gallicchio/motor-pid/out/motorpid/motorpid-stats.txt

PCB statistics report
=====================
- Date: 2026-10-29
- Project: motorpid
- Board name: motorpid

Board
-----
- Width: 170.0000 mm
- Height: 120.0000 mm
- Area: 20392.261 mm²
- Front copper area: 3160.727 mm²
- Back copper area: 19553.33 mm²
- Min track clearance: 0.3000 mm
- Min track width: 0.3500 mm
- Min drill diameter: 0.3000 mm
- Board stackup thickness: 1.6000 mm

- Front footprint area: 3687.488 mm²
- Back footprint area: 279.936 mm²
- Front component density: 18.08 %
- Back component density: 1.37 %
Pads
----
- Through hole: 40
- SMD: 229
- Connector: 0
- NPTH: 14
- Castellated: 0
- Press-fit: 0

Vias
----
- Through vias: 75
- Blind vias: 0
- Buried vias: 0
- Micro vias: 0

Components
----------

| | Front Side | Back Side | Total |
|---|---|---|---|
|THT: | 11 | 0 | 11 |
|SMD: | 95 | 0 | 95 |
|Unspecified:  | 4 | 0 | 4 |
|Total: | 110 | 0 | 110 |

Drill holes
-----------

| Count | Shape | X Size | Y Size | Plated | Via/Pad | Start Layer | Stop Layer |
|---|---|---|---|---|---|---|---|
| 75 | Round | 0.3000 mm | 0.3000 mm | PTH | Via | F.Cu | B.Cu |
| 21 | Round | 1.4000 mm | 1.4000 mm | PTH | Pad | F.Cu | B.Cu |
| 10 |  Slot | 0.9000 mm | 1.4500 mm | NPTH | Pad | F.Cu | B.Cu |
| 9 | Round | 0.9000 mm | 0.9000 mm | PTH | Pad | F.Cu | B.Cu |
| 4 | Round | 3.2000 mm | 3.2000 mm | NPTH | Pad | F.Cu | B.Cu |
| 3 | Round | 1.3000 mm | 1.3000 mm | PTH | Pad | F.Cu | B.Cu |
| 3 | Round | 1.0000 mm | 1.0000 mm | PTH | Pad | F.Cu | B.Cu |
| 2 | Round | 1.2000 mm | 1.2000 mm | PTH | Pad | F.Cu | B.Cu |
| 2 |  Slot | 2.1000 mm | 1.8000 mm | PTH | Pad | F.Cu | B.Cu |
