gallicchio/motor-pid/design_reviews/2026-10-26_Claude-Opus-5.5/q_tr.png

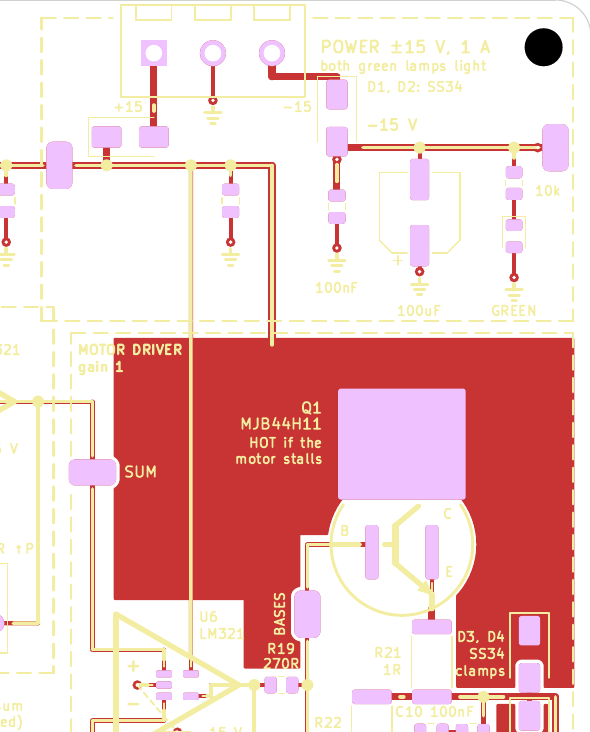
design_reviews/2026-10-26_Claude-Opus-5.5/q_tr.png
