gallicchio/motor-pid/design_reviews/2026-10-26_Claude-Opus-5.5/z_patch_sw12.png

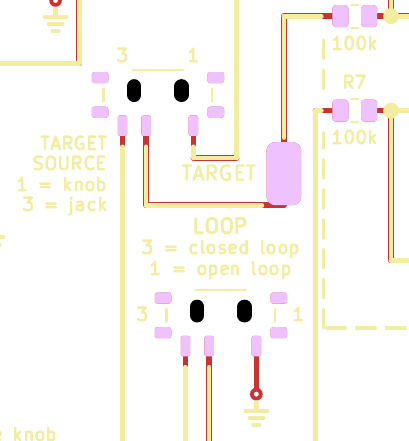
design_reviews/2026-10-26_Claude-Opus-5.5/z_patch_sw12.png
