gallicchio/motor-pid/design_reviews/2026-10-27_KimiK3/bot_q4.png

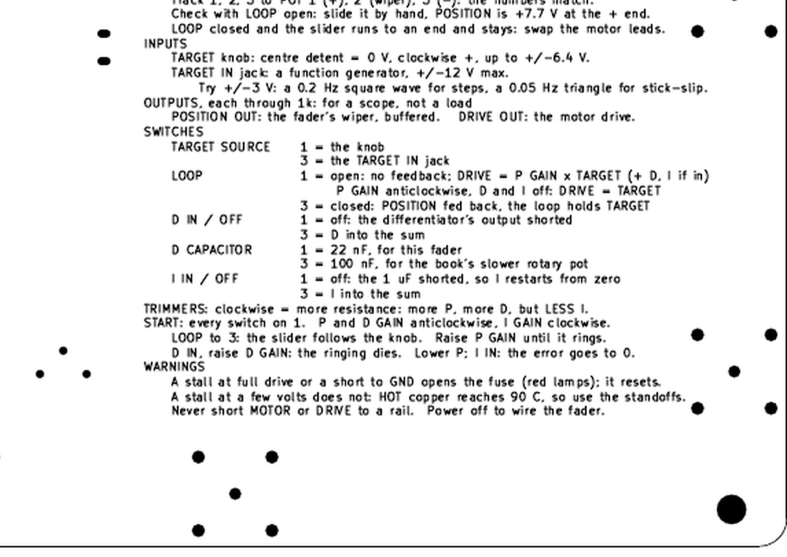
design_reviews/2026-10-27_KimiK3/bot_q4.png
