gallicchio/motor-pid/design_reviews/2026-10-27_KimiK3/sch_targetin.png

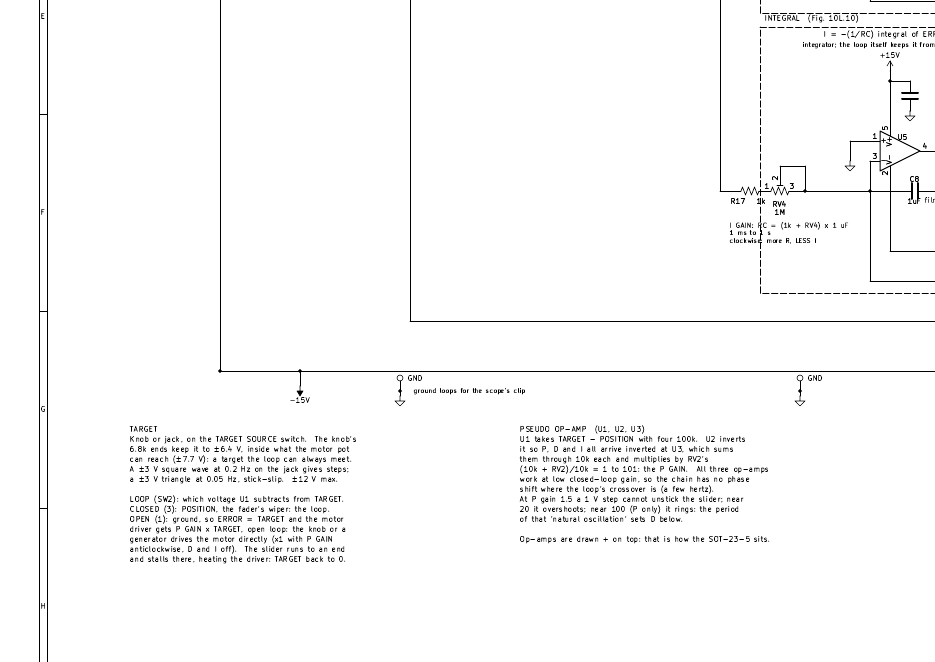
design_reviews/2026-10-27_KimiK3/sch_targetin.png
