gallicchio/motor-pid/design_reviews/2026-10-27_KimiK3/sch_titleblock.png

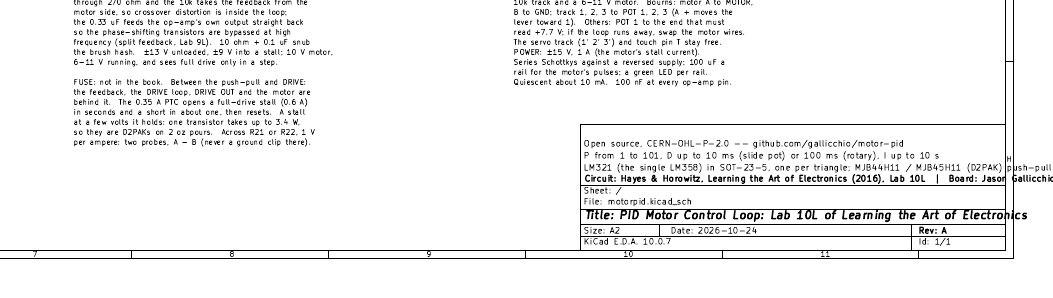
design_reviews/2026-10-27_KimiK3/sch_titleblock.png
