gallicchio/motor-pid/design_reviews/2026-10-27_KimiK3/schpage-1.png

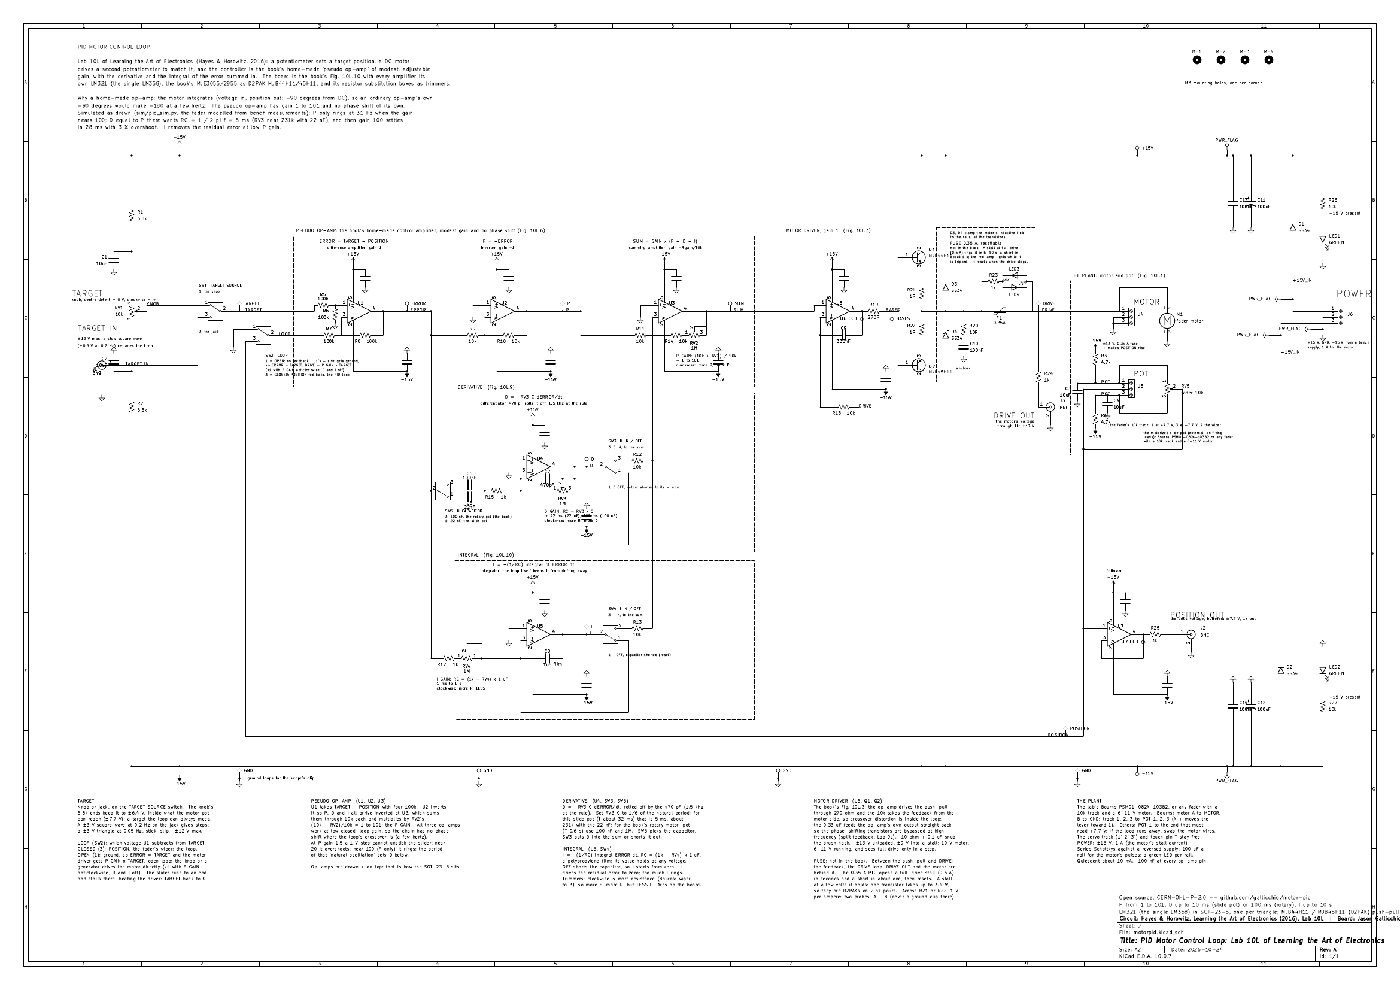
design_reviews/2026-10-27_KimiK3/schpage-1.png
