gallicchio/motor-pid/design_reviews/2026-10-27_KimiK3/sw1_silk.png

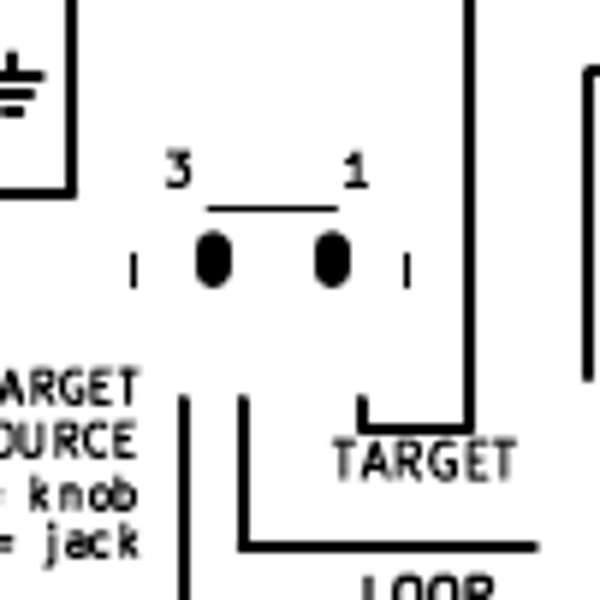
design_reviews/2026-10-27_KimiK3/sw1_silk.png
