gallicchio/motor-pid/design_reviews/2026-10-27_KimiK3/sw3_silk.png

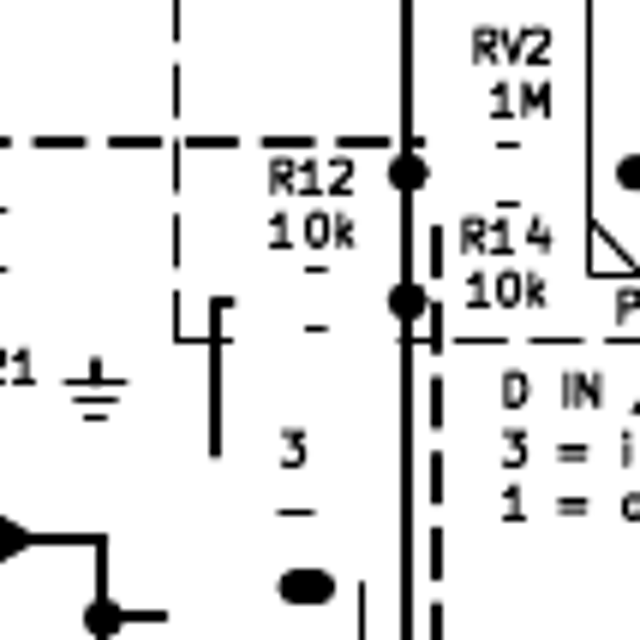
design_reviews/2026-10-27_KimiK3/sw3_silk.png
