gallicchio/motor-pid/design_reviews/2026-10-27_KimiK3/top_q4.png

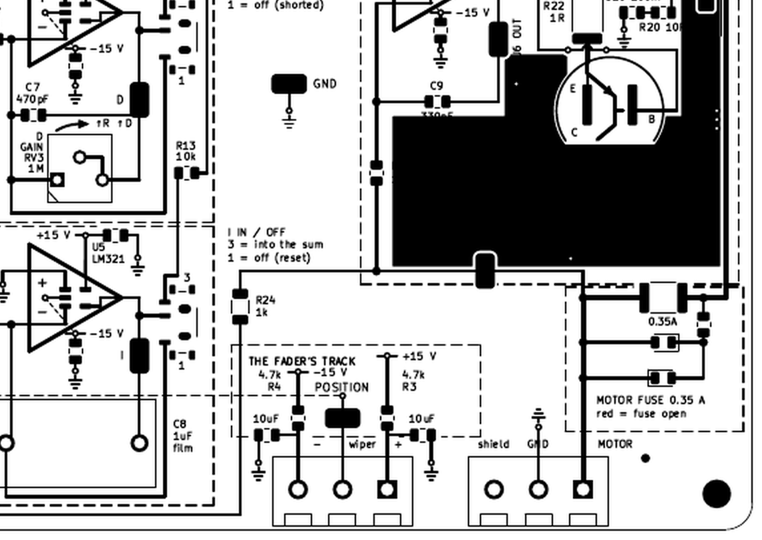
design_reviews/2026-10-27_KimiK3/top_q4.png
