gallicchio/motor-pid/docs/images/motorpid-bottom.png

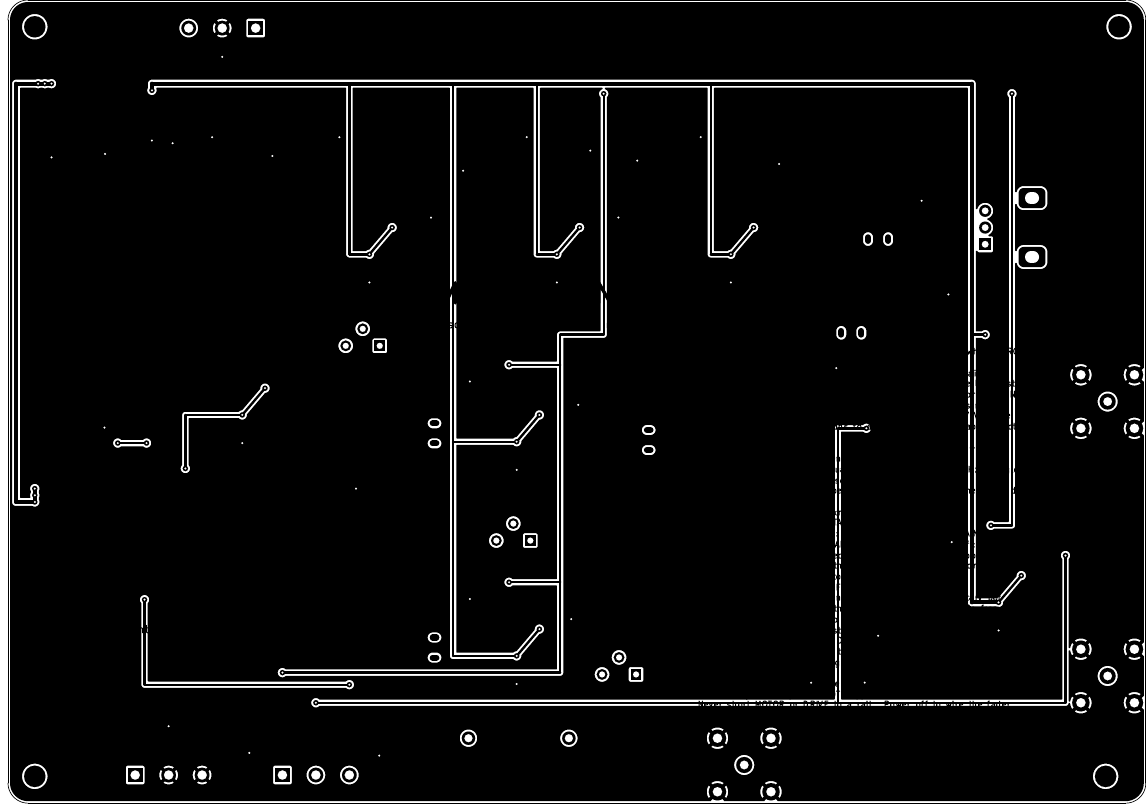
docs/images/motorpid-bottom.png
