gallicchio/motor-pid/docs/images/motorpid-render-bottom.png

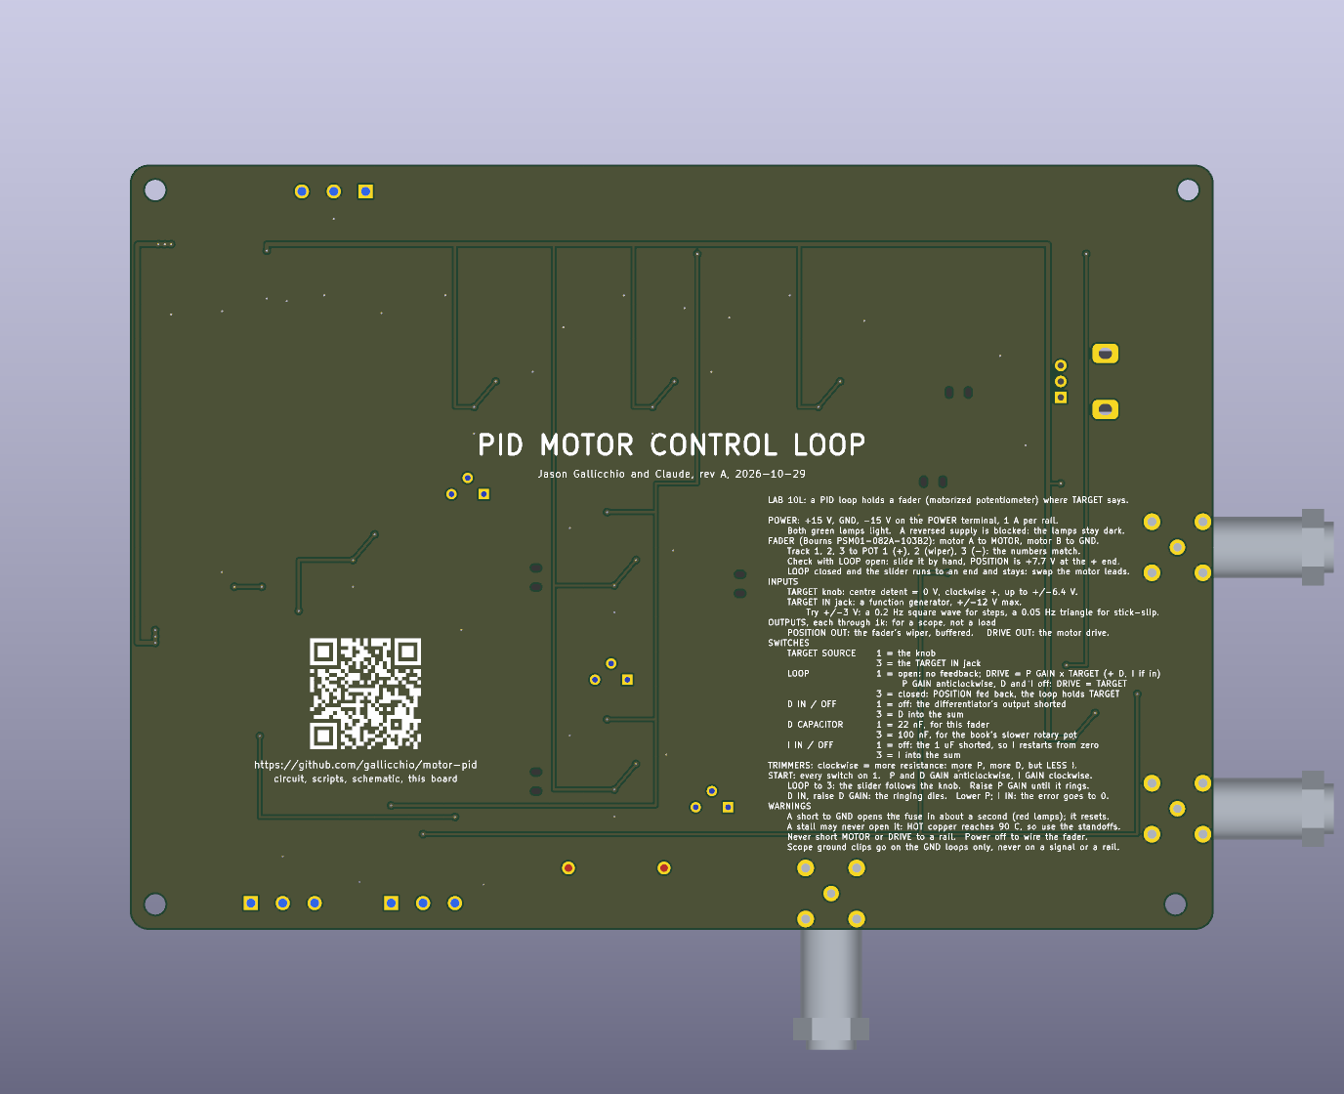
docs/images/motorpid-render-bottom.png
