gallicchio/motor-pid/docs/images/motorpid-render-iso.png

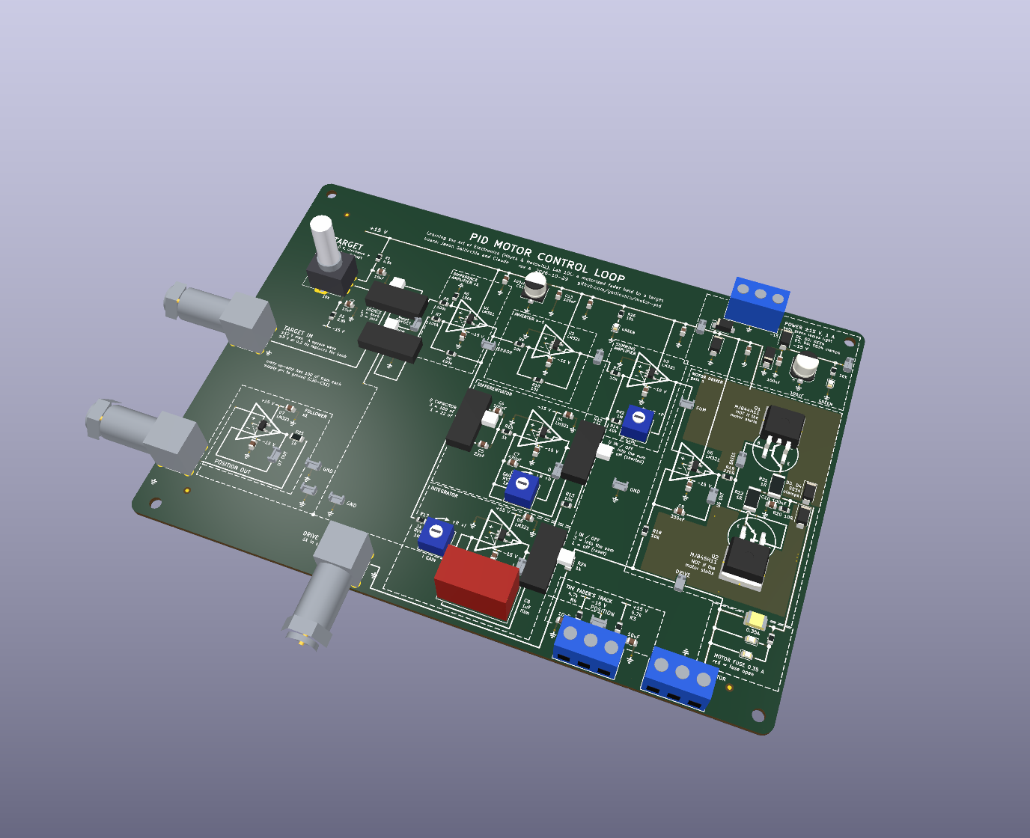
docs/images/motorpid-render-iso.png
