gallicchio/motor-pid/docs/images/motorpid-silk-top.png

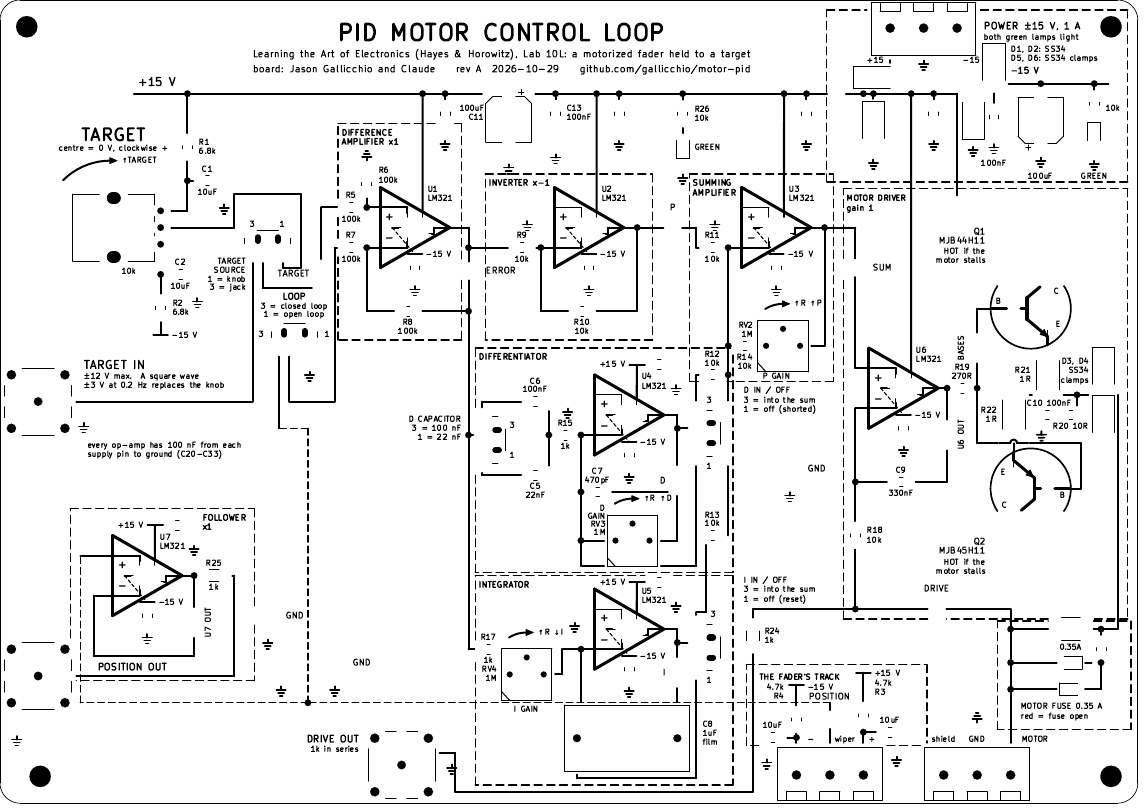
docs/images/motorpid-silk-top.png
