gallicchio/motor-pid/docs/images/motorpid-top.png

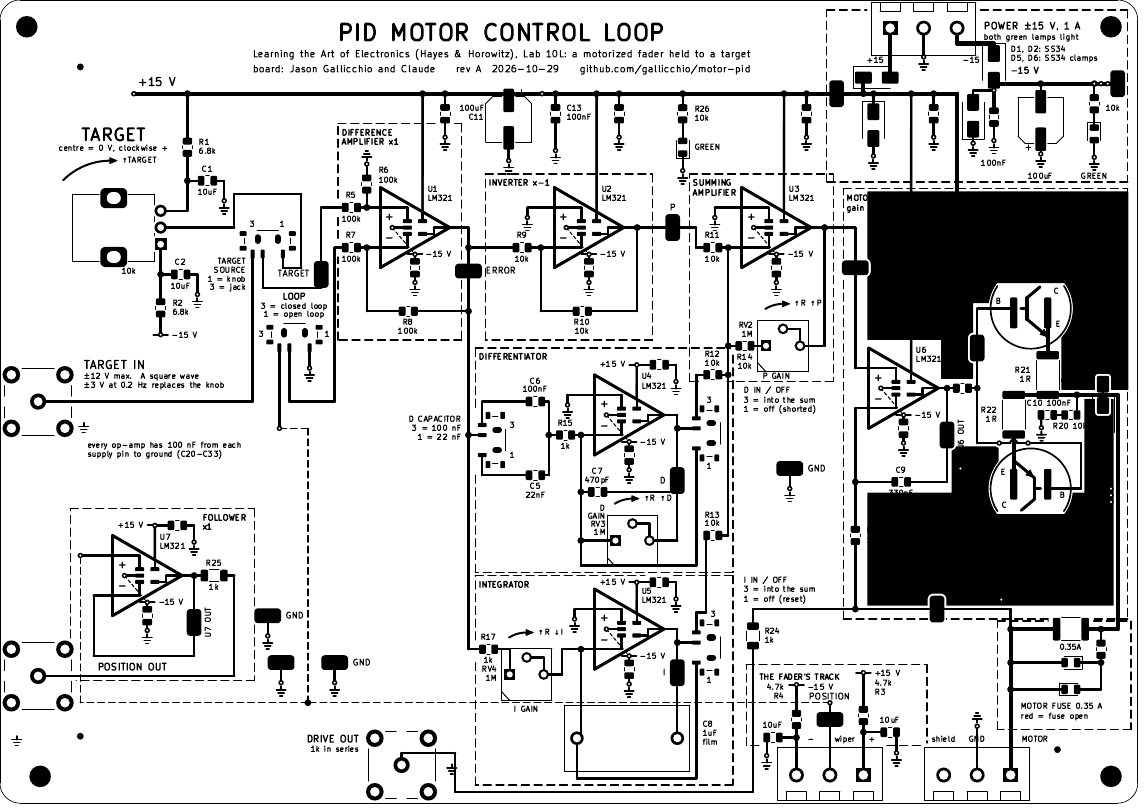
docs/images/motorpid-top.png
