gallicchio/motor-pid/docs/images/schematic.png

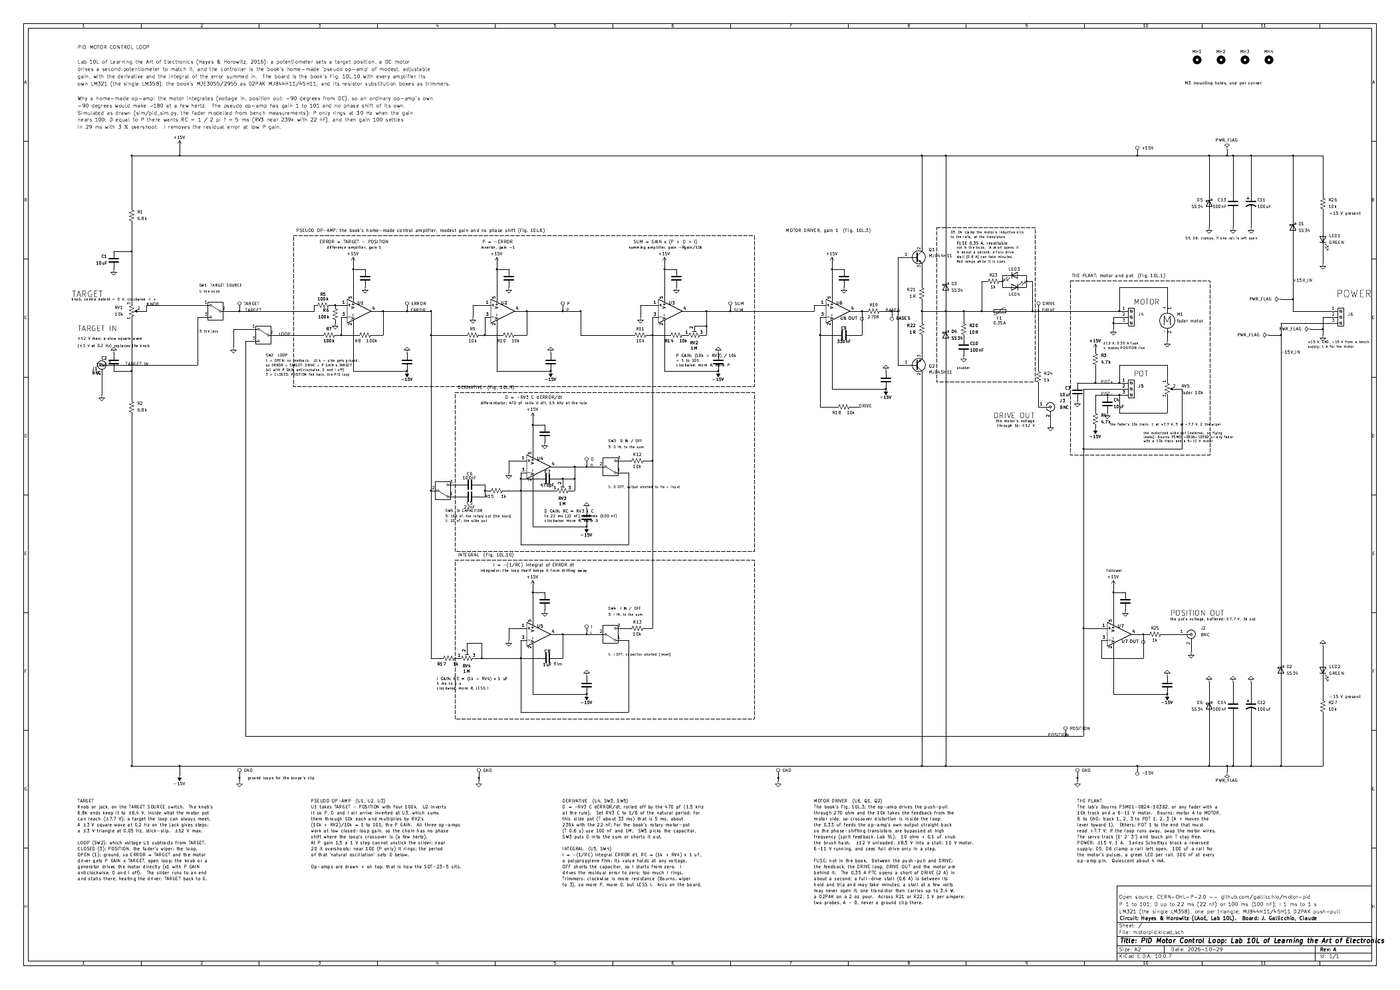
docs/images/schematic.png
