gallicchio/motor-pid/docs/images/sim-p-only.png

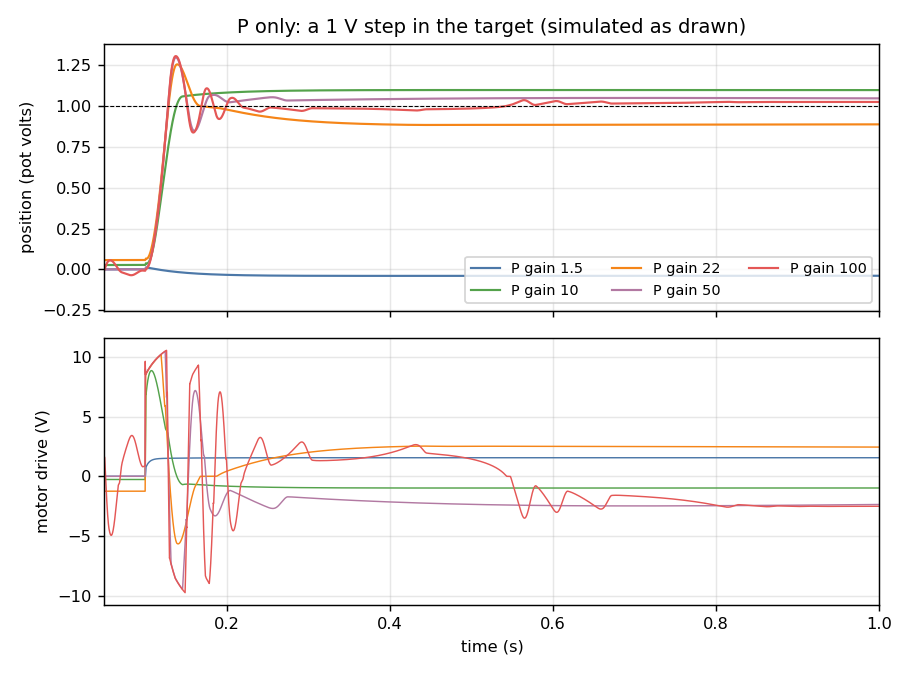
docs/images/sim-p-only.png
