gallicchio/motor-pid/docs/images/sim-pd.png

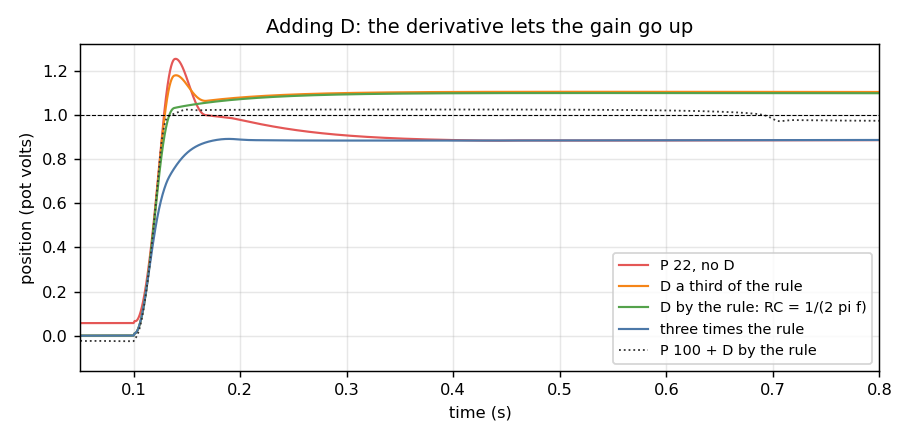
docs/images/sim-pd.png
