gallicchio/motor-pid/docs/images/sim-pid.png

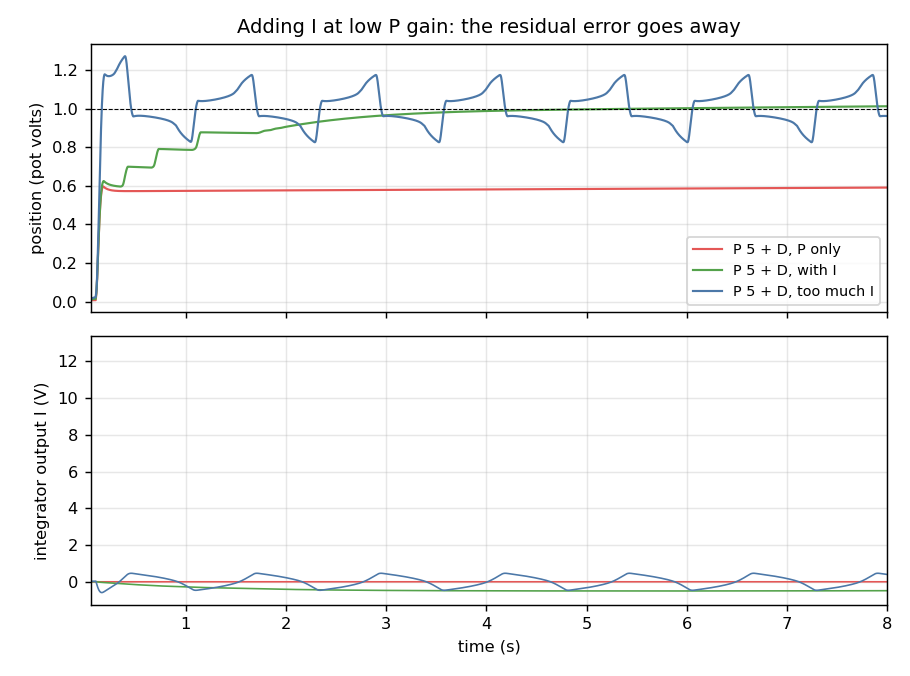
docs/images/sim-pid.png
