gallicchio/motor-pid/docs/images/sim-triangle.png

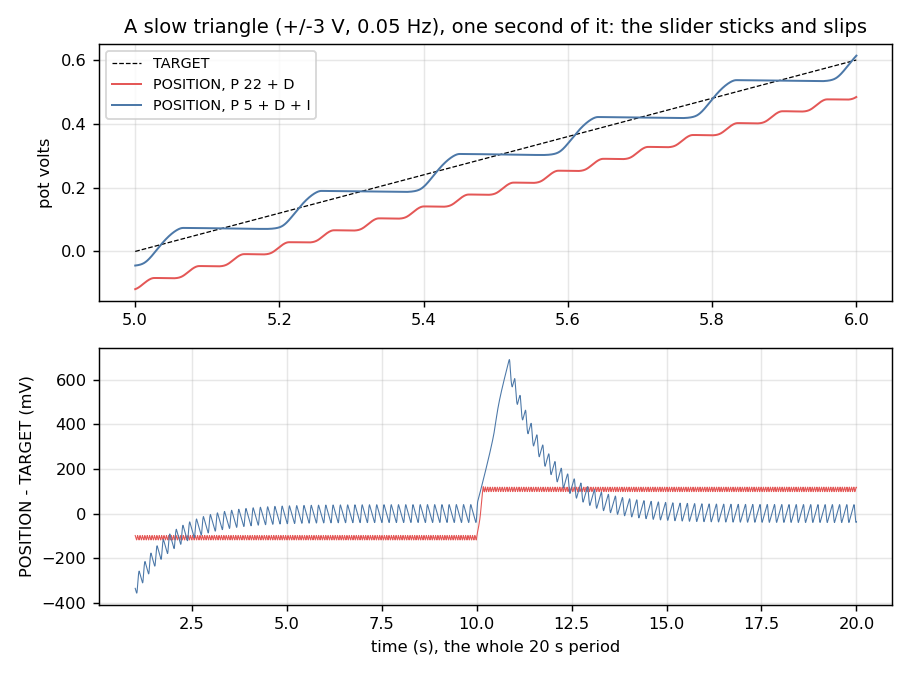
docs/images/sim-triangle.png
