gallicchio/motor-pid/out/motorpid/motorpid_bom_costed.csv

Comment | Designator | Footprint | LCSC Part # | MPN | Qty | Unit $ | Ext $ | JLC
22nF | C5 | C_0805_2012Metric | C1729 | CL21B223KBANNNC | 1 | 0.0084 | 0.008 | basic
470pF | C7 | C_0805_2012Metric | C1743 | 0805B471K500NT | 1 | 0.0075 | 0.007 | basic
1uF | C8 | C_Film_Panasonic_ECWF_L18.1mm_W9.3mm_P15.00mm | C242107 | ECWF2W105JA | 1 | 0.3259 | 0.326 | extended
330nF | C9 | C_0805_2012Metric | C1740 | 0805B334K500NT | 1 | 0.0207 | 0.021 | preferred
100uF | C11,C12 | CP_Elec_6.3x5.4 | C46550402 | JVJ25V100M6x5 | 2 | 0.0423 | 0.085 | extended
10uF | C1,C2,C3,C4 | C_0805_2012Metric | C15850 | CL21A106KAYNNNE | 4 | 0.0426 | 0.170 | basic
100nF | C6,C10,C13,C14,C20,C21,C22,C23,C24,C25,C26,C27,C28,C29,C30,C31,C32,C33 | C_0805_2012Metric | C49678 | CC0805KRX7R9BB104 | 18 | 0.0205 | 0.369 | basic
SS34 | D1,D2,D3,D4,D5,D6 | D_SMA | C8678 | SS34 | 6 | 0.0351 | 0.211 | basic
0.35A | F1 | Fuse_1812_4532Metric | C18198330 | 1812L035/60GR | 1 | 0.0667 | 0.067 | extended
MOTOR + - shield | J4 | TerminalBlock_KF301_1x03_P5.00mm | C474882 | KF301-5.0-3P | 1 | 0.1396 | 0.140 | extended
POT 1 (+) 2 (wiper) 3 (-) | J5 | TerminalBlock_KF301_1x03_P5.00mm | C474882 | KF301-5.0-3P | 1 | 0.1396 | 0.140 | extended
+15 / GND / -15 | J6 | TerminalBlock_KF301_1x03_P5.00mm | C474882 | KF301-5.0-3P | 1 | 0.1396 | 0.140 | extended
BNC | J1,J2,J3 | BNC_KYWE_RightAngle | C41416668 | BNC-KYWE-295-W4-N | 3 | 1.2929 | 3.879 | extended
GREEN | LED1,LED2 | LED_0805_2012Metric | C2297 | KT-0805G | 2 | 0.0164 | 0.033 | basic
RED | LED3,LED4 | LED_0805_2012Metric | C84256 | NCD0805R1 | 2 | 0.0135 | 0.027 | basic
MJB44H11 | Q1 | TO-263-2 | C233689 | MJB44H11T4G | 1 | 1.2244 | 1.224 | extended
MJB45H11 | Q2 | TO-263-2 | C154570 | MJB45H11T4G | 1 | 1.1573 | 1.157 | extended
270R | R19 | R_0805_2012Metric | C17590 | 0805W8F2700T5E | 1 | 0.0070 | 0.007 | preferred
10R | R20 | R_0805_2012Metric | C17415 | 0805W8F100JT5E | 1 | 0.0040 | 0.004 | basic
10k | RV1 | Potentiometer_Alps_RK09K_Single_Vertical | C351173 | RK09K1130A70 | 1 | 0.5335 | 0.533 | extended
6.8k | R1,R2 | R_0805_2012Metric | C17772 | 0805W8F6801T5E | 2 | 0.0029 | 0.006 | basic
4.7k | R3,R4 | R_0805_2012Metric | C17673 | 0805W8F4701T5E | 2 | 0.0051 | 0.010 | basic
1R | R21,R22 | R_2512_6332Metric | C3000711 | FRC2512J1R0TS | 2 | 0.0313 | 0.063 | extended
1k | R24,R25 | R_1206_3216Metric | C4410 | 1206W4F1001T5E | 2 | 0.0085 | 0.017 | basic
1k | R15,R17,R23 | R_0805_2012Metric | C17513 | 0805W8F1001T5E | 3 | 0.0035 | 0.011 | basic
100k | R5,R6,R7,R8 | R_0805_2012Metric | C149504 | 0805W8F1003T5E | 4 | 0.0059 | 0.024 | basic
1M | RV2,RV3,RV4 | Potentiometer_Bourns_3362P_Vertical | C118945 | 3362P-1-105 | 3 | 0.1585 | 0.476 | extended
10k | R9,R10,R11,R12,R13,R14,R18,R26,R27 | R_0805_2012Metric | C17414 | 0805W8F1002T5E | 9 | 0.0034 | 0.031 | basic
TARGET SOURCE | SW1 | SW_SPDT_Shouhan_MSK12C02 | C431540 | MSK12C02 | 1 | 0.0544 | 0.054 | extended
LOOP | SW2 | SW_SPDT_Shouhan_MSK12C02 | C431540 | MSK12C02 | 1 | 0.0544 | 0.054 | extended
D IN / OFF | SW3 | SW_SPDT_Shouhan_MSK12C02 | C431540 | MSK12C02 | 1 | 0.0544 | 0.054 | extended
I IN / OFF | SW4 | SW_SPDT_Shouhan_MSK12C02 | C431540 | MSK12C02 | 1 | 0.0544 | 0.054 | extended
D CAPACITOR | SW5 | SW_SPDT_Shouhan_MSK12C02 | C431540 | MSK12C02 | 1 | 0.0544 | 0.054 | extended
TARGET | TP1 | TestPoint_Loop_RH-5019 | C5199800 | RH-5019 | 1 | 0.0966 | 0.097 | extended
ERROR | TP2 | TestPoint_Loop_RH-5019 | C5199800 | RH-5019 | 1 | 0.0966 | 0.097 | extended
P | TP3 | TestPoint_Loop_RH-5019 | C5199800 | RH-5019 | 1 | 0.0966 | 0.097 | extended
D | TP4 | TestPoint_Loop_RH-5019 | C5199800 | RH-5019 | 1 | 0.0966 | 0.097 | extended
I | TP5 | TestPoint_Loop_RH-5019 | C5199800 | RH-5019 | 1 | 0.0966 | 0.097 | extended
SUM | TP6 | TestPoint_Loop_RH-5019 | C5199800 | RH-5019 | 1 | 0.0966 | 0.097 | extended
DRIVE | TP7 | TestPoint_Loop_RH-5019 | C5199800 | RH-5019 | 1 | 0.0966 | 0.097 | extended
POSITION | TP8 | TestPoint_Loop_RH-5019 | C5199800 | RH-5019 | 1 | 0.0966 | 0.097 | extended
+15V | TP9 | TestPoint_Loop_RH-5019 | C5199800 | RH-5019 | 1 | 0.0966 | 0.097 | extended
-15V | TP10 | TestPoint_Loop_RH-5019 | C5199800 | RH-5019 | 1 | 0.0966 | 0.097 | extended
BASES | TP11 | TestPoint_Loop_RH-5019 | C5199800 | RH-5019 | 1 | 0.0966 | 0.097 | extended
U6 OUT | TP12 | TestPoint_Loop_RH-5019 | C5199800 | RH-5019 | 1 | 0.0966 | 0.097 | extended
U7 OUT | TP13 | TestPoint_Loop_RH-5019 | C5199800 | RH-5019 | 1 | 0.0966 | 0.097 | extended
GND | TP100,TP101,TP102,TP103 | TestPoint_Loop_RH-5019 | C5199800 | RH-5019 | 4 | 0.0966 | 0.386 | extended
LM321 | U1,U2,U3,U4,U5,U6,U7 | SOT-23-5 | C9405 | LM321MFX/NOPB | 7 | 0.1578 | 1.105 | extended
