gallicchio/motor-pid/docs/images/sim-big-step.png

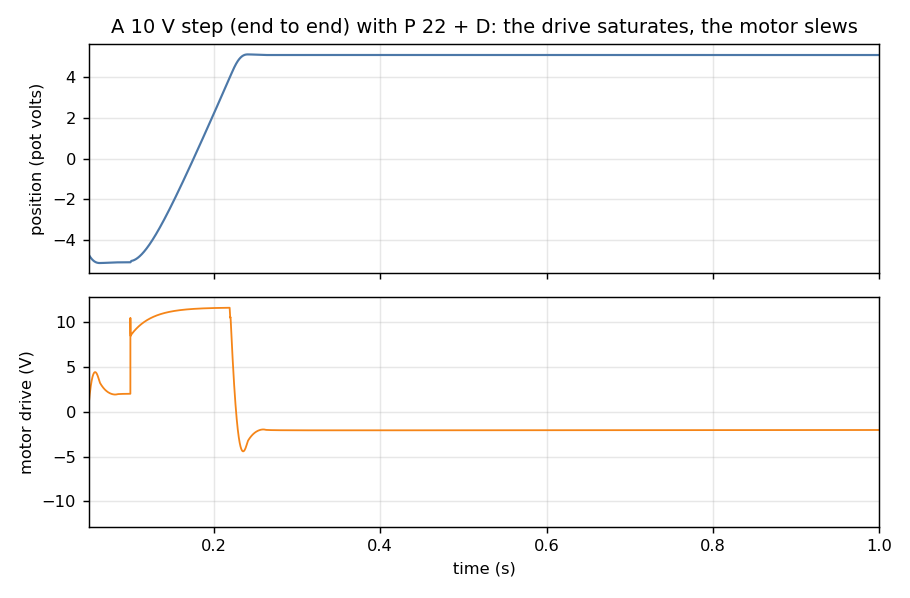
docs/images/sim-big-step.png
