gallicchio/motor-pid/docs/history/r1-render-bottom.png

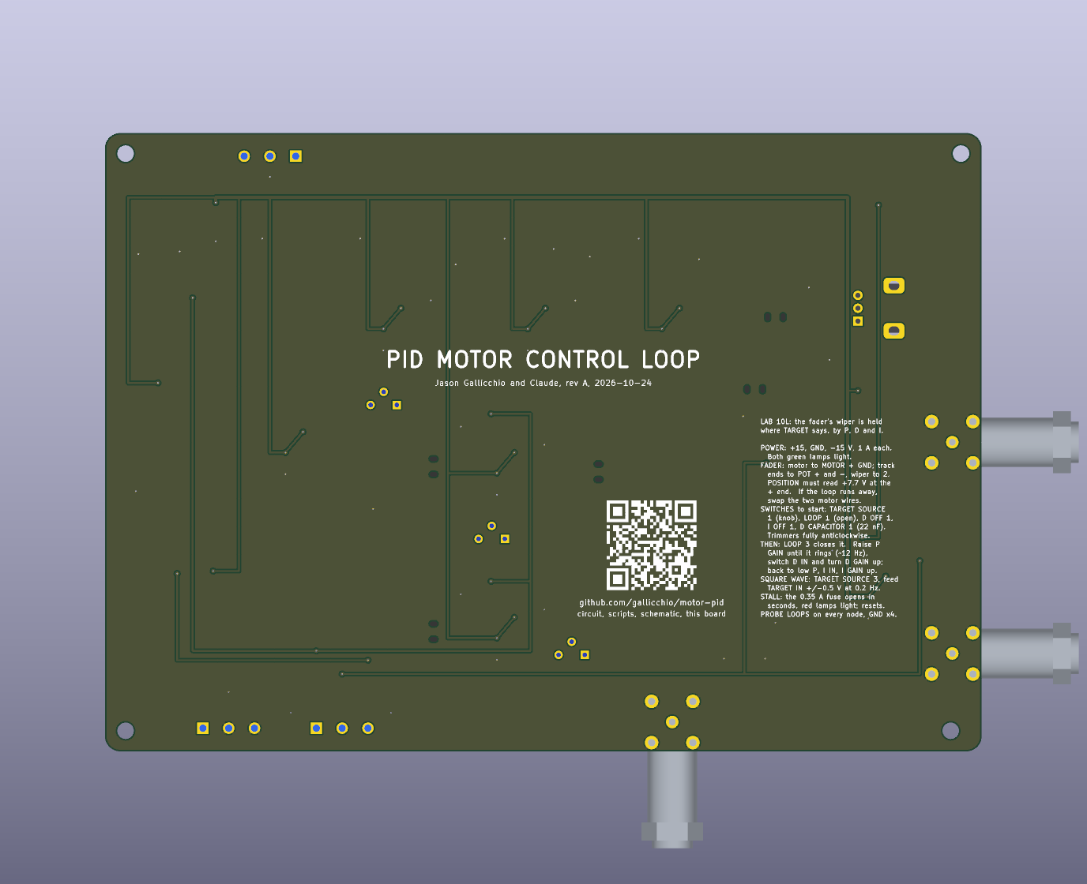
docs/history/r1-render-bottom.png
