gallicchio/motor-pid/docs/history/r1-silk-top.png

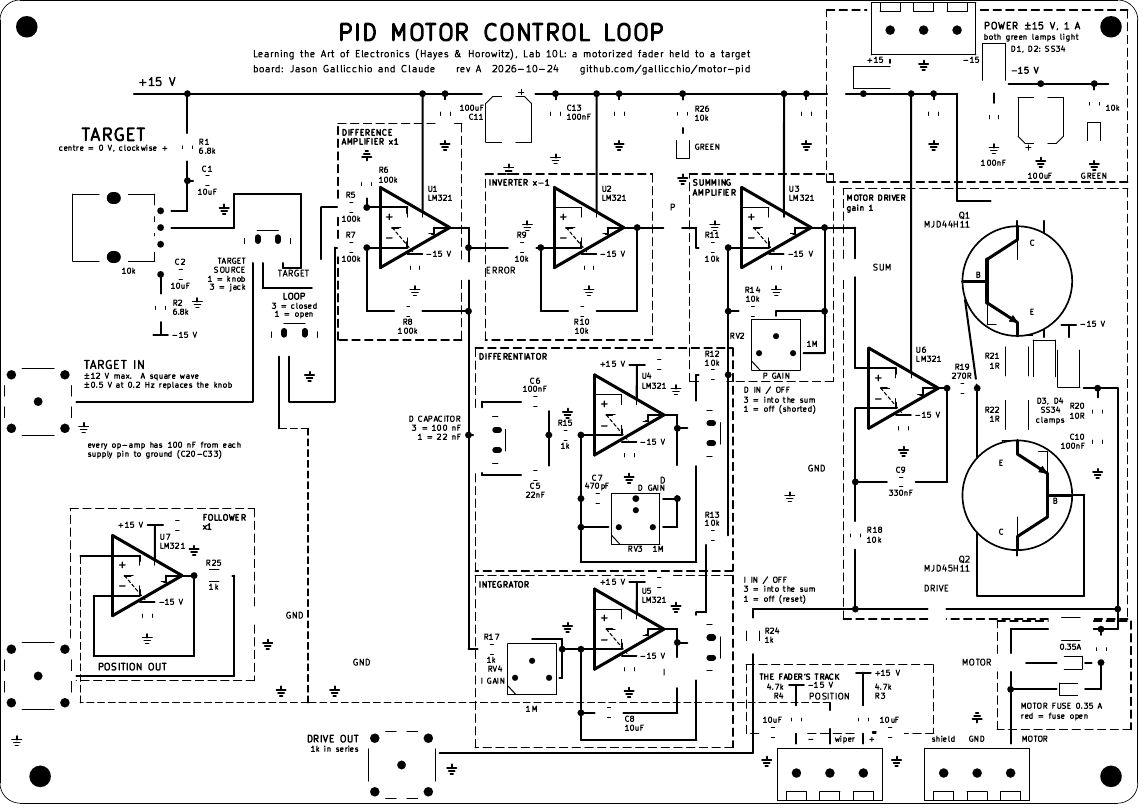
docs/history/r1-silk-top.png
