gallicchio/motor-pid/out/motorpid/motorpid-assembly-top.pdf

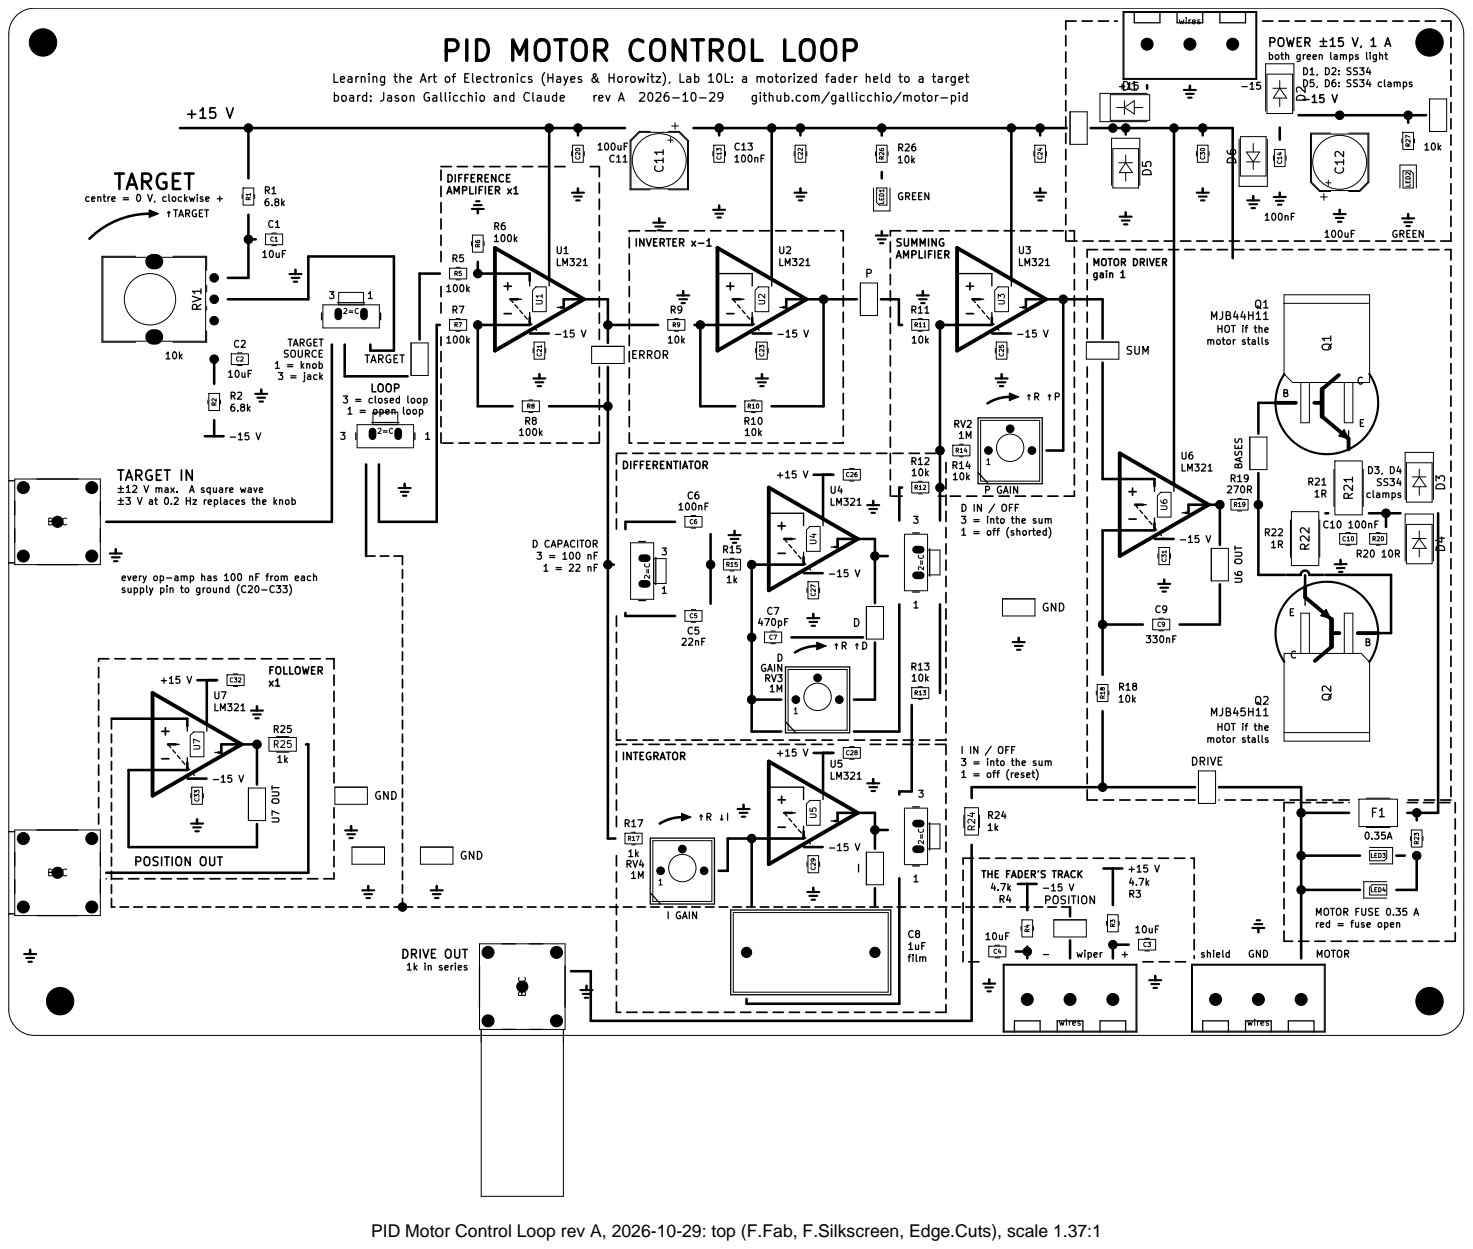
[picture p51: page 1]

PID MOTOR CONTROL LOOP

POWER ±15 V, 1 A
both green lamps light

Learning the Art of Electronics (Hayes & Horowitz), Lab 10L: a motorized fader held to a target

TARGET IN
±12 V max. A square wave
±3 V at 0.2 Hz replaces the knob

every op-amp has 100 nF from each
supply pin to ground (C20-C33)

PID Motor Control Loop rev A, 2026-10-29: top (F.Fab, F.Silkscreen, Edge.Cuts), scale 1.37:1
