gallicchio/motor-pid/out/motorpid/motorpid-schematic.pdf

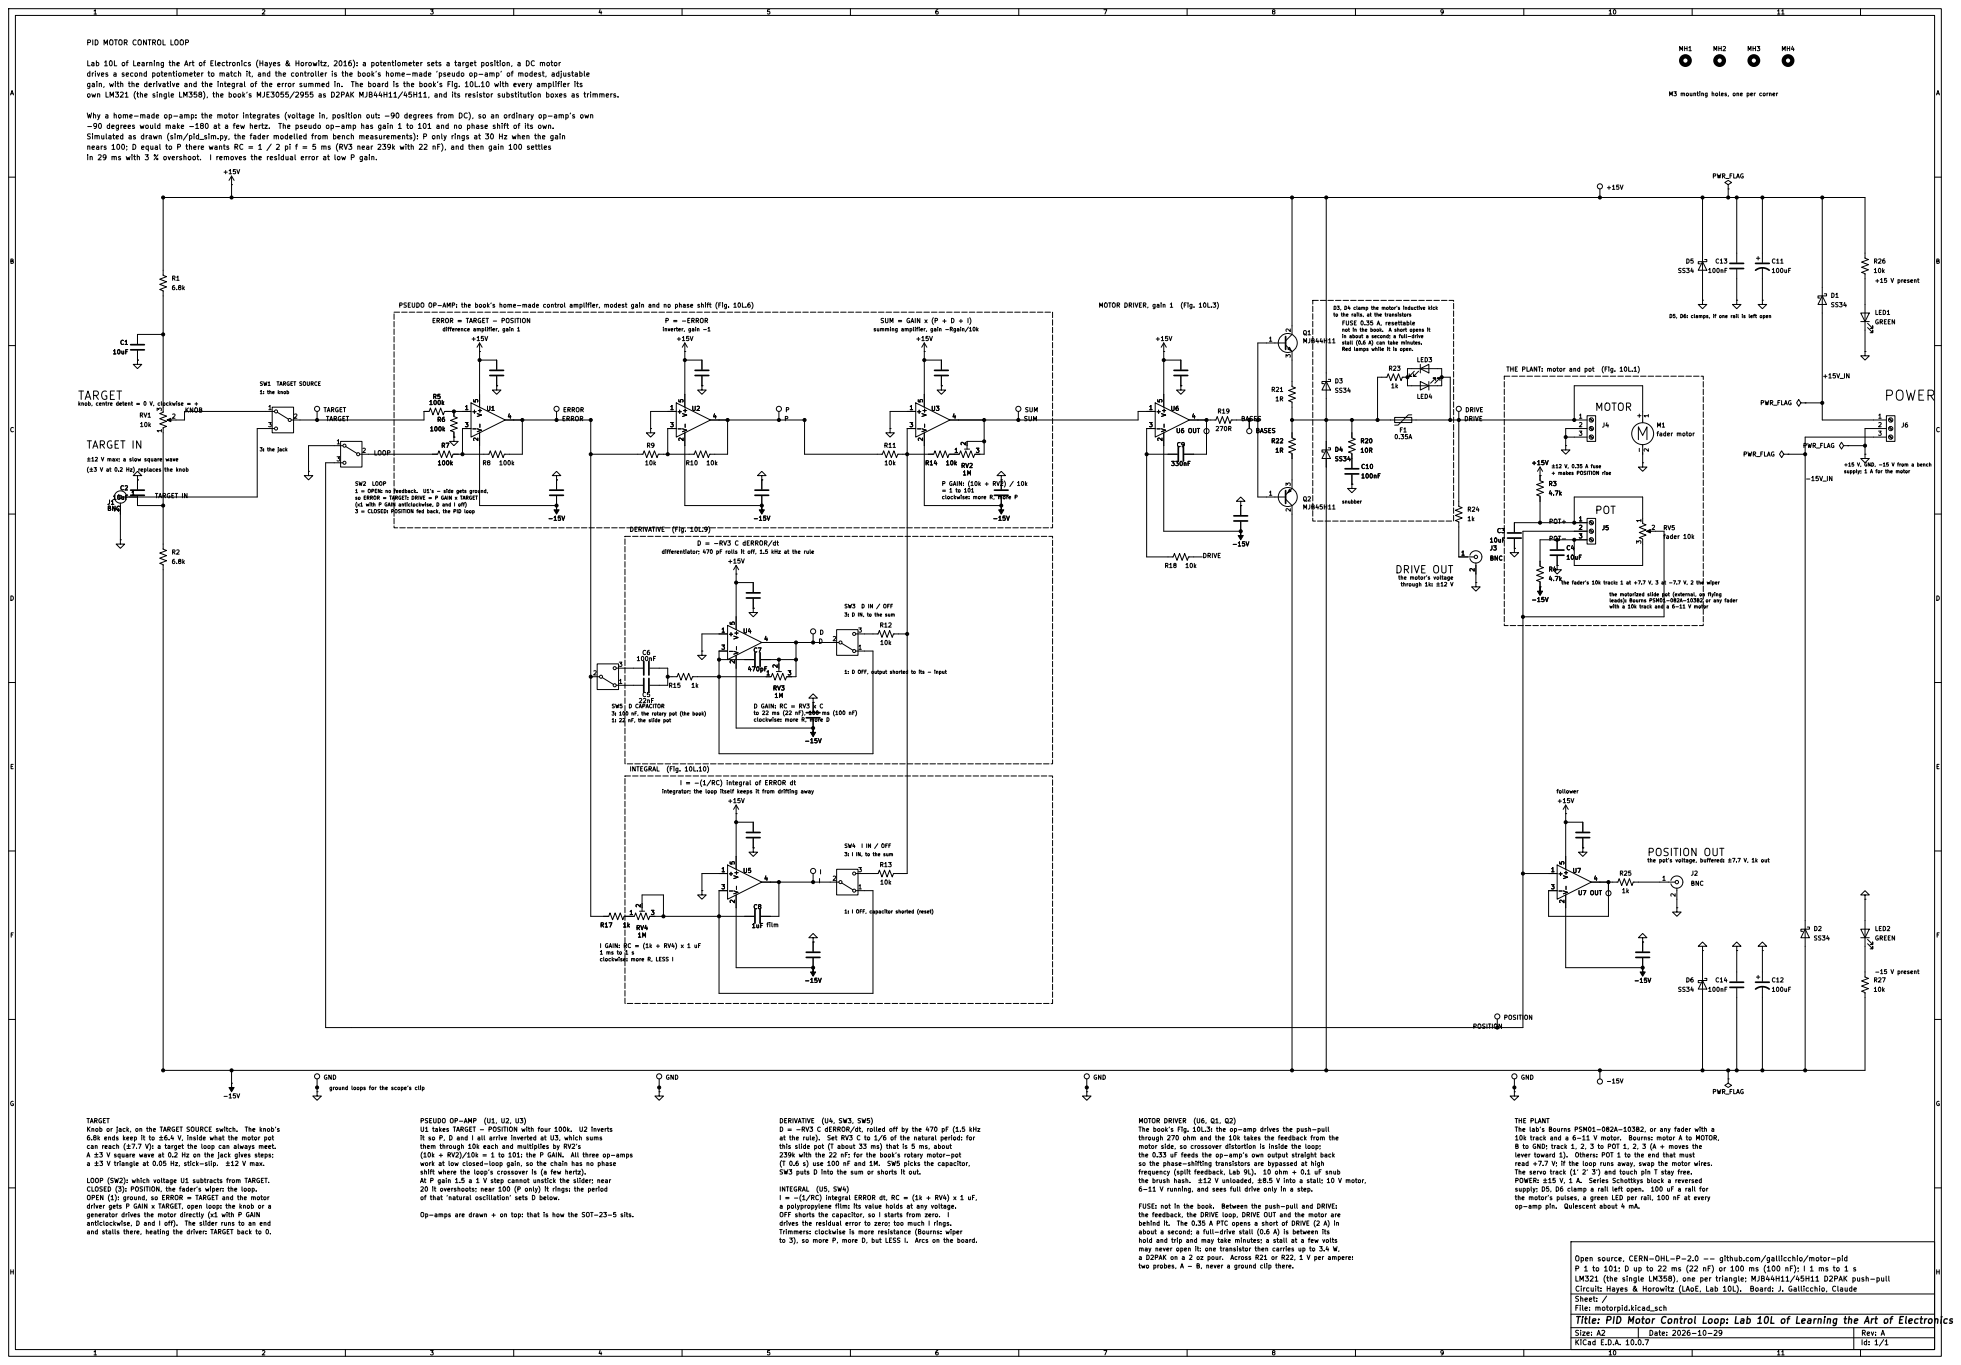
[picture p52: page 1]

-90 degrees would make -180 at a few hertz. The pseudo op-amp has gain 1 to 101 and no phase shift of its own. PID MOTOR CONTROL LOOP

gain, with the derivative and the integral of the error summed in. The board is the book's Fig. 10L.10 with every amplifier its
own LM321 (the single LM358), the book's MJE3055/2955 as D2PAK MJB44H11/45H11, and its resistor substitution boxes as trimmers.

M3 mounting holes, one per corner D5, D6: clamps, if one rail is left open Red lamps while it is open.

inverter, gain -1 Why a home-made op-amp: the motor integrates (voltage in, position out: -90 degrees from DC), so an ordinary op-amp's own

Simulated as drawn (sim/pid_sim.py, the fader modelled from bench measurements): P only rings at 30 Hz when the gain

in 29 ms with 3 % overshoot. I removes the residual error at low P gain.

PSEUDO OP-AMP: the book's home-made control amplifier, modest gain and no phase shift (Fig. 10L.6)

MOTOR DRIVER, gain 1 (Fig. 10L.3) = 1 to 101

not in the book. A short opens it D3, D4 clamp the motor's inductive kick in about a second; a full-drive stall (0.6 A) can take minutes. 10R 10R | LED3 0.35A BASESR22

supply; 1 A for the motor +15 V, GND, -15 V from a bench FUSE 0.35 A, resettable

summing amplifier, gain -Rgain/10k SW2 LOOP TARGET IN

3: the jack SW1 TARGET SOURCE
1: the knob

knob, centre detent = 0 V, clockwise = + TARGET

R3 4.7k | fader motor 1

clockwise: more R, more P
SW3 D IN / OFF 1: D OFF, output shorted to its - input 1: I OFF, capacitor shorted (reset) SW4 I IN / OFF 3: I IN, to the sum
3: D IN, to the sum

INTEGRAL (Fig. 10L.10) differentiator; 470 pF rolls it off, 1.5 kHz at the rule

the motorized slide pot (external, on flying

I = -(1/RC) integral of ERROR dt 239k with the 22 nF; for the book's rotary motor-pot Trimmers: clockwise is more resistance (Bourns: wiper

integrator; the loop itself keeps it from drifting away DERIVATIVE (U4, SW3, SW5)

the pot's voltage, buffered: ±7.7 V, 1k out

GND
ground loops for the scope's clipPSEUDO OP-AMP (U1, U2, U3)

A ±3 V square wave at 0.2 Hz on the jack gives steps; a ±3 V triangle at 0.05 Hz, stick-slip. ±12 V max. TARGET can reach (±7.7 V): a target the loop can always meet. Knob or jack, on the TARGET SOURCE switch. The knob's

through 270 ohm and the 10k takes the feedback from the MOTOR DRIVER (U6, Q1, Q2)
two probes, A - B, never a ground clip there. 6-11 V running, and sees full drive only in a step. may never open it: one transistor then carries up to 3.4 W, a D2PAK on a 2 oz pour. Across R21 or R22, 1 V per ampere: hold and trip and may take minutes; a stall at a few volts about a second; a full-drive stall (0.6 A) is between its behind it. The 0.35 A PTC opens a short of DRIVE (2 A) in motor side, so crossover distortion is inside the loop; The book's Fig. 10L.3: the op-amp drives the push-pull

lever toward 1). Others: POT 1 to the end that must read +7.7 V; if the loop runs away, swap the motor wires. 10k track and a 6-11 V motor. Bourns: motor A to MOTOR, THE PLANT

it so P, D and I all arrive inverted at U3, which sums
them through 10k each and multiplies by RV2's of that 'natural oscillation' sets D below. work at low closed-loop gain, so the chain has no phase 20 it overshoots; near 100 (P only) it rings: the period

I = -(1/RC) integral ERROR dt, RC = (1k + RV4) x 1 uF, to 3), so more P, more D, but LESS I. Arcs on the board. SW3 puts D into the sum or shorts it out. D = -RV3 C dERROR/dt, rolled off by the 470 pF (1.5 kHz at the rule). Set RV3 C to 1/6 of the natural period: for

this slide pot (T about 33 ms) that is 5 ms, about

the 0.33 uF feeds the op-amp's own output straight back
so the phase-shifting transistors are bypassed at high
frequency (split feedback, Lab 9L). 10 ohm + 0.1 uF snub

(T 0.6 s) use 100 nF and 1M. SW5 picks the capacitor,

OPEN (1): ground, so ERROR = TARGET and the motor LOOP (SW2): which voltage U1 subtracts from TARGET.
and stalls there, heating the driver: TARGET back to 0. CLOSED (3): POSITION, the fader's wiper: the loop.

At P gain 1.5 a 1 V step cannot unstick the slider; near shift where the loop's crossover is (a few hertz).

INTEGRAL (U5, SW4) a polypropylene film: its value holds at any voltage.

the motor's pulses, a green LED per rail, 100 nF at every POWER: ±15 V, 1 A. Series Schottkys block a reversed

driver gets P GAIN x TARGET, open loop: the knob or a
generator drives the motor directly (x1 with P GAIN
Op-amps are drawn + on top: that is how the SOT-23-5 sits. anticlockwise, D and I off). The slider runs to an end

P 1 to 101; D up to 22 ms (22 nF) or 100 ms (100 nF); I 1 ms to 1 s Open source, CERN-OHL-P-2.0 -- github.com/gallicchio/motor-pid

LM321 (the single LM358), one per triangle; MJB44H11/45H11 D2PAK push-pull
Circuit: Hayes & Horowitz (LAoE, Lab 10L). Board: J. Gallicchio, Claude
Sheet: /
File: motorpid.kicad_sch
Title: PID Motor Control Loop: Lab 10L of Learning the Art of Electronics

Size: A2 | Rev: A
KiCad E.D.A. 10.0.7 | Id: 1/1
