gallicchio/motor-pid/hardware/motorpid.kicad_pcb

## KiCad design hardware/motorpid.kicad_pcb (2026-10-30)

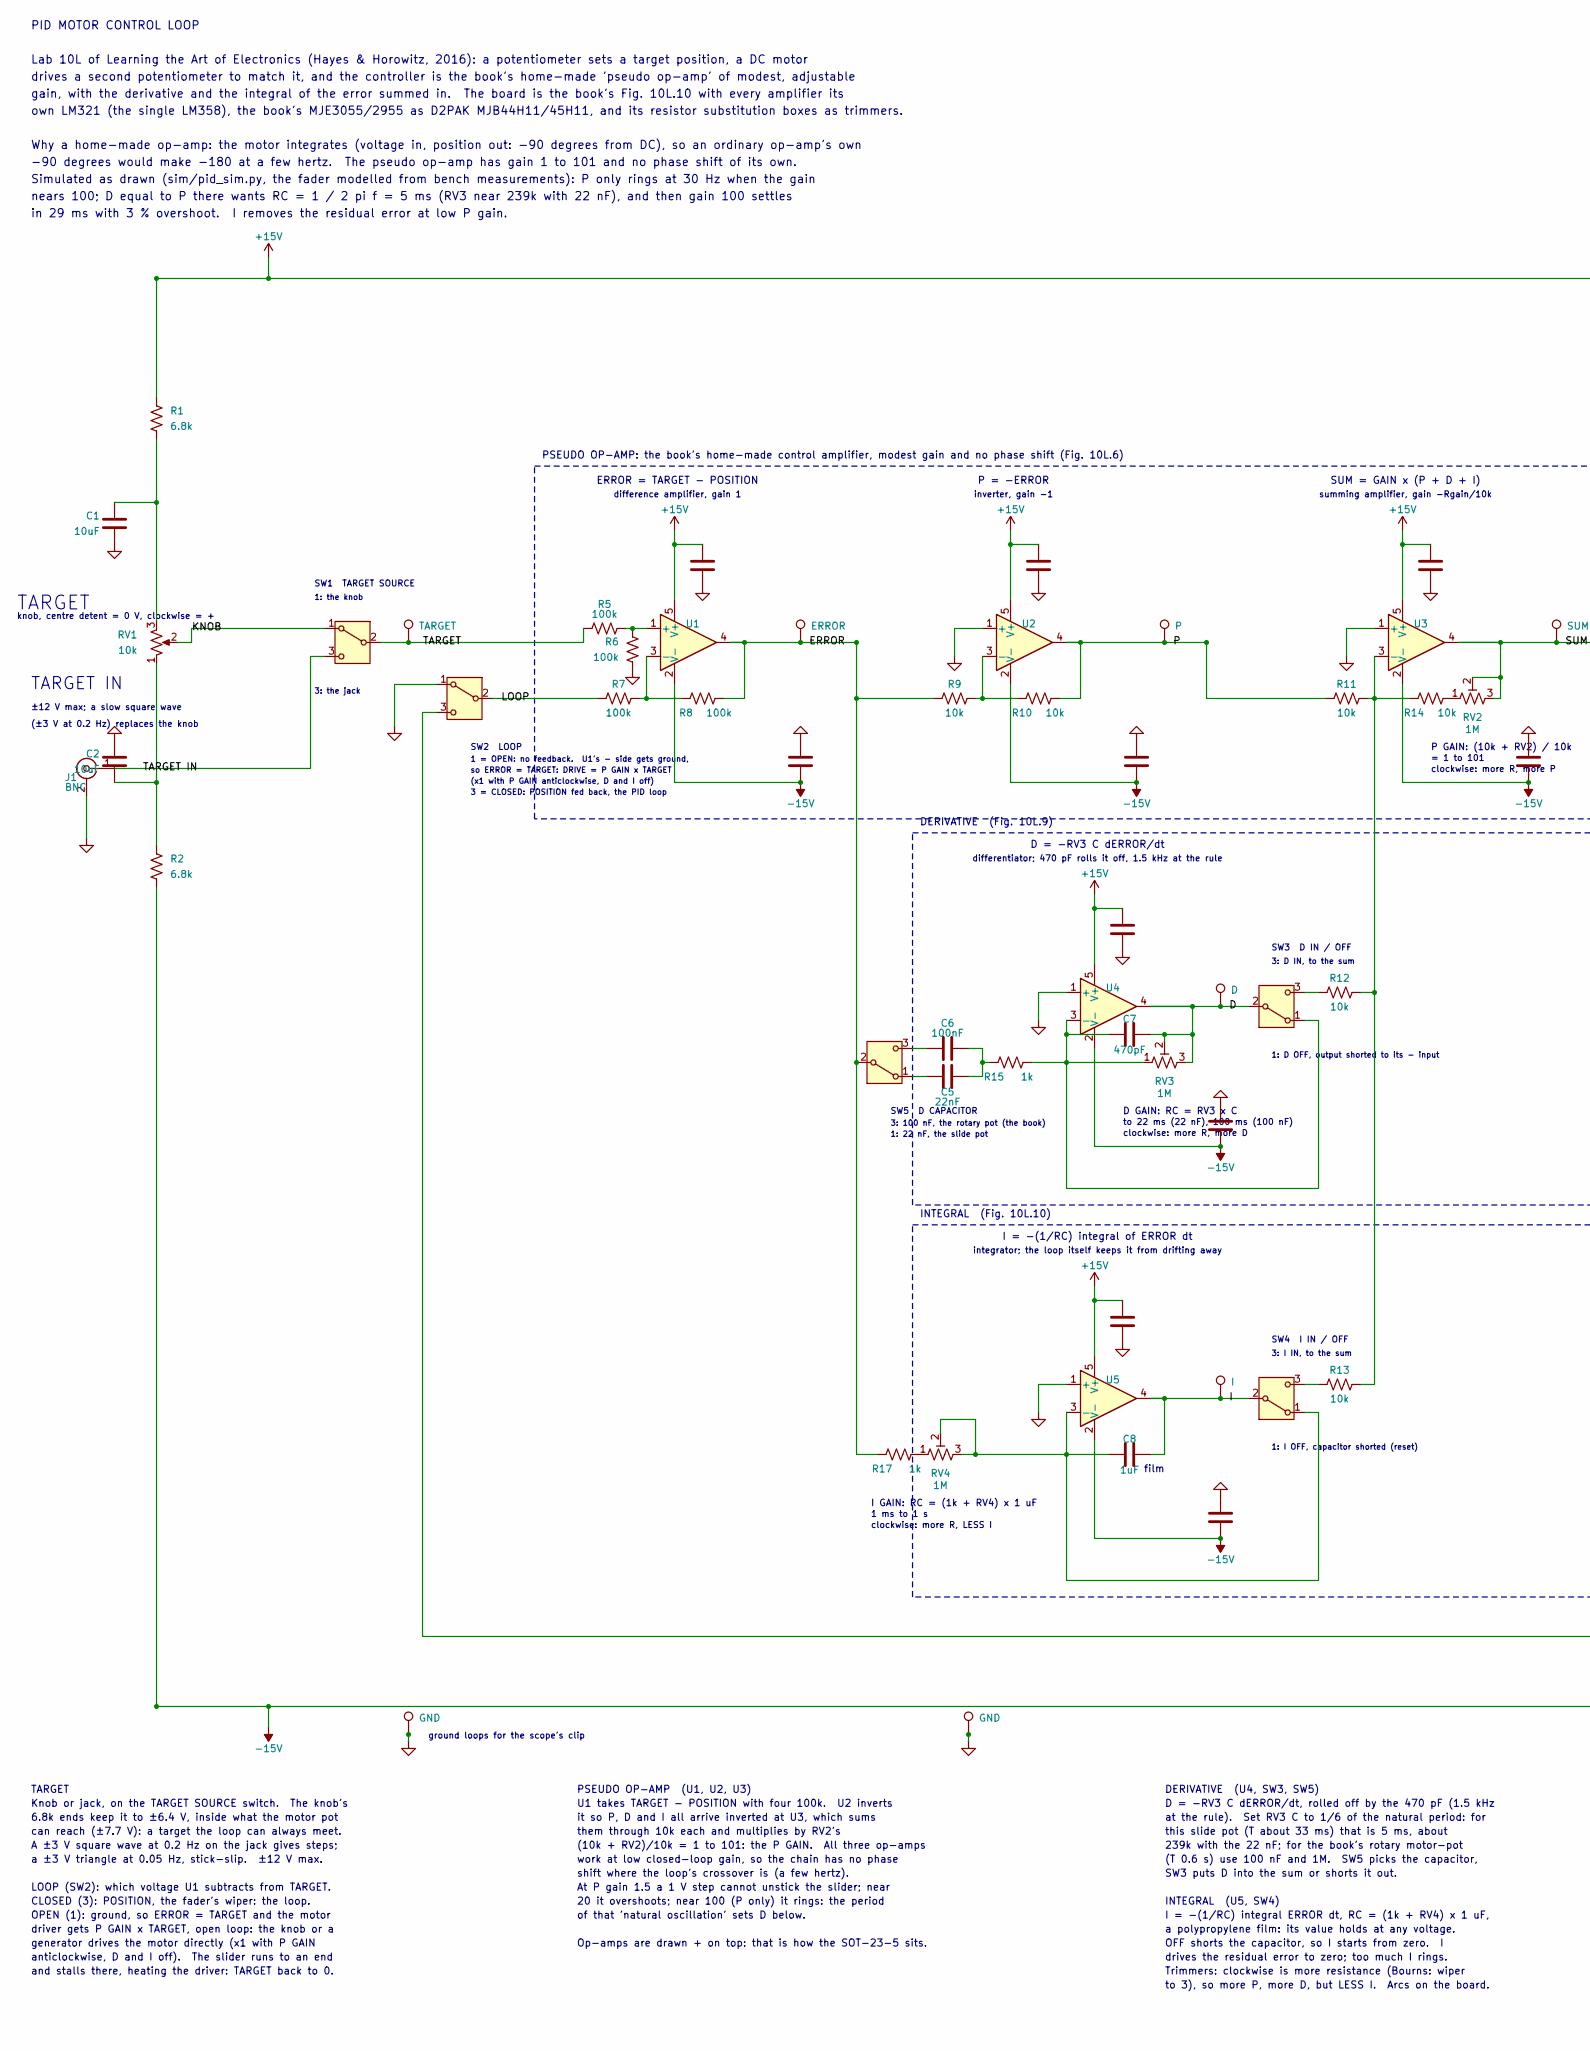
[picture p53: schematic motorpid.kicad_sch, PID Motor Control Loop: Lab 10L of Learning the Art of Elec…, part in row 1, column 1]

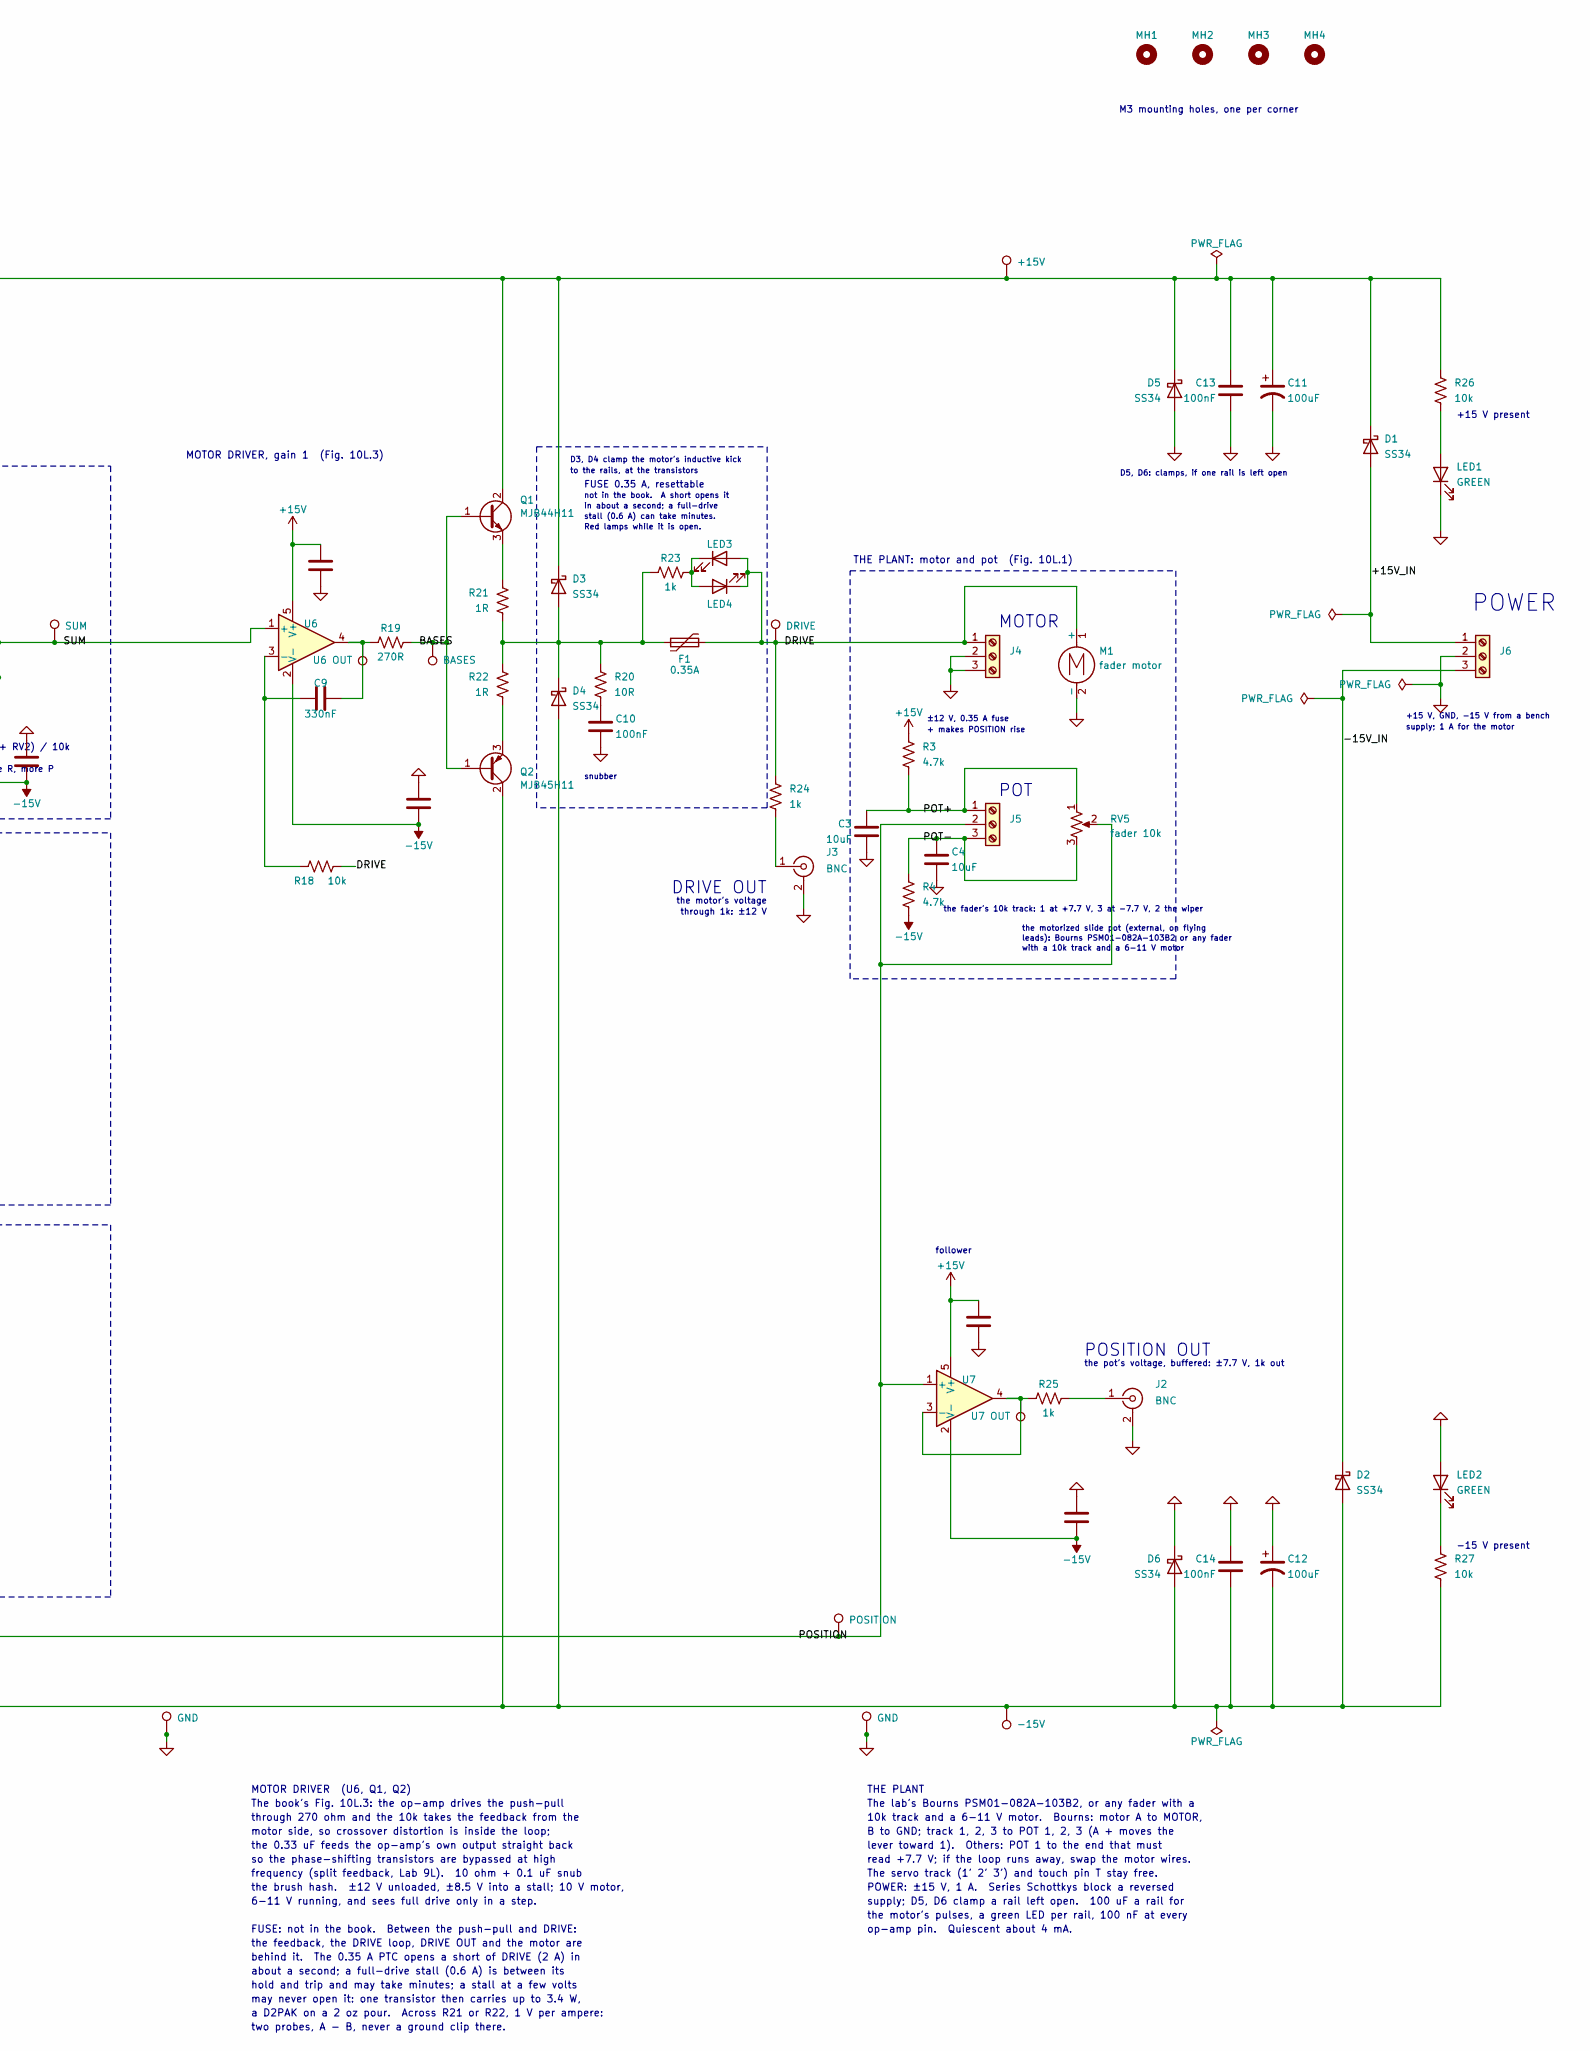
[picture p54: schematic motorpid.kicad_sch, PID Motor Control Loop: Lab 10L of Learning the Art of Elec…, part in row 1, column 2]

Parts:
C1, C2, C3, C4: 10uF; C_0805_2012Metric; MPN CL21A106KAYNNNE; LCSC C15850
C5: 22nF; C_0805_2012Metric; MPN CL21B223KBANNNC; LCSC C1729
C6, C10, C13, C14, C20, C21, C22, C23, C24, C25, C26, C27, C28, C29, C30, C31, C32, C33: 100nF; C_0805_2012Metric; MPN CC0805KRX7R9BB104; LCSC C49678
C7: 470pF; C_0805_2012Metric; MPN 0805B471K500NT; LCSC C1743
C8: 1uF; C_Film_Panasonic_ECWF_L18.1mm_W9.3mm_P15.00mm; MPN ECWF2W105JA; LCSC C242107
C9: 330nF; C_0805_2012Metric; MPN 0805B334K500NT; LCSC C1740
C11, C12: 100uF; CP_Elec_6.3x5.4; MPN JVJ25V100M6x5; LCSC C46550402
D1, D2, D3, D4, D5, D6: SS34; D_SMA; MPN SS34; LCSC C8678
F1: 0.35A; Fuse_1812_4532Metric; MPN 1812L035/60GR; LCSC C18198330
J1, J2, J3: BNC; BNC_KYWE_RightAngle; MPN BNC-KYWE-295-W4-N; LCSC C41416668
J4: MOTOR + - shield; TerminalBlock_KF301_1x03_P5.00mm; MPN KF301-5.0-3P; LCSC C474882
J5: POT 1 (+) 2 (wiper) 3 (-); TerminalBlock_KF301_1x03_P5.00mm; MPN KF301-5.0-3P; LCSC C474882
J6: +15 / GND / -15; TerminalBlock_KF301_1x03_P5.00mm; MPN KF301-5.0-3P; LCSC C474882
LED1, LED2: GREEN; LED_0805_2012Metric; MPN KT-0805G; LCSC C2297
LED3, LED4: RED; LED_0805_2012Metric; MPN NCD0805R1; LCSC C84256
M1: fader motor
MH1, MH2, MH3, MH4: MountingHole; MountingHole_3.2mm_M3
Q1: MJB44H11; TO-263-2; MPN MJB44H11T4G; LCSC C233689
Q2: MJB45H11; TO-263-2; MPN MJB45H11T4G; LCSC C154570
R1, R2: 6.8k; R_0805_2012Metric; MPN 0805W8F6801T5E; LCSC C17772
R3, R4: 4.7k; R_0805_2012Metric; MPN 0805W8F4701T5E; LCSC C17673
R5, R6, R7, R8: 100k; R_0805_2012Metric; MPN 0805W8F1003T5E; LCSC C149504
R9, R10, R11, R12, R13, R14, R18, R26, R27: 10k; R_0805_2012Metric; MPN 0805W8F1002T5E; LCSC C17414
R15, R17, R23: 1k; R_0805_2012Metric; MPN 0805W8F1001T5E; LCSC C17513
R19: 270R; R_0805_2012Metric; MPN 0805W8F2700T5E; LCSC C17590
R20: 10R; R_0805_2012Metric; MPN 0805W8F100JT5E; LCSC C17415
R21, R22: 1R; R_2512_6332Metric; MPN FRC2512J1R0TS; LCSC C3000711
R24, R25: 1k; R_1206_3216Metric; MPN 1206W4F1001T5E; LCSC C4410
RV1: 10k; Potentiometer_Alps_RK09K_Single_Vertical; MPN RK09K1130A70; LCSC C351173
RV2, RV3, RV4: 1M; Potentiometer_Bourns_3362P_Vertical; MPN 3362P-1-105; LCSC C118945
RV5: fader 10k
SW1: TARGET SOURCE; SW_SPDT_Shouhan_MSK12C02; MPN MSK12C02; LCSC C431540
SW2: LOOP; SW_SPDT_Shouhan_MSK12C02; MPN MSK12C02; LCSC C431540
SW3: D IN / OFF; SW_SPDT_Shouhan_MSK12C02; MPN MSK12C02; LCSC C431540
SW4: I IN / OFF; SW_SPDT_Shouhan_MSK12C02; MPN MSK12C02; LCSC C431540
SW5: D CAPACITOR; SW_SPDT_Shouhan_MSK12C02; MPN MSK12C02; LCSC C431540
TP1: TARGET; TestPoint_Loop_RH-5019; MPN RH-5019; LCSC C5199800
TP2: ERROR; TestPoint_Loop_RH-5019; MPN RH-5019; LCSC C5199800
TP3: P; TestPoint_Loop_RH-5019; MPN RH-5019; LCSC C5199800
TP4: D; TestPoint_Loop_RH-5019; MPN RH-5019; LCSC C5199800
TP5: I; TestPoint_Loop_RH-5019; MPN RH-5019; LCSC C5199800
TP6: SUM; TestPoint_Loop_RH-5019; MPN RH-5019; LCSC C5199800
TP7: DRIVE; TestPoint_Loop_RH-5019; MPN RH-5019; LCSC C5199800
TP8: POSITION; TestPoint_Loop_RH-5019; MPN RH-5019; LCSC C5199800
TP9: +15V; TestPoint_Loop_RH-5019; MPN RH-5019; LCSC C5199800
TP10: -15V; TestPoint_Loop_RH-5019; MPN RH-5019; LCSC C5199800
TP11: BASES; TestPoint_Loop_RH-5019; MPN RH-5019; LCSC C5199800
TP12: U6 OUT; TestPoint_Loop_RH-5019; MPN RH-5019; LCSC C5199800
TP13: U7 OUT; TestPoint_Loop_RH-5019; MPN RH-5019; LCSC C5199800
TP100, TP101, TP102, TP103: GND; TestPoint_Loop_RH-5019; MPN RH-5019; LCSC C5199800
U1, U2, U3, U4, U5, U6, U7: LM321; SOT-23-5; MPN LM321MFX/NOPB; LCSC C9405

Connections:
+15V: C11.1, C13.1, C20.1, C22.1, C24.1, C26.1, C28.1, C30.1, C32.1, D1.1 (K), D3.1 (K), D5.1 (K), Q1.2 (C), R1.1, R3.1, R26.1, TP9.1, U1.5 (V+), U2.5 (V+), U3.5 (V+), U4.5 (V+), U5.5 (V+), U6.5 (V+), U7.5 (V+)
-15V: C12.2, C14.2, C21.2, C23.2, C25.2, C27.2, C29.2, C31.2, C33.2, D2.2 (A), D4.2 (A), D6.2 (A), Q2.2 (C), R2.2, R4.2, R27.2, TP10.1, U1.2 (V-), U2.2 (V-), U3.2 (V-), U4.2 (V-), U5.2 (V-), U6.2 (V-), U7.2 (V-)
/+15V_IN: D1.2 (A), J6.1
/-15V_IN: D2.1 (K), J6.3
/BASES: Q1.1 (B), Q2.1 (B), R19.2, TP11.1
/D: C7.2, RV3.2, RV3.3, SW3.2 (B), TP4.1, U4.4
/DRIVE: F1.2, J4.1, LED3.2 (A), LED4.1 (K), M1.1 (+), R18.2, R24.1, TP7.1
/ERROR: R8.2, R9.1, R17.1, SW5.2 (B), TP2.1, U1.4
/I: C8.2, SW4.2 (B), TP5.1, U5.4
/KNOB: RV1.2, SW1.1 (A)
/LOOP: R7.1, SW2.2 (B)
/P: R10.2, R11.1, TP3.1, U2.4
/POSITION: J5.2, RV5.2, SW2.3 (C), TP8.1, U7.1 (+)
/POT+: C3.1, J5.1, R3.2, RV5.1
/POT-: C4.1, J5.3, R4.1, RV5.3
/SUM: RV2.2, RV2.3, TP6.1, U3.4, U6.1 (+)
/TARGET: R5.1, SW1.2 (B), TP1.1
/TARGET IN: J1.1 (In), SW1.3 (C)
GND: C1.2, C2.1, C3.2, C4.2, C10.2, C11.2, C12.1, C13.2, C14.1, C20.2, C21.1, C22.2, C23.1, C24.2, C25.1, C26.2, C27.1, C28.2, C29.1, C30.2, C31.1, C32.2, C33.1, D5.2 (A), D6.1 (K), J1.2 (Ext), J2.2 (Ext), J3.2 (Ext), J4.2, J4.3, J6.2, LED1.1 (K), LED2.2 (A), M1.2 (-), R6.2, SW2.1 (A), TP100.1, TP101.1, TP102.1, TP103.1, U2.1 (+), U3.1 (+), U4.1 (+), U5.1 (+)
unnamed: C1.1, R1.2, RV1.3
unnamed: C2.2, R2.1, RV1.1
unnamed: C5.2, C6.2, R15.1
unnamed: C9.2, R19.1, TP12.1, U6.4
unnamed: C10.1, R20.2
unnamed: D3.2 (A), D4.1 (K), F1.1, R20.1, R21.2, R22.1, R23.1
unnamed: J2.1 (In), R25.2
unnamed: J3.1 (In), R24.2
unnamed: LED1.2 (A), R26.2
unnamed: LED2.1 (K), R27.1
unnamed: LED3.1 (K), LED4.2 (A), R23.2
unnamed: Q1.3 (E), R21.1
unnamed: Q2.3 (E), R22.2
unnamed: R14.2, RV2.1
unnamed: R17.2, RV4.1
unnamed: C7.1, R15.2, RV3.1, SW3.1 (A), U4.3 (-)
unnamed: R12.1, SW3.3 (C)
unnamed: C8.1, RV4.2, RV4.3, SW4.1 (A), U5.3 (-)
unnamed: R13.1, SW4.3 (C)
unnamed: C5.1, SW5.1 (A)
unnamed: C6.1, SW5.3 (C)
unnamed: R5.2, R6.1, U1.1 (+)
unnamed: R7.2, R8.1, U1.3 (-)
unnamed: R9.2, R10.1, U2.3 (-)
unnamed: R11.2, R12.2, R13.2, R14.1, U3.3 (-)
unnamed: C9.1, R18.1, U6.3 (-)
unnamed: R25.1, TP13.1, U7.3 (-), U7.4

Notes on the sheet:
POWER: ±15 V, 1 A. Series Schottkys block a reversed
the motor's pulses, a green LED per rail, 100 nF at every
6.8k ends keep it to ±6.4 V, inside what the motor pot
film
this slide pot (T about 33 ms) that is 5 ms, about
anticlockwise, D and I off). The slider runs to an end
it so P, D and I all arrive inverted at U3, which sums
B to GND; track 1, 2, 3 to POT 1, 2, 3 (A + moves the
motor side, so crossover distortion is inside the loop;
the feedback, the DRIVE loop, DRIVE OUT and the motor are
ground loops for the scope's clip
1: 22 nF, the slide pot
drives the residual error to zero; too much I rings.
PSEUDO OP-AMP (U1, U2, U3)
SW2 LOOP
10k track and a 6-11 V motor. Bourns: motor A to MOTOR,
with a 10k track and a 6-11 V motor
The servo track (1' 2' 3') and touch pin T stay free.
= 1 to 101
I GAIN: RC = (1k + RV4) x 1 uF
PSEUDO OP-AMP: the book's home-made control amplifier, modest gain and no phase shift (Fig. 10L.6)
THE PLANT
239k with the 22 nF; for the book's rotary motor-pot
difference amplifier, gain 1
two probes, A - B, never a ground clip there.
in 29 ms with 3 % overshoot. I removes the residual error at low P gain.
+15 V present
SW5 D CAPACITOR
D5, D6: clamps, if one rail is left open
FUSE 0.35 A, resettable
3: D IN, to the sum
snubber
POSITION OUT
driver gets P GAIN x TARGET, open loop: the knob or a
Trimmers: clockwise is more resistance (Bourns: wiper
M3 mounting holes, one per corner
DERIVATIVE (Fig. 10L.9)
inverter, gain -1
them through 10k each and multiplies by RV2's
OFF shorts the capacitor, so I starts from zero. I
MOTOR DRIVER, gain 1 (Fig. 10L.3)
(x1 with P GAIN anticlockwise, D and I off)
(10k + RV2)/10k = 1 to 101: the P GAIN. All three op-amps
6-11 V running, and sees full drive only in a step.
3 = CLOSED: POSITION fed back, the PID loop
SUM = GAIN x (P + D + I)
A ±3 V square wave at 0.2 Hz on the jack gives steps;
the brush hash. ±12 V unloaded, ±8.5 V into a stall; 10 V motor,
INTEGRAL (U5, SW4)
1: I OFF, capacitor shorted (reset)
may never open it: one transistor then carries up to 3.4 W,
3: 100 nF, the rotary pot (the book)
gain, with the derivative and the integral of the error summed in. The board is the book's Fig. 10L.10 with every amplifier its
of that 'natural oscillation' sets D below.
DRIVE OUT
a D2PAK on a 2 oz pour. Across R21 or R22, 1 V per ampere:
P = -ERROR
(±3 V at 0.2 Hz) replaces the knob
FUSE: not in the book. Between the push-pull and DRIVE:
to 22 ms (22 nF), 100 ms (100 nF)
U1 takes TARGET - POSITION with four 100k. U2 inverts
the 0.33 uF feeds the op-amp's own output straight back
supply; 1 A for the motor
hold and trip and may take minutes; a stall at a few volts
clockwise: more R, more P
the motorized slide pot (external, on flying
SW4 I IN / OFF
D = -RV3 C dERROR/dt
SW3 D IN / OFF
TARGET
Simulated as drawn (sim/pid_sim.py, the fader modelled from bench measurements): P only rings at 30 Hz when the gain
3: I IN, to the sum
PID MOTOR CONTROL LOOP
Lab 10L of Learning the Art of Electronics (Hayes & Horowitz, 2016): a potentiometer sets a target position, a DC motor
about a second; a full-drive stall (0.6 A) is between its
work at low closed-loop gain, so the chain has no phase
the pot's voltage, buffered: ±7.7 V, 1k out
1: D OFF, output shorted to its - input
The book's Fig. 10L.3: the op-amp drives the push-pull
Knob or jack, on the TARGET SOURCE switch. The knob's
not in the book. A short opens it
through 1k: ±12 V
THE PLANT: motor and pot (Fig. 10L.1)
SW1 TARGET SOURCE
(T 0.6 s) use 100 nF and 1M. SW5 picks the capacitor,
drives a second potentiometer to match it, and the controller is the book's home-made 'pseudo op-amp' of modest, adjustable
TARGET IN
D = -RV3 C dERROR/dt, rolled off by the 470 pF (1.5 kHz
summing amplifier, gain -Rgain/10k
at the rule). Set RV3 C to 1/6 of the natural period: for
Red lamps while it is open.
I = -(1/RC) integral ERROR dt, RC = (1k + RV4) x 1 uF,
±12 V, 0.35 A fuse
ERROR = TARGET - POSITION
own LM321 (the single LM358), the book's MJE3055/2955 as D2PAK MJB44H11/45H11, and its resistor substitution boxes as trimmers.
through 270 ohm and the 10k takes the feedback from the
20 it overshoots; near 100 (P only) it rings: the period
D3, D4 clamp the motor's inductive kick
The lab's Bourns PSM01-082A-103B2, or any fader with a
in about a second; a full-drive
Why a home-made op-amp: the motor integrates (voltage in, position out: -90 degrees from DC), so an ordinary op-amp's own
MOTOR DRIVER (U6, Q1, Q2)
At P gain 1.5 a 1 V step cannot unstick the slider; near
and stalls there, heating the driver: TARGET back to 0.
nears 100; D equal to P there wants RC = 1 / 2 pi f = 5 ms (RV3 near 239k with 22 nF), and then gain 100 settles
follower
lever toward 1). Others: POT 1 to the end that must
stall (0.6 A) can take minutes.
+ makes POSITION rise
a ±3 V triangle at 0.05 Hz, stick-slip. ±12 V max.
to the rails, at the transistors
±12 V max; a slow square wave
so ERROR = TARGET: DRIVE = P GAIN x TARGET
CLOSED (3): POSITION, the fader's wiper: the loop.
DERIVATIVE (U4, SW3, SW5)
generator drives the motor directly (x1 with P GAIN
clockwise: more R, more D
POWER
1: the knob
-15 V present
shift where the loop's crossover is (a few hertz).
D GAIN: RC = RV3 x C
supply; D5, D6 clamp a rail left open. 100 uF a rail for
1 ms to 1 s
a polypropylene film: its value holds at any voltage.
leads): Bourns PSM01-082A-103B2 or any fader
to 3), so more P, more D, but LESS I. Arcs on the board.
OPEN (1): ground, so ERROR = TARGET and the motor
the motor's voltage
-90 degrees would make -180 at a few hertz. The pseudo op-amp has gain 1 to 101 and no phase shift of its own.
differentiator; 470 pF rolls it off, 1.5 kHz at the rule
op-amp pin. Quiescent about 4 mA.
POT
SW3 puts D into the sum or shorts it out.
clockwise: more R, LESS I
behind it. The 0.35 A PTC opens a short of DRIVE (2 A) in
Op-amps are drawn + on top: that is how the SOT-23-5 sits.
3: the jack
I = -(1/RC) integral of ERROR dt
MOTOR
1 = OPEN: no feedback. U1's - side gets ground,
the fader's 10k track: 1 at +7.7 V, 3 at -7.7 V, 2 the wiper
read +7.7 V; if the loop runs away, swap the motor wires.
INTEGRAL (Fig. 10L.10)
P GAIN: (10k + RV2) / 10k
frequency (split feedback, Lab 9L). 10 ohm + 0.1 uF snub
LOOP (SW2): which voltage U1 subtracts from TARGET.
knob, centre detent = 0 V, clockwise = +
integrator; the loop itself keeps it from drifting away
+15 V, GND, -15 V from a bench
can reach (±7.7 V): a target the loop can always meet.
so the phase-shifting transistors are bypassed at high

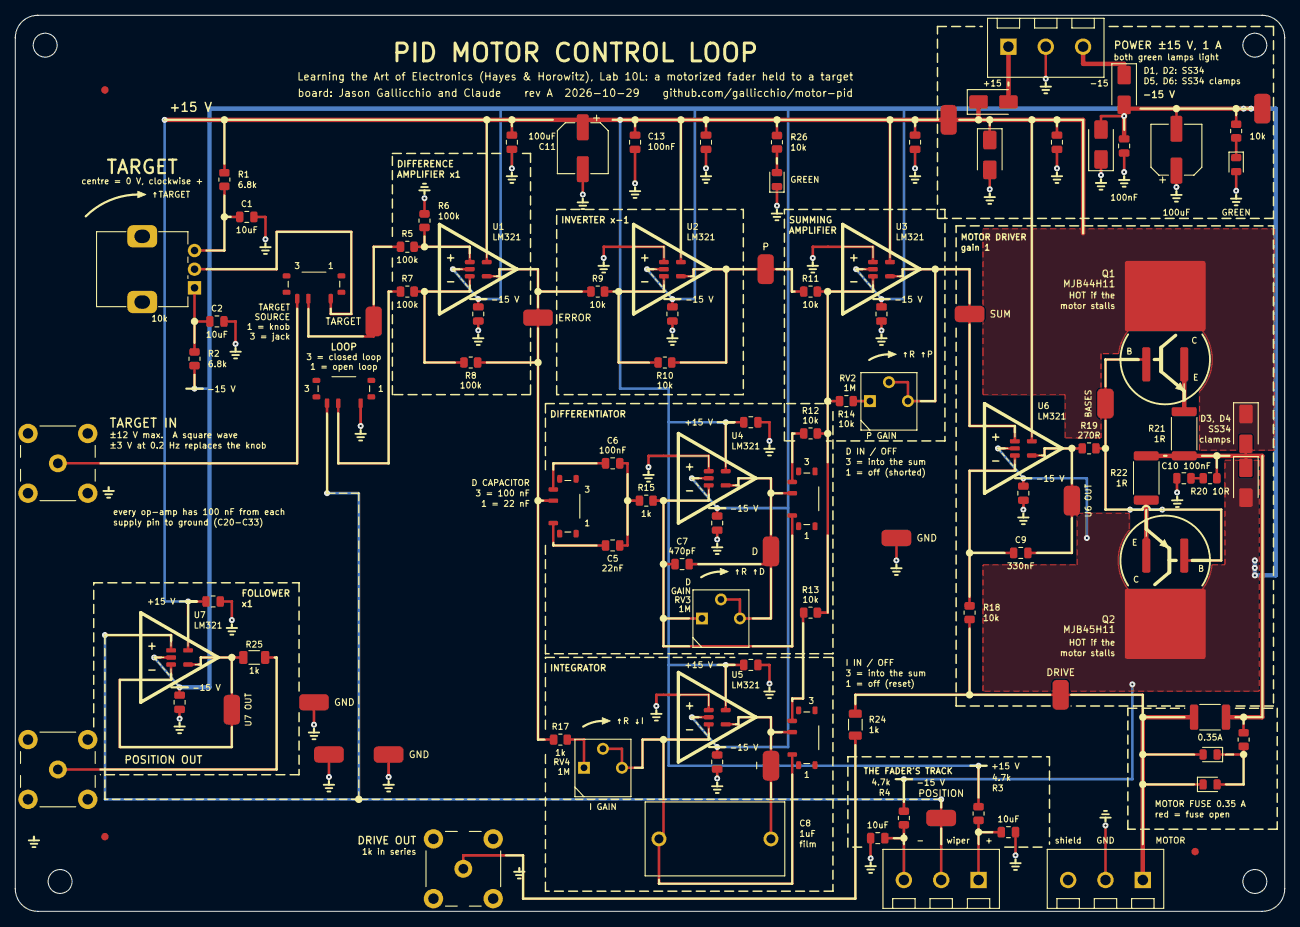
[picture p55: board motorpid.kicad_pcb from above]

Board: 2 copper layers, 170.0 x 120.0 mm, 110 parts (0 on the bottom side), 46 nets.
