gallicchio/motor-pid/sim/pid_sim.py

#!/usr/bin/env python3
"""Simulate the PID loop AS DRAWN: the SPICE deck is built from the netlist
KiCad exported (out/motorpid.net), so a wire drawn to the wrong pin shows up
here as a loop that runs away, not as a surprise on the bench.

Each part of the netlist becomes a SPICE element: resistors and capacitors
as they are, the diodes and transistors with their models, every LM321 as a
behavioural macro (1 MHz, 0.4 V/us, output within 2 V of either rail), the slide
switches as the positions a scenario sets, the trimmers as the resistance a
scenario sets, the fuse as its cold resistance, and the three terminals as
the world outside the board: a bench supply on J6, the fader's motor on J4
and its track on J5 (a behavioural model of the lab's Bourns PSM01-082A-103B2:
14 ohm, back EMF, an effective inertia, sticking friction and end stops, from
Jason's bench measurements of 2026-10-26 and the Bourns data sheet).

    python3 sim/pid_sim.py           prints the results and writes sim/results.json
    python3 sim/pid_sim.py --plots   also draws docs/images/sim-*.png

Needs libngspice (ctypes); matplotlib only for the plots.
"""
import json, math, os, re, sys
sys.path.insert(0, os.path.dirname(os.path.abspath(__file__)))
sys.path.insert(0, os.path.join(os.path.dirname(os.path.abspath(__file__)), "..", "scripts"))
from ngspice_lib import NgSpice
from sexp_parse import parse_file

ROOT = os.path.abspath(os.path.join(os.path.dirname(os.path.abspath(__file__)), ".."))
NETLIST = os.path.join(ROOT, "out", "motorpid.net")
RESULTS = os.path.join(ROOT, "sim", "results.json")
IMAGES = os.path.join(ROOT, "docs", "images")

# ---------------------------------------------------------------- the plant --
# Bourns PSM01-082A-103B2, the lab's fader (PSP01-082A-103B2 is the same motor
# and tracks in a metal-framed body): 100 mm of travel; the 10k line track
# (terminals 1-2-3) has taper B2, linear over the middle 80 mm and flat for
# about 10 mm at each end; a 10 V motor (6-11 V, 800 mA max starting).
# Measured by Jason, 2026-10-26: 18 ohm on an ohmmeter, 0.36 A stalled at 5 V
# (14 ohm working: the ohmmeter's few mA read the brushes high); 2-3 V to
# break the slider loose and keep it going; 0.16 A running at 3 V; end to end
# in under a second at 5 V (taken as 0.8 s).
# On the board the track sits between +7.73 V and -7.73 V (4.7 k to each rail),
# so position is in "pot volts": 0.193 V per mm along the linear 80 mm, with
# the end stops 10 mm (1.93 V) past the ends of the linear part.
V_END = 30.0 * 10e3 / (4.7e3 + 10e3 + 4.7e3) / 2        # 7.73 V at the track's ends
MM_LINEAR = 80.0                                        # taper B2: 10 % to 90 % of the travel
V_PER_MM = 2 * V_END / MM_LINEAR                        # 0.193 V/mm
V_STOP = V_END + 10.0 * V_PER_MM                        # the end stops, in pot volts: 9.66
R_MOTOR = 14.0                                          # ohm: 5 V / 0.36 A stalled
L_MOTOR = 1e-3
I_COULOMB = 0.15                                        # A of friction while sliding (0.16 A at 3 V)
I_BREAK = 0.18                                          # A to break it loose: 2-3 V / 14 ohm
I_VISC_5V = 0.02                                        # A of viscous drag at the 5 V speed (a guess)
SPEED_5V = 100.0 / 0.8 * V_PER_MM                        # pot volts/s at 5 V: 100 mm in 0.8 s
KE = (5.0 - (I_COULOMB + I_VISC_5V) * R_MOTOR) / SPEED_5V   # V per (pot volt / s): 0.11
KT = KE                                                 # the same constant the other way (effective)
TAU_M = 0.015                                           # s: mechanical time constant (reflected inertia)
MASS = TAU_M * KE * KT / R_MOTOR                         # effective mass in these units
F_COULOMB = KT * I_COULOMB
F_BREAK = KT * I_BREAK
V_STRIBECK = 1.0                                        # pot volts/s (5 mm/s): below it, friction rises to F_BREAK
                                                        # (a guess, set so a slow triangle sticks and slips as on the bench)
V_STICK = 0.002                                         # pot volts/s (10 um/s): slower than this counts as stuck
B_VISC = KT * I_VISC_5V / SPEED_5V
MODELS = [
    ".model Q3904 NPN(IS=1E-14 VAF=100 Bf=300 IKF=0.4 XTB=1.5 BR=4 CJC=4E-12 CJE=8E-12 RB=20 RC=0.1 RE=0.1 TR=250E-9 TF=350E-12 ITF=1 VTF=2 XTF=3)",
    ".model Q3906 PNP(IS=1E-14 VAF=100 Bf=200 IKF=0.4 XTB=1.5 BR=4 CJC=4.5E-12 CJE=10E-12 RB=20 RC=0.1 RE=0.1 TR=250E-9 TF=350E-12 ITF=1 VTF=2 XTF=3)",
    ".model QD44 NPN(IS=5E-13 VAF=120 Bf=100 IKF=6 XTB=1.5 BR=5 CJC=1.2E-10 CJE=3E-10 RB=1 RC=0.05 RE=0.03 TF=5E-9 TR=5E-8)",
    ".model QD45 PNP(IS=5E-13 VAF=120 Bf=100 IKF=6 XTB=1.5 BR=5 CJC=1.2E-10 CJE=3E-10 RB=1 RC=0.05 RE=0.03 TF=6E-9 TR=5E-8)",
    ".model D4148 D(IS=2.52e-9 RS=0.568 N=1.752 CJO=4e-12 M=0.4 TT=20e-9 BV=75)",
    ".model DSS34 D(IS=2e-6 RS=0.04 N=1.1 CJO=250e-12 M=0.4 BV=40)",
    ".model DLEDR D(IS=1e-20 N=1.8 RS=1.5 CJO=30e-12)",
    ".model DLEDG D(IS=1e-23 N=2.2 RS=2 CJO=30e-12)",
    # the LM321: gm into a dominant pole, slew-limited, output within 2 V of either rail
    # (TI: V+ - 2 V typical, V+ - 3 V guaranteed, at 10k; and it sinks 10 mA only 2 V
    # above V-, microamps at 0.2 V: the push-pull's base current keeps it off the rail)
    ".subckt LM321 inp inn out vp vn",
    "Rin inp inn 1e9",
    "Bg 0 x I = { min(max(1e-3*(V(inp)-V(inn)), -64u), 64u) - 1e-3*(V(x) - min(max(V(x), V(vn)-1), V(vp)+1)) }",
    "Rx x 0 1e7",
    "Cx x 0 159p",
    "Bo o 0 V = { min(max(V(x), V(vn)+2.0), V(vp)-2.0) }",
    "Ro o out 100",
    ".ends",
]


def spice_name(net):
    if net in ("GND", "/GND"):
        return "0"
    n = net.lstrip("/").replace("+", "P").replace("-", "M")
    n = re.sub(r"[^A-Za-z0-9_]", "_", n).strip("_")
    return "n_" + n


def value_si(text):
    t = text.strip()
    m = re.match(r"([0-9.]+)\s*([a-zA-Z]*)", t)
    v, unit = float(m.group(1)), m.group(2)
    mult = {"": 1, "R": 1, "k": 1e3, "K": 1e3, "M": 1e6, "u": 1e-6, "uF": 1e-6, "n": 1e-9, "nF": 1e-9,
            "p": 1e-12, "pF": 1e-12, "F": 1}.get(unit, None)
    if mult is None:
        raise ValueError(text)
    return v * mult


class Deck:
    def __init__(self, netlist=NETLIST):
        root = parse_file(netlist)
        self.value = {}
        for c in root.first("components").kids("comp"):
            self.value[c.first("ref").atom(0)] = c.first("value").atom(0)
        self.net = {}
        for n in root.first("nets").kids("net"):
            name = n.first("name").atom(0)
            for x in n.kids("node"):
                self.net[(x.first("ref").atom(0), x.first("pin").atom(0))] = spice_name(name)

    def pin(self, ref, p):
        return self.net[(ref, str(p))]

    def lines(self, sw, trim, knob=0.0, source="pulse(0 1 0.1 1m 1m 10 20)", loop_open=False,
              motor_short=False, pot_pos=0.0, stall_at=None, ic_zero=()):
        """The deck for one scenario.  sw: {"SW1": 1 or 3, ...}; trim: {"RV2": ohms, ...}."""
        self._ic_zero = tuple(ic_zero)
        L = []
        for ref, val in sorted(self.value.items()):
            kind = re.match(r"[A-Z]+", ref).group(0)
            if kind in ("TP", "MH"):
                continue
            if kind == "R":
                L.append(f"R{ref} {self.pin(ref, 1)} {self.pin(ref, 2)} {value_si(val):g}")
            elif kind == "C":
                L.append(f"C{ref} {self.pin(ref, 1)} {self.pin(ref, 2)} {value_si(val):g}")
            elif kind == "RV":
                if ref == "RV1":                       # the knob: pin 3 is the + end, pin 1 the - end, 2 the wiper
                    f = (1.0 + knob) / 2.0             # knob = +1 puts the wiper at the + end (pin 3)
                    L.append(f"R{ref}a {self.pin(ref, 1)} {self.pin(ref, 2)} {max(1.0, 10e3 * f):g}")
                    L.append(f"R{ref}b {self.pin(ref, 2)} {self.pin(ref, 3)} {max(1.0, 10e3 * (1 - f)):g}")
                else:                                  # a rheostat: 1 to 3, the wiper tied to 3
                    L.append(f"R{ref} {self.pin(ref, 1)} {self.pin(ref, 3)} {max(1.0, trim[ref]):g}")
            elif kind == "D":
                model = {"1N4148W": "D4148", "SS34": "DSS34"}[val]
                L.append(f"D{ref} {self.pin(ref, 2)} {self.pin(ref, 1)} {model}")      # 2 = A, 1 = K
            elif kind == "LED":
                model = "DLEDR" if val == "RED" else "DLEDG"
                L.append(f"D{ref} {self.pin(ref, 2)} {self.pin(ref, 1)} {model}")
            elif kind == "Q":
                if val in ("MJB44H11", "MJB45H11"):    # D2PAK: 1 = B, 2 = C, 3 = E; the D44H11/D45H11 die
                    L.append(f"Q{ref} {self.pin(ref, 2)} {self.pin(ref, 1)} {self.pin(ref, 3)} "
                             f"{'QD44' if val == 'MJB44H11' else 'QD45'}")
                elif val in ("MMBT3904", "MMBT3906"):  # SOT-23: 1 = B, 2 = E, 3 = C
                    L.append(f"Q{ref} {self.pin(ref, 3)} {self.pin(ref, 1)} {self.pin(ref, 2)} "
                             f"{'Q3904' if val == 'MMBT3904' else 'Q3906'}")
                else:                                  # a stale netlist, or a part with no model
                    raise SystemExit(f"no model for {ref} = {val}: rebuild the schematic (make.py --stage sch) first")
            elif kind == "U":
                L.append(f"X{ref} {self.pin(ref, 1)} {self.pin(ref, 3)} {self.pin(ref, 4)} "
                         f"{self.pin(ref, 5)} {self.pin(ref, 2)} LM321")
            elif kind == "SW":
                pos = sw[ref]
                on, off = (1, 3) if pos == 1 else (3, 1)
                L.append(f"R{ref}on {self.pin(ref, 2)} {self.pin(ref, on)} 0.05")
                L.append(f"R{ref}off {self.pin(ref, 2)} {self.pin(ref, off)} 1e9")
            elif kind == "F":
                L.append(f"R{ref} {self.pin(ref, 1)} {self.pin(ref, 2)} 0.3")
            elif kind == "J":
                if ref == "J1":
                    L.append(f"Vtarget {self.pin(ref, 1)} 0 {source}")
                elif ref in ("J2", "J3"):
                    L.append(f"R{ref}scope {self.pin(ref, 1)} 0 1e6")
                elif ref == "J4":
                    L += self.motor(self.pin(ref, 1), motor_short, stall_at)
                elif ref == "J5":
                    L += self.track(self.pin(ref, 1), self.pin(ref, 2), self.pin(ref, 3), pot_pos)
                elif ref == "J6":
                    L.append(f"Vpos {self.pin(ref, 1)}_s 0 15")
                    L.append(f"Rpos {self.pin(ref, 1)}_s {self.pin(ref, 1)} 0.3")
                    L.append(f"Vneg {self.pin(ref, 3)}_s 0 -15")
                    L.append(f"Rneg {self.pin(ref, 3)}_s {self.pin(ref, 3)} 0.3")
            else:
                raise ValueError(f"no SPICE for {ref} ({val})")
        return L

    def motor(self, node, short, stall_at):
        """The fader's motor between `node` and ground, and its mechanics.

        vel is the slider's speed in pot volts per second, pos its position in
        pot volts (+/- V_END at the ends of the track's linear part, +/- V_STOP
        at the end stops).  The force is KT * I less friction; past an end stop
        a stiff spring and a heavy damper hold it; `stall_at` clamps the slider
        wherever it is (a finger on it)."""
        L = []
        if short:
            L.append(f"Rshort {node} 0 0.01")
        L.append(f"Rm {node} m1 {R_MOTOR}")
        L.append(f"Lm m1 m2 {L_MOTOR}")
        L.append(f"Bemf m2 0 V = {{ {KE} * V(vel) }}")
        stop = (f"((V(pos) > {V_STOP}) ? ( -200*(V(pos)-{V_STOP}) - 5*V(vel) ) : 0)"
                f" + ((V(pos) < {-V_STOP}) ? ( -200*(V(pos)+{V_STOP}) - 5*V(vel) ) : 0)")
        # friction: Coulomb, rising to the break-loose force below V_STRIBECK
        # (the stick-slip Jason sees on a slow triangle), and a little viscous
        fric = (f"( {F_COULOMB} + {F_BREAK - F_COULOMB}*exp(-(V(vel)/{V_STRIBECK})^2) )"
                f"*tanh(V(vel)/{V_STICK}) + {B_VISC}*V(vel)")
        hold = f" - 5*V(vel) - 200*(V(pos)-({stall_at}))" if stall_at is not None else ""
        L.append(f"Bfor 0 vel I = {{ ( {KT}*I(Bemf) - {fric} + {stop}{hold} ) / {MASS} }}")
        L.append("Cvel vel 0 1")
        L.append("Rvel vel 0 1e12")
        L.append("Bpos 0 pos I = { V(vel) }")
        L.append("Cpos pos 0 1")
        L.append("Rpos2 pos 0 1e12")
        return L

    def track(self, top, wiper, bottom, pos0):
        """The 10 k track: the wiper at pos (pot volts) between its ends; past
        +/- V_END (the B2 taper's flat 10 mm) it reads the end."""
        return [f"Rta {top} {wiper} R = {{ 10e3 * (0.5 - min(max(V(pos), {-V_END}), {V_END}) / {2 * V_END}) + 1 }}",
                f"Rtb {wiper} {bottom} R = {{ 10e3 * (0.5 + min(max(V(pos), {-V_END}), {V_END}) / {2 * V_END}) + 1 }}",
                f".ic V(pos)={pos0}"] + [f".ic V({spice_name(n)})=0" for n in self._ic_zero]


def run(deck_lines, tstop, tstep=20e-6, extra_cmds=()):
    ng = NgSpice()
    ng.circuit(["pid loop"] + MODELS + deck_lines + [".option method=gear reltol=2e-3 abstol=1e-9 vntol=1e-5",
                                                       f".tran {tstep} {tstop} 0 {tstep*5}", ".end"])
    for c in extra_cmds:
        ng.cmd(c)
    ng.cmd("run")
    errors = [l for l in ng.log if l.startswith("stderr Error") or "aborted" in l or "Timestep too small" in l]
    if errors:
        raise RuntimeError("\n".join(errors[:10]))
    return ng


def step_metrics(t, y, t0, y0, y1, band=0.05):
    """After a step at t0 from y0 to y1, as percentages of the step:
    overshoot_pct, the peak past the target; swing_pct, how far the peak goes
    past where the slider ends up (a real overshoot; with friction a step can
    stop past the target without one); final_error_pct, where it ends up
    against the target (+ past it, - short of it: the friction's dead band,
    about +/-2.5 V / P GAIN); settle_s, the time to stay within +/- band of the
    target (5 %; the end of the window if the dead band is wider); rest_s, the
    time to stay within +/- band of where it ends up; and the period of any
    ringing."""
    import numpy as np
    t, y = np.asarray(t), np.asarray(y)
    sel = t >= t0
    tt, yy = t[sel], y[sel]
    span = y1 - y0
    over = (yy.max() - y1) / span * 100 if span > 0 else (y1 - yy.min()) / abs(span) * 100
    err = np.abs(yy - y1) / abs(span)
    outside = np.where(err > band)[0]
    ts = (tt[outside[-1]] - t0) if len(outside) else 0.0
    # period from the zero crossings of the error about the final value, in the first second
    e = yy - y1
    zc = np.where(np.diff(np.sign(e)) != 0)[0]
    zc = zc[tt[zc] < t0 + 1.0]
    period = float(2 * np.mean(np.diff(tt[zc]))) if len(zc) > 3 else None
    # sustained: the last quarter of the run (at least 0.4 s) still swings by
    # more than 5 % of the step; a stick-slip hunt sticks for a while each cycle
    tail = yy[tt > tt[-1] - max(0.4, 0.25 * (tt[-1] - t0))]
    sustained = (tail.max() - tail.min()) > 0.05 * abs(span) if len(tail) else False
    y_end = float(np.mean(yy[tt > tt[-1] - 0.05]))
    if span > 0:
        swing = (yy.max() - max(y1, y_end)) / span * 100
    else:
        swing = (min(y1, y_end) - yy.min()) / abs(span) * 100
    away = np.where(np.abs(yy - y_end) / abs(span) > band)[0]
    rest = (tt[away[-1]] - t0) if len(away) else 0.0
    return dict(overshoot_pct=float(over), settle_s=float(ts), period_s=period, sustained=bool(sustained),
                swing_pct=float(max(0.0, swing)), final_error_pct=float((y_end - y1) / span * 100), rest_s=float(rest))


def ring_period(t, y, t0, y1, window=0.15):
    """The period of the ringing just after a step at t0: the crossings of the
    final value in the first `window` seconds, skipping the first half-cycle
    (slewed, not rung).  Friction stops the ringing; the slow hunt that
    follows is a different thing and is not counted."""
    import numpy as np
    t, y = np.asarray(t), np.asarray(y)
    sel = (t >= t0) & (t <= t0 + window)
    tt, e = t[sel], y[sel] - y1
    zc = tt[np.where(np.diff(np.sign(e)) != 0)[0]]
    return float(2 * np.mean(np.diff(zc[1:]))) if len(zc) > 3 else None


def main(plots=False):
    import numpy as np
    D = Deck()
    R = {"date": "2026-10-26", "plant": dict(v_end=round(V_END, 3), r_motor=R_MOTOR, ke_v_per_vps=round(KE, 4),
                                             tau_m_s=TAU_M, i_coulomb_a=I_COULOMB, i_break_a=I_BREAK)}
    base_sw = {"SW1": 3, "SW2": 3, "SW3": 1, "SW4": 1, "SW5": 1}      # D and I off (pole 1), loop closed, the jack
    base_trim = {"RV2": 0.0, "RV3": 640e3, "RV4": 1e6}          # I GAIN clockwise: RC = 1 s with C8's 1 uF
    curves = {}

    def gain_trim(g):
        return {"RV2": (g - 1) * 10e3, "RV3": base_trim["RV3"], "RV4": base_trim["RV4"]}

    # ---- quiescent point, closed loop, target 0 -----------------------------------
    ng = run(D.lines(base_sw, gain_trim(10), source="dc 0"), 0.3)
    t = ng.vec("time")
    op = {}
    for name in ("TARGET", "ERROR", "P", "SUM", "DRIVE", "POSITION", "+15V", "-15V", "D", "I", "BASES"):
        try:
            op[name] = round(ng.vec("v(" + spice_name(name) + ")")[-1], 3)
        except KeyError:
            pass
    R["op"] = op
    R["i_supply_ma"] = round(-ng.vec("i(vpos)")[-1] * 1e3, 1)
    print("quiescent:", op, f"supply {R['i_supply_ma']} mA")

    # ---- P only: steps at several gains ----------------------------------------------
    P = {}
    for g in (1.5, 5, 10, 22, 50, 100):
        ng = run(D.lines(base_sw, gain_trim(g)), 1.6)
        t = np.array(ng.vec("time")); pos = np.array(ng.vec("v(" + spice_name("POSITION") + ")"))
        drv = np.array(ng.vec("v(" + spice_name("DRIVE") + ")"))
        m = step_metrics(t, pos, 0.1, 0.0, 1.0)
        m["drive_peak_v"] = float(np.abs(drv).max())
        m["residual_v"] = float(1.0 - pos[-1])
        m["ring_period_s"] = ring_period(t, pos, 0.1, 1.0)
        im = np.array(ng.vec("i(bemf)"))
        sel = t > 0.1
        m["i_motor_rms_a"] = float(np.sqrt(np.mean(im[sel] ** 2)))
        m["i_motor_peak_a"] = float(np.abs(im).max())
        P[str(g)] = m
        curves[f"p{g}"] = (t, pos, drv)
        print(f"P only, gain {g:5.1f}: overshoot {m['overshoot_pct']:5.1f} %, settles {m['settle_s']*1e3:6.0f} ms, "
              f"period {m['period_s'] and round(m['period_s']*1e3, 1)} ms, sustained {m['sustained']}, "
              f"drive peak {m['drive_peak_v']:.1f} V, residual {m['residual_v']*1e3:.0f} mV, "
              f"motor {m['i_motor_rms_a']*1e3:.0f} mA rms / {m['i_motor_peak_a']*1e3:.0f} peak")
    R["p_only"] = P
    # the natural oscillation: the ringing period right after the step at the
    # highest gain (the slow hunt that sticking friction makes is not it)
    m = P["100"]
    f_nat, g_nat = (1.0 / m["ring_period_s"] if m["ring_period_s"] else 25.0), 100
    R["hunt_period_s"] = m["period_s"]
    rc_d = 1.0 / (2 * math.pi * f_nat)
    R["f_nat_hz"] = round(f_nat, 1)
    R["g_nat"] = g_nat
    R["rc_d_ms"] = round(rc_d * 1e3, 2)
    R["rv3_k"] = round(rc_d / 22e-9 / 1e3, 0)
    print(f"natural oscillation near {f_nat:.1f} Hz at gain {g_nat}: RC_D = {rc_d*1e3:.1f} ms, RV3 = {R['rv3_k']:.0f}k with 22 nF")

    # ---- P + D at the book's moderate gain, D set by the rule, too little and too much ---
    PD = {}
    g = 22
    for label, rv3 in (("none", None), ("rule", rc_d / 22e-9), ("third", rc_d / 22e-9 / 3), ("triple", 3 * rc_d / 22e-9)):
        sw = dict(base_sw, SW3=(1 if rv3 is None else 3))
        trim = gain_trim(g)
        if rv3 is not None:
            trim["RV3"] = min(rv3, 1e6)
        ng = run(D.lines(sw, trim), 1.6)
        t = np.array(ng.vec("time")); pos = np.array(ng.vec("v(" + spice_name("POSITION") + ")"))
        drv = np.array(ng.vec("v(" + spice_name("DRIVE") + ")"))
        m = step_metrics(t, pos, 0.1, 0.0, 1.0)
        m["rv3_k"] = None if rv3 is None else round(min(rv3, 1e6) / 1e3)
        PD[label] = m
        curves[f"pd_{label}"] = (t, pos, drv)
        print(f"P {g} + D {label:6s} (RV3 {m['rv3_k']}k): peak {m['overshoot_pct']:5.1f} % past the target, swings back "
              f"{m['swing_pct']:4.1f} %, ends {m['final_error_pct']:+5.1f} %, at rest in {m['rest_s']*1e3:4.0f} ms")
    R["pd"] = PD
    # high P gain rescued by D
    sw = dict(base_sw, SW3=3)
    trim = gain_trim(100); trim["RV3"] = min(rc_d / 22e-9, 1e6)
    ng = run(D.lines(sw, trim), 1.6)
    t = np.array(ng.vec("time")); pos = np.array(ng.vec("v(" + spice_name("POSITION") + ")"))
    m = step_metrics(t, pos, 0.1, 0.0, 1.0)
    R["pd_gain100"] = m
    curves["pd100"] = (t, pos, np.array(ng.vec("v(" + spice_name("DRIVE") + ")")))
    print(f"P 100 + D: overshoot {m['overshoot_pct']:.1f} %, settles {m['settle_s']*1e3:.0f} ms, sustained {m['sustained']}")

    # ---- I: the residual error at low gain, and its removal ------------------------------
    PI = {}
    for label, sw4, rv4 in (("P only", 1, 1e6), ("with I", 3, 1e6), ("too much I", 3, 50e3)):
        sw = dict(base_sw, SW3=3, SW4=sw4)
        trim = gain_trim(5); trim["RV3"] = min(rc_d / 22e-9, 1e6); trim["RV4"] = rv4
        ng = run(D.lines(sw, trim, source="pulse(0 1 0.1 1m 1m 10 20)", ic_zero=("I",)), 8.0)
        t = np.array(ng.vec("time")); pos = np.array(ng.vec("v(" + spice_name("POSITION") + ")"))
        m = step_metrics(t, pos, 0.1, 0.0, 1.0)
        m["residual_mv"] = float((1.0 - pos[-1]) * 1e3)
        m["rv4_k"] = rv4 / 1e3
        PI[label] = m
        curves[f"pi_{label}"] = (t, pos, np.array(ng.vec("v(" + spice_name("I") + ")")))
        print(f"P 5 {label:10s} (RV4 {rv4/1e3:.0f}k): residual {m['residual_mv']:6.0f} mV, overshoot {m['overshoot_pct']:.1f} %, sustained {m['sustained']}")
    R["pi"] = PI

    # ---- a slow triangle: the stick-slip Jason sees on the bench ------------------------
    # +/-3 V at 0.05 Hz (3 mm/s).  The slider sticks, the error grows until the
    # drive breaks it loose, it jumps, and sticks again: a sawtooth in the
    # error at P 22, a staircase at P 5 with I.
    TRI = {}
    for label, g, sw4 in (("P 22 + D", 22, 1), ("P 5 + D + I", 5, 3)):
        sw = dict(base_sw, SW3=3, SW4=sw4)
        trim = gain_trim(g); trim["RV3"] = min(rc_d / 22e-9, 1e6); trim["RV4"] = 1e6
        ng = run(D.lines(sw, trim, source="pulse(-3 3 0 10 10 1n 20)", pot_pos=-3.0, ic_zero=("I",)), 20.0, tstep=50e-6)
        t = np.array(ng.vec("time")); pos = np.array(ng.vec("v(" + spice_name("POSITION") + ")"))
        tgt = np.array(ng.vec("v(" + spice_name("TARGET") + ")"))
        sel = (t > 3.0) & (t < 9.0)                    # the rising ramp, after the start
        e = pos[sel] - tgt[sel]
        TRI[label] = dict(err_mean_mv=round(float(np.mean(e)) * 1e3), err_pp_mv=round(float(np.ptp(e)) * 1e3))
        curves[f"tri_{label}"] = (t, pos, tgt)
        print(f"triangle, {label}: {TRI[label]}")
    R["triangle"] = TRI

    # ---- the driver: a stall, and a short ------------------------------------------------
    sw = dict(base_sw, SW2=1)                             # loop open: the motor runs to the stop
    # Q1's collector-emitter voltage, from its own pins (the emitter is ahead of R21 and the fuse)
    def vce_q1(ng):
        return np.array(ng.vec("v(" + D.pin("Q1", 2) + ")")) - np.array(ng.vec("v(" + D.pin("Q1", 3) + ")"))

    ng = run(D.lines(sw, gain_trim(22), source="dc 1"), 1.0)
    i_m = np.array(ng.vec("i(bemf)")); v_m = np.array(ng.vec("v(" + spice_name("DRIVE") + ")"))
    vc = vce_q1(ng)
    R["stall"] = dict(i_motor_a=round(float(abs(i_m[-1])), 3), v_motor=round(float(v_m[-1]), 2),
                      p_q1_w=round(float(abs(i_m[-1]) * vc[-1]), 2), p_motor_w=round(float(abs(i_m[-1] * v_m[-1])), 2),
                      i_peak_a=round(float(np.abs(i_m).max()), 2))
    print("open loop, end stop:", R["stall"])
    # a stall at every drive: loop open, P GAIN at 1, so DRIVE = TARGET; the
    # slider runs to its stop and sits there.  The fuse holds 0.35 A, so the
    # low drives never trip it and the transistor carries the difference.
    sweep = []
    for vt in (2.0, 3.0, 5.0, 7.0, 9.0, 11.0):
        ng = run(D.lines(sw, gain_trim(1), source=f"dc {vt}"), 1.5)
        i_m = np.array(ng.vec("i(bemf)")); v_m = np.array(ng.vec("v(" + spice_name("DRIVE") + ")"))
        vc = vce_q1(ng)
        sweep.append(dict(target_v=vt, i_motor_a=round(float(abs(i_m[-1])), 3), v_motor=round(float(v_m[-1]), 2),
                          p_q1_w=round(float(abs(i_m[-1]) * vc[-1]), 2)))
        print(f"  stalled with DRIVE = {vt:4.1f} V: {sweep[-1]}")
    R["stall_sweep"] = sweep
    ng = run(D.lines(sw, gain_trim(22), source="dc 1", motor_short=True), 0.3)
    i_s = np.array(ng.vec("i(vpos)"))
    drv = np.array(ng.vec("v(" + spice_name("DRIVE") + ")"))
    R["short"] = dict(i_short_a=round(float(abs(i_s[-1])), 3), v_drive=round(float(drv[-1]), 2),
                      p_q1_w=round(float(abs(i_s[-1]) * vce_q1(ng)[-1]), 1))
    print("DRIVE (the motor terminal) shorted to ground:", R["short"])
    # the slew of the motor drive, large step, closed loop at gain 22 with D
    sw = dict(base_sw, SW3=3)
    trim = gain_trim(22); trim["RV3"] = min(rc_d / 22e-9, 1e6)
    ng = run(D.lines(sw, trim, source="pulse(-5 5 0.1 1m 1m 10 20)"), 1.0)
    t = np.array(ng.vec("time")); pos = np.array(ng.vec("v(" + spice_name("POSITION") + ")"))
    drv = np.array(ng.vec("v(" + spice_name("DRIVE") + ")")); i_m = np.array(ng.vec("i(bemf)"))
    m = step_metrics(t, pos, 0.1, -5.0, 5.0)
    R["big_step"] = dict(overshoot_pct=round(m["overshoot_pct"], 1), settle_s=round(m["settle_s"], 3),
                         drive_peak_v=round(float(np.abs(drv).max()), 2), i_peak_a=round(float(np.abs(i_m).max()), 2))
    curves["big"] = (t, pos, drv)
    print("10 V step with P 22 + D:", R["big_step"])

    json.dump(R, open(RESULTS, "w"), indent=1, sort_keys=True)
    print(f"wrote {os.path.relpath(RESULTS, ROOT)}")
    if plots:
        draw(curves, R)
    return R


def draw(curves, R):
    import matplotlib
    matplotlib.use("Agg")
    import matplotlib.pyplot as plt
    os.makedirs(IMAGES, exist_ok=True)
    plt.rcParams.update({"font.size": 9, "axes.grid": True, "grid.alpha": 0.3})

    fig, ax = plt.subplots(2, 1, figsize=(7, 5.2), sharex=True)
    for g, c in ((1.5, "#4C78A8"), (10, "#54A24B"), (22, "#F58518"), (50, "#B279A2"), (100, "#E45756")):
        t, pos, drv = curves[f"p{g}"]
        ax[0].plot(t, pos, color=c, lw=1.2, label=f"P gain {g:g}")
        ax[1].plot(t, drv, color=c, lw=0.8)
    ax[0].axhline(1.0, color="k", lw=0.6, ls="--")
    ax[0].set_ylabel("position (pot volts)"); ax[0].set_title("P only: a 1 V step in the target (simulated as drawn)")
    ax[0].legend(loc="lower right", fontsize=8, ncol=3)
    ax[1].set_ylabel("motor drive (V)"); ax[1].set_xlabel("time (s)"); ax[1].set_xlim(0.05, 1.0)
    fig.tight_layout(); fig.savefig(os.path.join(IMAGES, "sim-p-only.png"), dpi=130); plt.close(fig)

    fig, ax = plt.subplots(1, 1, figsize=(7, 3.4))
    for label, c, txt in (("none", "#E45756", "P 22, no D"), ("third", "#F58518", "D a third of the rule"),
                          ("rule", "#54A24B", "D by the rule: RC = 1/(2 pi f)"), ("triple", "#4C78A8", "three times the rule")):
        t, pos, drv = curves[f"pd_{label}"]
        ax.plot(t, pos, color=c, lw=1.2, label=txt)
    t, pos, drv = curves["pd100"]
    ax.plot(t, pos, color="#333333", lw=1.0, ls=":", label="P 100 + D by the rule")
    ax.axhline(1.0, color="k", lw=0.6, ls="--")
    ax.set_xlim(0.05, 0.8); ax.set_xlabel("time (s)"); ax.set_ylabel("position (pot volts)")
    ax.set_title("Adding D: the derivative lets the gain go up"); ax.legend(fontsize=8)
    fig.tight_layout(); fig.savefig(os.path.join(IMAGES, "sim-pd.png"), dpi=130); plt.close(fig)

    fig, ax = plt.subplots(2, 1, figsize=(7, 5.2), sharex=True)
    for label, c in (("P only", "#E45756"), ("with I", "#54A24B"), ("too much I", "#4C78A8")):
        t, pos, iv = curves[f"pi_{label}"]
        ax[0].plot(t, pos, color=c, lw=1.2, label=f"P 5 + D, {label}")
        ax[1].plot(t, iv, color=c, lw=0.9)
    ax[0].axhline(1.0, color="k", lw=0.6, ls="--")
    ax[0].set_ylabel("position (pot volts)"); ax[0].set_title("Adding I at low P gain: the residual error goes away")
    ax[0].legend(fontsize=8)
    ax[1].set_ylabel("integrator output I (V)"); ax[1].set_xlabel("time (s)"); ax[1].set_xlim(0.05, 8.0)
    fig.tight_layout(); fig.savefig(os.path.join(IMAGES, "sim-pid.png"), dpi=130); plt.close(fig)

    fig, ax = plt.subplots(2, 1, figsize=(7, 4.6), sharex=True)
    t, pos, drv = curves["big"]
    ax[0].plot(t, pos, color="#4C78A8", lw=1.2); ax[0].set_ylabel("position (pot volts)")
    ax[0].set_title("A 10 V step (end to end) with P 22 + D: the drive saturates, the motor slews")
    ax[1].plot(t, drv, color="#F58518", lw=1.0); ax[1].set_ylabel("motor drive (V)"); ax[1].set_xlabel("time (s)")
    ax[1].set_xlim(0.05, 1.0)
    fig.tight_layout(); fig.savefig(os.path.join(IMAGES, "sim-big-step.png"), dpi=130); plt.close(fig)
    fig, ax = plt.subplots(2, 1, figsize=(7, 5.2))
    t, pos, tgt = curves["tri_P 22 + D"]
    z = (t > 5.0) & (t < 6.0)
    ax[0].plot(t[z], tgt[z], color="k", lw=0.7, ls="--", label="TARGET")
    for label, c in (("P 22 + D", "#E45756"), ("P 5 + D + I", "#4C78A8")):
        t, pos, tgt = curves[f"tri_{label}"]
        z = (t > 5.0) & (t < 6.0)
        ax[0].plot(t[z], pos[z], color=c, lw=1.1, label=f"POSITION, {label}")
        z = t > 1.0
        ax[1].plot(t[z], (pos[z] - tgt[z]) * 1e3, color=c, lw=0.6)
    ax[0].set_ylabel("pot volts"); ax[0].legend(fontsize=8, loc="upper left")
    ax[0].set_title("A slow triangle (+/-3 V, 0.05 Hz), one second of it: the slider sticks and slips")
    ax[1].set_ylabel("POSITION - TARGET (mV)"); ax[1].set_xlabel("time (s), the whole 20 s period")
    fig.tight_layout(); fig.savefig(os.path.join(IMAGES, "sim-triangle.png"), dpi=130); plt.close(fig)
    print(f"wrote docs/images/sim-*.png")


if __name__ == "__main__":
    main(plots="--plots" in sys.argv)
