gallicchio/motor-pid/scripts/gen_pcb.py

#!/usr/bin/env python3
"""Build the PCB from scripts/layout.py: outline, placement, planned copper,
ground plane and the silkscreen that is the schematic.

Runs under KiCad's bundled Python (it needs pcbnew):
    <AppRun> python3.11 scripts/gen_pcb.py out/motorpid.net hardware/motorpid.kicad_pcb

There is no autorouter.  Every wire in layout.WIRES is a schematic wire: it is
laid as copper exactly where it is drawn, and drawn again on the silkscreen
(clipped round pads and part bodies), so the printed picture and the copper
cannot disagree.  Two segments dive under others on the back layer (HOPS);
the silkscreen draws those as hops.  Ground is the back plane.
"""
import math, os, sys
sys.path.insert(0, os.path.dirname(os.path.abspath(__file__)))
import pcbnew
from sexp_parse import parse_file
import layout as L
import parts

HERE = os.path.dirname(os.path.abspath(__file__))
HW = os.path.abspath(os.path.join(HERE, "..", "hardware"))
LOCAL_FP = os.path.join(HW, "lib", "motorpid.pretty")
SHARE_FP = None

SILK_W = 0.3            # the schematic wires on the silkscreen
SILK_CLEAR = 0.3        # silkscreen to pad
# The transistor symbol, in a frame whose origin is the SOT-23's centre, with
# the base bar on the left and the collector leg going up; mirrored per part.
Q_BAR_X, Q_BAR_H = 2.2, 1.4     # the bar: x = -Q_BAR_X, from -Q_BAR_H to +Q_BAR_H
Q_BEND = 3.6                    # the legs leave the bar's ends at 45 degrees and turn vertical here
Q_W_CIRCLE, Q_W_LEAD, Q_W_BAR, Q_W_STUB = 0.25, 0.45, 0.55, 0.16
Q_STUB_GAP = 0.3                # a hairline starts this far from its pad
VIA_DIA, VIA_DRILL = 0.8, 0.3


def mm(v):
    return pcbnew.FromMM(float(v))


def pt(x, y):
    return pcbnew.VECTOR2I(mm(x), mm(y))


def tomm(v):
    return pcbnew.ToMM(v)


def find_share():
    here = os.path.dirname(os.path.abspath(pcbnew.__file__))
    for up in range(2, 8):
        base = os.path.abspath(os.path.join(here, *([".."] * up)))
        for sub in ("share/kicad/footprints", "usr/share/kicad/footprints"):
            cand = os.path.join(base, sub)
            if os.path.isdir(cand):
                return cand
    env = os.environ.get("KICAD_SHARE_DIR")
    if env and os.path.isdir(os.path.join(env, "footprints")):
        return os.path.join(env, "footprints")
    raise SystemExit("cannot find KiCad's footprint libraries")


def load_fp(fpid):
    lib, name = fpid.split(":")
    path = LOCAL_FP if lib == "motorpid" else os.path.join(SHARE_FP, lib + ".pretty")
    fp = pcbnew.FootprintLoad(path, name)
    if fp is None:
        raise SystemExit(f"footprint {fpid} not found in {path}")
    return fp


def read_netlist(path):
    root = parse_file(path)
    comps = {}
    for c in root.first("components").kids("comp"):
        fields = {}
        fl = c.first("fields")
        if fl is not None:
            for f in fl.kids("field"):
                nm = f.first("name").atom(0)
                val = f.atom(0)
                if nm not in ("Footprint", "Datasheet", "Description") and val:
                    fields[nm] = val
        ts = c.first("tstamps")
        val = c.first("value").atom(0)
        comps[c.first("ref").atom(0)] = {
            "value": "" if val == "~" else val,
            "footprint": c.first("footprint").atom(0),
            "fields": fields, "tstamp": ts.atom(0) if ts is not None else ""}
    nets = {}
    for n in root.first("nets").kids("net"):
        name = n.first("name").atom(0)
        nets[name] = [(x.first("ref").atom(0), x.first("pin").atom(0)) for x in n.kids("node")]
    return comps, nets


# ------------------------------------------------------------- the board ---
BOARD_RULES = dict(m_MinClearance=0.21, m_HoleClearance=0.30, m_HoleToHoleMin=0.50,
                   m_CopperEdgeClearance=0.30, m_SilkClearance=0.15)


def apply_rules(board):
    ds = board.GetDesignSettings()
    for name, value in BOARD_RULES.items():
        setattr(ds, name, mm(value))


COPPER_MM = 0.070            # 2 oz outer copper: the push-pull's pours are its heatsink
STACKUP = f"""\t\t(stackup
\t\t\t(layer "F.SilkS" (type "Top Silk Screen"))
\t\t\t(layer "F.Paste" (type "Top Solder Paste"))
\t\t\t(layer "F.Mask" (type "Top Solder Mask") (thickness 0.01))
\t\t\t(layer "F.Cu" (type "copper") (thickness {COPPER_MM}))
\t\t\t(layer "dielectric 1" (type "core") (thickness {1.6 - 2 * COPPER_MM - 0.02:.2f}) (material "FR4") (epsilon_r 4.5) (loss_tangent 0.02))
\t\t\t(layer "B.Cu" (type "copper") (thickness {COPPER_MM}))
\t\t\t(layer "B.Mask" (type "Bottom Solder Mask") (thickness 0.01))
\t\t\t(layer "B.Paste" (type "Bottom Solder Paste"))
\t\t\t(layer "B.SilkS" (type "Bottom Silk Screen"))
\t\t\t(copper_finish "HAL lead-free")
\t\t\t(dielectric_constraints no)
\t\t)
"""


def write_stackup(path):
    """A 1.6 mm two-layer stackup with 2 oz copper, so the gerber job file
    agrees with the order form (the Python bindings cannot reach the board's
    stackup, so it goes into the saved file)."""
    text = open(path).read()
    if "(stackup" in text:
        return
    i = text.index("\t(setup\n") + len("\t(setup\n")
    open(path, "w").write(text[:i] + STACKUP + text[i:])


def board_outline(board):
    w, h, r = L.BOARD_W, L.BOARD_H, 3.0
    for (a, b) in (((r, 0), (w - r, 0)), ((w, r), (w, h - r)), ((w - r, h), (r, h)), ((0, h - r), (0, r))):
        s = pcbnew.PCB_SHAPE(board)
        s.SetShape(pcbnew.SHAPE_T_SEGMENT)
        s.SetStart(pt(*a)); s.SetEnd(pt(*b))
        s.SetLayer(pcbnew.Edge_Cuts); s.SetWidth(mm(0.1))
        board.Add(s)
    for (cx, cy, a0) in ((r, r, 180), (w - r, r, 270), (w - r, h - r, 0), (r, h - r, 90)):
        s = pcbnew.PCB_SHAPE(board)
        s.SetShape(pcbnew.SHAPE_T_ARC)
        s.SetCenter(pt(cx, cy))
        s.SetStart(pt(cx + r * math.cos(math.radians(a0)), cy + r * math.sin(math.radians(a0))))
        s.SetArcAngleAndEnd(pcbnew.EDA_ANGLE(90, pcbnew.DEGREES_T), True)
        s.SetLayer(pcbnew.Edge_Cuts); s.SetWidth(mm(0.1))
        board.Add(s)


class Board:
    def __init__(self, netlist_path, out_path):
        global SHARE_FP
        SHARE_FP = find_share()
        self.comps, self.nets = read_netlist(netlist_path)
        self.board = pcbnew.CreateEmptyBoard()
        self.board.SetCopperLayerCount(2)
        apply_rules(self.board)
        self.out_path = out_path
        self.netmap = {}
        for name in sorted(self.nets):
            ni = pcbnew.NETINFO_ITEM(self.board, name)
            self.board.Add(ni)
            self.netmap[name] = ni
        self.pad_net = {}
        for name, nodes in self.nets.items():
            for node in nodes:
                self.pad_net[node] = name
        self.fps = {}
        self.pads = {}            # (ref, pad) -> dict(x, y, w, h, through, net)
        self.qgeom = {}           # ref -> the symbol round each transistor (q_geometry)
        self.oageom = {}          # ref -> the triangle round each op-amp (oa_geometry)
        self.problems = []

    # ------------------------------------------------------------ parts --
    def place(self):
        for ref, info in sorted(self.comps.items()):
            if ref not in L.PLACE:
                raise SystemExit(f"{ref} has no entry in layout.PLACE")
            x, y, rot = L.PLACE[ref]
            fp = load_fp(info["footprint"])
            fp.SetFPIDAsString(info["footprint"])
            if info["tstamp"]:
                fp.SetPath(pcbnew.KIID_PATH("/" + info["tstamp"]))
            fp.SetSheetname("/")
            fp.SetSheetfile(os.path.basename(self.out_path).replace(".kicad_pcb", ".kicad_sch"))
            fp.SetReference(ref)
            fp.SetValue(info["value"])
            for fname, fval in info["fields"].items():
                fp.SetField(fname, fval)
            for f in fp.GetFields():
                if f.GetName() in ("Reference", "Value"):
                    continue
                f.SetVisible(False)
                f.SetLayer(pcbnew.F_Fab)
            if fp.HasField("Description"):
                fp.SetField("Description", "")
            self.swap_missing_models(fp, info["footprint"])
            self.board.Add(fp)
            fp.SetPosition(pt(x, y))
            if rot:
                fp.SetOrientationDegrees(rot)
            for pad in fp.Pads():
                key = (ref, pad.GetNumber())
                if key in self.pad_net:
                    pad.SetNet(self.netmap[self.pad_net[key]])
            if ref[:2] == "MH":
                fp.SetAttributes(fp.GetAttributes() | pcbnew.FP_EXCLUDE_FROM_BOM
                                 | pcbnew.FP_EXCLUDE_FROM_POS_FILES)
                fp.Value().SetVisible(False)
                fp.Reference().SetVisible(False)
            self.fps[ref] = fp
        for ref, fp in self.fps.items():
            for pad in fp.Pads():
                b = pad.GetBoundingBox()
                self.pads[(ref, pad.GetNumber())] = dict(
                    x=tomm(pad.GetPosition().x), y=tomm(pad.GetPosition().y),
                    x0=tomm(b.GetLeft()), y0=tomm(b.GetTop()), x1=tomm(b.GetRight()), y1=tomm(b.GetBottom()),
                    through=pad.GetAttribute() in (pcbnew.PAD_ATTRIB_PTH, pcbnew.PAD_ATTRIB_NPTH),
                    net=pad.GetNetname())
        self.board.GetDesignSettings().SetAuxOrigin(pt(0, L.BOARD_H))
        board_outline(self.board)

    STAND_INS = {"Potentiometer_Alps_RK09K_Single_Vertical": "Potentiometer_RK09K.wrl",
                 "Fuse_1812_4532Metric": "Fuse_1812.wrl"}

    def swap_missing_models(self, fp, fpid):
        """KiCad's AppImage ships footprints whose 3D models it does not ship;
        those get a plain stand-in body from lib/motorpid.3dshapes, scaled to
        millimetres, so the render shows a part and the model check passes."""
        name = fpid.split(":")[1]
        if name not in self.STAND_INS:
            return
        share3d = os.path.join(os.path.dirname(os.path.dirname(SHARE_FP)), "3dmodels")
        models = list(fp.Models())
        if all(os.path.exists(m.m_Filename.replace("${KICAD10_3DMODEL_DIR}", share3d)) for m in models):
            return
        fp.Models().clear()
        m = pcbnew.FP_3DMODEL()
        m.m_Filename = "${KIPRJMOD}/lib/motorpid.3dshapes/" + self.STAND_INS[name]
        m.m_Scale = pcbnew.VECTOR3D(1 / 2.54, 1 / 2.54, 1 / 2.54)
        fp.Models().push_back(m)

    # ----------------------------------------------------------- copper --
    def resolve(self, p, net):
        if isinstance(p[0], str):
            pad = self.pads.get((p[0], p[1]))
            if pad is None:
                raise SystemExit(f"wire on {net}: no pad {p[0]}.{p[1]}")
            if pad["net"] != net:
                self.problems.append(f"wire on {net} ends on {p[0]}.{p[1]}, which is on {pad['net']!r}")
            if p[0] in L.TRANSISTORS:
                # a wire reaches a transistor where the symbol's lead leaves
                # the circle; the copper inside follows the symbol (q_geometry)
                return self.q_geometry(p[0])["exit"][p[1]]
            if p[0] in L.OPAMPS:
                return self.oa_geometry(p[0])["exit"][p[1]]
            return (pad["x"], pad["y"])
        return (float(p[0]), float(p[1]))

    def track(self, a, b, width, net, layer=pcbnew.F_Cu):
        if abs(a[0] - b[0]) < 1e-6 and abs(a[1] - b[1]) < 1e-6:
            return
        t = pcbnew.PCB_TRACK(self.board)
        t.SetStart(pt(*a)); t.SetEnd(pt(*b))
        t.SetWidth(mm(width)); t.SetLayer(layer)
        t.SetNet(self.netmap[net])
        self.board.Add(t)
        self.segments.append((net, a, b, layer))

    def via(self, x, y, net):
        key = (round(x, 3), round(y, 3))
        if key in self.via_at:
            if self.via_at[key] != net:
                self.problems.append(f"two vias at {key}: {self.via_at[key]!r} and {net!r}")
            return
        self.via_at[key] = net
        v = pcbnew.PCB_VIA(self.board)
        v.SetPosition(pt(x, y))
        v.SetViaType(pcbnew.VIATYPE_THROUGH)
        v.SetDrill(mm(VIA_DRILL)); v.SetWidth(mm(VIA_DIA))
        v.SetLayerPair(pcbnew.F_Cu, pcbnew.B_Cu)
        v.SetNet(self.netmap[net])
        v.SetFrontTentingMode(pcbnew.TENTING_MODE_TENTED)
        v.SetBackTentingMode(pcbnew.TENTING_MODE_TENTED)
        self.board.Add(v)
        self.vias.append((net, x, y))

    def wires(self):
        self.segments, self.vias, self.hops, self.via_at = [], [], [], {}
        hops = {(n, a, b): True for (n, a, b) in L.HOPS}
        hops.update({(n, b, a): True for (n, a, b) in L.HOPS})
        for (net, points, width) in L.WIRES:
            if net not in self.netmap:
                raise SystemExit(f"wire names a net that is not in the netlist: {net!r}")
            pts = [self.resolve(p, net) for p in points]
            for a, b in zip(pts, pts[1:]):
                key = (net, (round(a[0], 3), round(a[1], 3)), (round(b[0], 3), round(b[1], 3)))
                if key in hops:
                    self.via(*a, net); self.via(*b, net)
                    self.track(a, b, width, net, pcbnew.B_Cu)
                    self.hops.append((net, a, b))
                else:
                    self.track(a, b, width, net)
        for ref in L.TRANSISTORS:
            g = self.q_geometry(ref)
            for num, path in g["copper"].items():
                net = self.pads[(ref, num)]["net"]
                width = 2.0 if num in g.get("wide", ()) else L.W_RAIL if num in g.get("rail", ()) else L.W_SIG
                for a, b in zip(path, path[1:]):
                    self.track(a, b, width, net)
        for ref in L.OPAMPS:
            g = self.oa_geometry(ref)
            for num, path in g["copper"].items():
                net = self.pads[(ref, num)]["net"]
                for a, b in zip(path, path[1:]):
                    self.track(a, b, L.W_SIG, net)
            # V-: pad 2 is trapped between the inputs, so it dives to the back
            # inside the triangle and surfaces under the triangle's bottom edge
            net = self.pads[(ref, "2")]["net"]
            self.via(*g["via_in"], net); self.via(*g["exit"]["2"], net)
            self.track(g["via_in"], g["exit"]["2"], L.W_SIG, net, pcbnew.B_Cu)
        # the back-only copper: -15 V from the entry to every flag
        for (net, points, width, ends) in L.BACK:
            pts = [self.resolve(p, net) for p in points]
            for a, b in zip(pts, pts[1:]):
                self.track(a, b, width, net, pcbnew.B_Cu)
            for e, p, which in ((pts[0], points[0], "start"), (pts[-1], points[-1], "end")):
                if ends not in ("both", which):
                    continue
                if isinstance(p[0], str) and self.pads[(p[0], p[1])]["through"]:
                    continue
                self.via(*e, net)
        for f in L.FLAGS:
            self.via(f[1], f[2], f[0])
        for (net, x, y) in getattr(L, "EXTRA_VIAS", ()):
            self.via(x, y, net)
        self.stub_dir = {}
        for (padref, path) in L.GND_STUBS:
            pad = self.pads[padref]
            if pad["net"] != "GND":
                self.problems.append(f"ground stub from {padref}, which is on {pad['net']!r}")
            start = self.resolve(padref, "GND") if padref[0] in L.OPAMPS else (pad["x"], pad["y"])
            pts = [start] + (list(path) if isinstance(path, list) else [path])
            for a, b in zip(pts, pts[1:]):
                self.track(a, b, L.W_SIG, "GND")
            vx, vy = pts[-1]
            self.via(vx, vy, "GND")
            dx, dy = vx - pts[-2][0], vy - pts[-2][1]
            n = math.hypot(dx, dy) or 1.0
            self.stub_dir[(round(vx, 3), round(vy, 3))] = (dx / n, dy / n)


    def pours(self):
        """Copper round each power transistor's tab, on its collector's net, as
        its heatsink: the layout's rectangles joined, less the symbol's circle
        (the leads stay in plain board, the way the symbol is drawn).  The rail
        reaches it by a wire that runs into it, or from the back by vias."""
        def rect(x0, y0, x1, y1):
            ps = pcbnew.SHAPE_POLY_SET(); ps.NewOutline()
            for (x, y) in ((x0, y0), (x1, y0), (x1, y1), (x0, y1)):
                ps.Append(mm(x), mm(y))
            return ps

        def boolean(op, a, b):
            try:
                getattr(a, op)(b)
            except TypeError:
                getattr(a, op)(b, pcbnew.SHAPE_POLY_SET.PM_FAST)

        self.pour_outline, self.pour_zone = {}, {}
        for ref, rects in L.POURS.items():
            net = self.pads[(ref, "2")]["net"]
            shape = rect(*rects[0])
            for r in rects[1:]:
                boolean("BooleanAdd", shape, rect(*r))
            g = self.q_geometry(ref)
            disc = pcbnew.SHAPE_POLY_SET(); disc.NewOutline()
            rr = g["R"] + 0.3
            for i in range(72):
                a_ = 2 * math.pi * i / 72
                disc.Append(mm(g["cx"] + rr * math.cos(a_)), mm(g["cy"] + rr * math.sin(a_)))
            boolean("BooleanSubtract", shape, disc)
            if shape.OutlineCount() != 1 or shape.HoleCount(0):
                raise SystemExit(f"{ref}'s pour is not one simple outline ({shape.OutlineCount()} outlines)")
            chain = shape.Outline(0)
            pts = [(tomm(chain.CPoint(i).x), tomm(chain.CPoint(i).y)) for i in range(chain.PointCount())]
            self.pour_outline[ref] = pts
            z = pcbnew.ZONE(self.board)
            z.SetLayer(pcbnew.F_Cu)
            z.SetNet(self.netmap[net])
            z.SetAssignedPriority(1)
            z.SetPadConnection(pcbnew.ZONE_CONNECTION_FULL)
            z.SetLocalClearance(mm(0.3)); z.SetMinThickness(mm(0.25))
            z.SetIslandRemovalMode(pcbnew.ISLAND_REMOVAL_MODE_ALWAYS)
            o = z.Outline(); o.NewOutline()
            for (x, y) in pts:
                o.Append(mm(x), mm(y))
            self.board.Add(z)
            self.pour_zone[ref] = z

    def plane(self):
        z = pcbnew.ZONE(self.board)
        z.SetLayer(pcbnew.B_Cu)
        z.SetNet(self.netmap["GND"])
        z.SetAssignedPriority(0)
        z.SetPadConnection(pcbnew.ZONE_CONNECTION_THT_THERMAL)
        z.SetThermalReliefGap(mm(0.3)); z.SetThermalReliefSpokeWidth(mm(0.5))
        z.SetLocalClearance(mm(0.3)); z.SetMinThickness(mm(0.25))
        z.SetIslandRemovalMode(pcbnew.ISLAND_REMOVAL_MODE_ALWAYS)
        o = z.Outline(); o.NewOutline()
        m = 0.3
        for (x, y) in ((m, m), (L.BOARD_W - m, m), (L.BOARD_W - m, L.BOARD_H - m), (m, L.BOARD_H - m)):
            o.Append(mm(x), mm(y))
        self.board.Add(z)
        self.plane_zone = z
        self.board.BuildConnectivity()
        pcbnew.ZONE_FILLER(self.board).Fill(self.board.Zones())
        for (net, x, y) in self.vias:
            if net == "GND" and not z.HitTestFilledArea(pcbnew.B_Cu, pt(x, y), 0):
                self.problems.append(f"the ground plane does not reach the ground via at ({x}, {y})")

    # ------------------------------------------------------- silkscreen --
    def _line(self, a, b, layer=pcbnew.F_SilkS, width=SILK_W):
        if abs(a[0] - b[0]) < 1e-6 and abs(a[1] - b[1]) < 1e-6:
            return
        s = pcbnew.PCB_SHAPE(self.board)
        s.SetShape(pcbnew.SHAPE_T_SEGMENT)
        s.SetStart(pt(*a)); s.SetEnd(pt(*b))
        s.SetLayer(layer); s.SetWidth(mm(width))
        self.board.Add(s)

    def _dashed(self, a, b, dash=1.2, gap=0.7, width=0.2):
        """A dashed line, drawn as its dashes (pcbnew's line styles are not reachable here)."""
        L_ = math.hypot(b[0] - a[0], b[1] - a[1])
        if L_ < 1e-6:
            return
        ux, uy = (b[0] - a[0]) / L_, (b[1] - a[1]) / L_
        t = 0.0
        while t < L_:
            e = min(t + dash, L_)
            self._line((a[0] + ux * t, a[1] + uy * t), (a[0] + ux * e, a[1] + uy * e), width=width)
            t = e + gap

    def _circle(self, cx, cy, r, filled=False, width=SILK_W, layer=pcbnew.F_SilkS):
        s = pcbnew.PCB_SHAPE(self.board)
        s.SetShape(pcbnew.SHAPE_T_CIRCLE)
        s.SetCenter(pt(cx, cy)); s.SetEnd(pt(cx + r, cy))
        s.SetFilled(filled); s.SetWidth(mm(width)); s.SetLayer(layer)
        self.board.Add(s)

    def _arc(self, cx, cy, r, a0, sweep, width=SILK_W):
        s = pcbnew.PCB_SHAPE(self.board)
        s.SetShape(pcbnew.SHAPE_T_ARC)
        s.SetCenter(pt(cx, cy))
        s.SetStart(pt(cx + r * math.cos(math.radians(a0)), cy + r * math.sin(math.radians(a0))))
        s.SetArcAngleAndEnd(pcbnew.EDA_ANGLE(sweep, pcbnew.DEGREES_T), True)
        s.SetLayer(pcbnew.F_SilkS); s.SetWidth(mm(width))
        self.board.Add(s)

    def _arc3(self, cx, cy, r, a0, a1, width=SILK_W):
        """An arc from screen angle a0 to a1 (degrees, y down, so increasing
        angle is clockwise on the board), fixed by its three points."""
        def at(a):
            return pt(cx + r * math.cos(math.radians(a)), cy + r * math.sin(math.radians(a)))
        s = pcbnew.PCB_SHAPE(self.board)
        s.SetShape(pcbnew.SHAPE_T_ARC)
        s.SetArcGeometry(at(a0), at((a0 + a1) / 2.0), at(a1))
        s.SetLayer(pcbnew.F_SilkS); s.SetWidth(mm(width))
        self.board.Add(s)

    def _arc_through(self, a, mid, b, width=SILK_W):
        s = pcbnew.PCB_SHAPE(self.board)
        s.SetShape(pcbnew.SHAPE_T_ARC)
        s.SetArcGeometry(pt(*a), pt(*mid), pt(*b))
        s.SetLayer(pcbnew.F_SilkS); s.SetWidth(mm(width))
        self.board.Add(s)

    @staticmethod
    def _seg_dist(p, a, b):
        (px, py), (ax, ay), (bx, by) = p, a, b
        dx, dy = bx - ax, by - ay
        L2 = dx * dx + dy * dy
        t = 0.0 if L2 < 1e-12 else max(0.0, min(1.0, ((px - ax) * dx + (py - ay) * dy) / L2))
        return math.hypot(px - (ax + t * dx), py - (ay + t * dy))

    def _poly(self, points, filled=True, layer=pcbnew.F_SilkS):
        s = pcbnew.PCB_SHAPE(self.board)
        s.SetShape(pcbnew.SHAPE_T_POLY)
        s.SetPolyPoints([pt(*p) for p in points])
        s.SetFilled(filled); s.SetWidth(mm(0.1)); s.SetLayer(layer)
        self.board.Add(s)

    def _text(self, x, y, txt, size, thickness=0.15, justify="center", angle=0, layer=pcbnew.F_SilkS):
        t = pcbnew.PCB_TEXT(self.board)
        t.SetText(txt)
        t.SetTextSize(pcbnew.VECTOR2I(mm(size), mm(size)))
        t.SetTextThickness(mm(thickness))
        t.SetLayer(layer)
        if layer == pcbnew.B_SilkS:
            t.SetMirrored(True)
        t.SetTextAngleDegrees(angle)
        t.SetHorizJustify({"center": pcbnew.GR_TEXT_H_ALIGN_CENTER, "left": pcbnew.GR_TEXT_H_ALIGN_LEFT,
                           "right": pcbnew.GR_TEXT_H_ALIGN_RIGHT}[justify])
        t.SetPosition(pt(x, y))
        self.board.Add(t)
        return t

    def keepouts(self):
        """Boxes the silkscreen wires must not cross: pads with clearance, and
        the bodies (courtyards) of every part, so a wire stops at the part the
        way a schematic wire stops at a symbol."""
        boxes = []
        for key, p in self.pads.items():
            boxes.append((p["x0"] - SILK_CLEAR, p["y0"] - SILK_CLEAR, p["x1"] + SILK_CLEAR, p["y1"] + SILK_CLEAR))
        for ref, fp in self.fps.items():
            if ref[:2] in ("TP", "MH"):
                continue
            poly = fp.GetCourtyard(pcbnew.F_CrtYd)
            if poly.OutlineCount():
                bb = poly.BBox()
                box = [tomm(bb.GetLeft()) - 0.4, tomm(bb.GetTop()) - 0.4, tomm(bb.GetRight()) + 0.4, tomm(bb.GetBottom()) + 0.4]
                boxes.append(tuple(box))
        self.boxes = boxes
        # a wire stops at a transistor's circle: the symbol takes it from there
        self.circles = [(g["cx"], g["cy"], g["R"] + 0.1)
                        for g in (self.q_geometry(ref) for ref in L.TRANSISTORS)]
        return boxes

    def clip(self, a, b):
        """Pieces of segment a-b that lie outside every keep-out box."""
        (x1, y1), (x2, y2) = a, b
        dx, dy = x2 - x1, y2 - y1
        cuts = []
        for (bx0, by0, bx1, by1) in self.boxes:
            # parametric overlap of the segment with the box (axis-aligned Liang-Barsky)
            t0, t1 = 0.0, 1.0
            ok = True
            for p, q in ((-dx, x1 - bx0), (dx, bx1 - x1), (-dy, y1 - by0), (dy, by1 - y1)):
                if abs(p) < 1e-9:
                    if q < 0:
                        ok = False
                        break
                    continue
                r = q / p
                if p < 0:
                    t0 = max(t0, r)
                else:
                    t1 = min(t1, r)
            if ok and t0 < t1:
                cuts.append((max(0.0, t0), min(1.0, t1)))
        for (qx, qy, qr) in getattr(self, "circles", ()):
            fx, fy = x1 - qx, y1 - qy
            A = dx * dx + dy * dy
            if A < 1e-12:
                continue
            B = 2 * (fx * dx + fy * dy)
            C = fx * fx + fy * fy - qr * qr
            disc = B * B - 4 * A * C
            if disc <= 0:
                continue
            r = math.sqrt(disc)
            t0, t1 = (-B - r) / (2 * A), (-B + r) / (2 * A)
            if t1 > 0 and t0 < 1:
                cuts.append((max(0.0, t0), min(1.0, t1)))
        cuts.sort()
        pieces, t = [], 0.0
        for (c0, c1) in cuts:
            if c0 > t:
                pieces.append((t, c0))
            t = max(t, c1)
        if t < 1.0:
            pieces.append((t, 1.0))
        out = []
        for (p0, p1) in pieces:
            if (p1 - p0) * math.hypot(dx, dy) < 0.25:
                continue
            out.append(((x1 + dx * p0, y1 + dy * p0), (x1 + dx * p1, y1 + dy * p1)))
        return out

    def silk_wires(self):
        self.keepouts()
        hopset = {(round(a[0], 3), round(a[1], 3), round(b[0], 3), round(b[1], 3)) for (_, a, b) in self.hops}
        hopset |= {(round(b[0], 3), round(b[1], 3), round(a[0], 3), round(a[1], 3)) for (_, a, b) in self.hops}
        ends = {}
        for (net, a, b, layer) in self.segments:
            if net == "GND":
                continue
            key = (round(a[0], 3), round(a[1], 3), round(b[0], 3), round(b[1], 3))
            if layer == pcbnew.B_Cu and key not in hopset:
                continue                     # back-only copper is not drawn: its flags are
            if key in hopset:
                # a hop: a semicircle over the wire it crosses, at the middle
                cx, cy = (a[0] + b[0]) / 2, (a[1] + b[1]) / 2
                r = 0.5
                if abs(a[1] - b[1]) < 1e-6:          # horizontal hop
                    self._line(a, (cx - r, cy)); self._line((cx + r, cy), b)
                    self._arc(cx, cy, r, 180, 180)
                else:                               # vertical hop
                    self._line(a, (cx, cy - r)); self._line((cx, cy + r), b)
                    self._arc(cx, cy, r, 270, 180)
                continue
            for (p, q) in self.clip(a, b):
                self._line(p, q)
            for e in (a, b):
                k = (round(e[0], 2), round(e[1], 2))
                ends.setdefault(k, set()).add(net)
        # junction dots: a point where three or more segment ends of one net meet,
        # or where a segment ends on the interior of another of the same net
        count = {}
        # the dashed back runs are drawn wires too: where one branches, it gets a dot
        front = [sg for sg in self.segments if sg[3] != pcbnew.B_Cu or sg[0] in L.DASHED_BACK]
        for (net, a, b, layer) in front:
            for e in (a, b):
                k = (net, round(e[0], 2), round(e[1], 2))
                count[k] = count.get(k, 0) + 1
        for (net, a, b, layer) in front:
            if net == "GND":
                continue
            for e in (a, b):
                for (n2, c, d, l2) in front:
                    if n2 != net or (c, d) == (a, b):
                        continue
                    if self._interior(e, c, d):
                        k = (net, round(e[0], 2), round(e[1], 2))
                        count[k] = max(count[k], 3)
        for (net, x, y), n in count.items():
            if net != "GND" and n >= 3 and not self._on_pad(x, y):
                self._circle(x, y, 0.5, filled=True, width=0)

    @staticmethod
    def _interior(p, a, b, tol=0.01):
        (px, py), (ax, ay), (bx, by) = p, a, b
        if abs(ay - by) < tol and abs(py - ay) < tol:
            return min(ax, bx) + tol < px < max(ax, bx) - tol
        if abs(ax - bx) < tol and abs(px - ax) < tol:
            return min(ay, by) + tol < py < max(ay, by) - tol
        return False

    def _on_pad(self, x, y, margin=0.55):
        """On, or within a dot's radius of, a pad: no junction dot there."""
        for p in self.pads.values():
            if p["x0"] - margin <= x <= p["x1"] + margin and p["y0"] - margin <= y <= p["y1"] + margin:
                return True
        return False

    def silk_grounds(self):
        """A ground symbol at every ground via (continuing the stub's direction)
        and under every ground connector post."""
        for (net, x, y) in self.vias:
            if net != "GND":
                continue
            ux, uy = self.stub_dir.get((round(x, 3), round(y, 3)), (0, 1))
            self.ground_symbol(x, y, ux, uy)
        for (x, y) in L.GND_MARKS:
            self.ground_symbol(x, y, 0, 1, start=1.3 + 0.4)
        for f in L.FLAGS:
            net, x, y = f[:3]
            dx, dy, just = f[3:6] if len(f) > 3 else (1.6, 0.05, "left")
            self.flag_symbol(x, y, net.replace("-15V", "-15 V").replace("+15V", "+15 V"), dx, dy, just)
        # signals that go round the back: dashed where they run
        for (net, a, b, layer) in self.segments:
            if layer == pcbnew.B_Cu and net in L.DASHED_BACK:
                self._dashed(a, b, dash=1.0, gap=0.6, width=0.2)

    def ground_symbol(self, x, y, ux, uy, start=0.55):
        """Three shortening bars across the direction (ux, uy), beyond `start`
        from the point: the schematic's ground, drawn the way the wire runs."""
        px, py = -uy, ux                 # across
        s0 = start + 0.5
        self._line((x + ux * start, y + uy * start), (x + ux * s0, y + uy * s0))
        for i, w in enumerate((1.4, 0.9, 0.4)):
            s = s0 + i * 0.45
            cx, cy = x + ux * s, y + uy * s
            self._line((cx - px * w / 2, cy - py * w / 2), (cx + px * w / 2, cy + py * w / 2), width=0.25)

    def q_geometry(self, ref):
        """The symbol round transistor `ref`, in board millimetres: where its
        leads leave the circle (so the wires can end there), the hairline
        from each pad to its lead, and the copper that follows the hairline and
        the lead out to the circle.  Worked out in a frame with the bar on the
        left and the collector up, then mirrored for a base on the right and
        for a PNP (collector down).  The SOT-23 must be turned so its base pad
        is on the bar's side; the lone (collector) pad then sits either under
        the collector leg or under the emitter leg, and the hairlines differ.

        The D2PAK is drawn round its leads, not round the whole package: its
        tab (the collector, 10.8 x 9.4 mm) caps the circle, which stops short
        of it, and the copper round the tab is the collector's pour.  The base
        lead runs straight through the base pad into a bar between the two
        leads; the collector leg ends at the tab, the emitter leg below the
        emitter pad, where the emitter's vertical leaves the circle."""
        if ref in self.qgeom:
            return self.qgeom[ref]
        kind, side = L.TRANSISTORS[ref]
        fp = self.fps[ref]
        cx, cy = tomm(fp.GetPosition().x), tomm(fp.GetPosition().y)
        m = 1 if side == "left" else -1
        n = 1 if kind == "NPN" else -1
        d2pak = "TO-263" in self.comps[ref]["footprint"]
        if d2pak:
            roles = (("1", "B"), ("2", "C"), ("3", "E"))
        else:
            R, BX, BH, BEND = 4.0, Q_BAR_X, Q_BAR_H, Q_BEND
            roles = (("1", "B"), ("2", "E"), ("3", "C"))

        def P(x, y):
            return (cx + m * x, cy + n * y)

        pins = {}
        for num, name in roles:
            p = self.pads[(ref, num)]
            pins[name] = (m * (p["x"] - cx), n * (p["y"] - cy), (p["x1"] - p["x0"]) / 2, (p["y1"] - p["y0"]) / 2)
        xb, yb, hwb, hhb = pins["B"]
        xe, ye, hwe, hhe = pins["E"]
        xc, yc, hwc, hhc = pins["C"]
        if not (xb < -0.5 and xe > 0.5 and abs(xc) < 0.1):
            raise SystemExit(f"{ref}: the package is not turned with its base pad on the bar's side (B {xb:.2f}, E {xe:.2f}, C {xc:.2f})")
        numof = {name: num for num, name in roles}
        nB, nC, nE = numof["B"], numof["C"], numof["E"]
        g = Q_STUB_GAP
        if d2pak:
            geom = self._d2pak_geometry(P, m, n, kind, xb, yb, hwb, xe, ye, hhe, (xc, yc, hwc, hhc), nB, nC, nE)
            self.qgeom[ref] = geom
            return geom

        L_ = math.hypot(BX, BEND - BH)
        u = (BX / L_, (BEND - BH) / L_)               # along the emitter leg, bar to bend

        def foot(sx, sy):                             # the point of the emitter leg square on to (sx, sy)
            t = (sx + BX) * u[0] + (sy - BH) * u[1]
            return (-BX + t * u[0], BH + t * u[1])

        stubs, copper = {}, {}
        # B: a hairline from the pad's inner edge straight across to the bar
        stubs["1"] = [(xb + hwb + g, yb), (-BX + Q_W_BAR / 2, yb)]
        copper["1"] = [(-R, 0), (-BX, 0), (-BX, yb), (xb, yb)]
        # C: straight along the collector's vertical, pad to bend
        stubs["3"] = [(0, yc - hhc - g), (0, -BEND)]
        copper["3"] = [(0, -R), (0, yc)]
        # E: square on to the emitter leg; round the lone pad first if it is in the way
        if ye > 0:
            e_s = (xe, ye + hhe + g)
            e_f = foot(*e_s)
            stubs["2"] = [e_s, e_f]
            copper["2"] = [(0, R), (0, BEND), e_f, e_s, (xe, ye)]
        else:
            e_s, e_m = (xe, ye + hhe + g), (xe, 2.1)
            e_f = foot(*e_m)
            stubs["2"] = [e_s, e_m, e_f]
            copper["2"] = [(0, R), (0, BEND), e_f, e_m, e_s, (xe, ye)]
        # the arrow is on the emitter leg: at its outer end pointing out for an
        # NPN, against the bar pointing in for a PNP
        if kind == "NPN":
            tip = (0, BEND)
            tail = (tip[0] - u[0] * 1.1, tip[1] - u[1] * 1.1)
        else:
            tip = (-BX + u[0] * 0.12, BH + u[1] * 0.12)
            tail = (tip[0] + u[0] * 1.1, tip[1] + u[1] * 1.1)
        px, py = -u[1], u[0]
        arrow = [tip, (tail[0] + px * 0.5, tail[1] + py * 0.5), (tail[0] - px * 0.5, tail[1] - py * 0.5)]
        geom = dict(
            cx=P(0, 0)[0], cy=P(0, 0)[1], R=R, wide=set(), arc=None,
            exit={nB: P(-R, 0), nC: P(0, -R), nE: P(0, R)},
            bar=[P(-BX, -BH), P(-BX, BH)],
            leads=[[P(-R, 0), P(-BX, 0)],
                   [P(-BX, -BH), P(0, -BEND), P(0, -R)],
                   [P(-BX, BH), P(0, BEND), P(0, R)]],
            arrow=[P(*q) for q in arrow],
            stubs={k: [P(*q) for q in v] for k, v in stubs.items()},
            copper={k: [P(*q) for q in v] for k, v in copper.items()},
            letters={"B": P(-3.0, -0.9), "C": P(1.15, -3.0), "E": P(1.15, 3.0)},
        )
        self.qgeom[ref] = geom
        return geom

    def _d2pak_geometry(self, P, m, n, kind, xb, yb, hwb, xe, ye, hhe, tab, nB, nC, nE):
        """q_geometry for a D2PAK, in its frame (the leads below the tab, the
        base lead on the left): see q_geometry.  The circle sits on the leads
        and its arc stops where it would come within the silk clearance of the
        tab; the legs are placed to clear the pads by the same."""
        xc, yc, hwc, hhc = tab
        tab_bot = yc + hhc                            # the tab's edge toward the leads
        clr = SILK_CLEAR + Q_W_LEAD / 2               # a lead's edge to a pad
        y0 = yb - 0.65                                # the circle's centre, on the base lead: 7.0
        R = 6.0
        BX, BH = 0.55, 1.6                            # the bar, between the leads, left of centre
        c_end = (1.4, tab_bot + clr + 0.03)           # the collector leg ends at the tab
        e_end = (xe, ye + 3.55)                       # the emitter leg ends under the emitter pad
        e_out = (xe, y0 + math.sqrt(R * R - xe * xe)) # where the emitter's vertical leaves the circle
        b_out = (-R, y0)
        # the arc: everything below the tab's clearance line
        cut = tab_bot + SILK_CLEAR + Q_W_CIRCLE / 2
        half = math.degrees(math.asin((y0 - cut) / R))   # the cut's angle above the horizontal
        # frame angles (y down): the arc runs from -half round through 90 (the bottom) to 180 + half
        def fa(a):
            return P(R * math.cos(math.radians(a)), y0 + R * math.sin(math.radians(a)))
        arc = (fa(-half), fa(90.0), fa(180.0 + half))
        # the base lead, interrupted by the base pad it runs through
        leads = [[b_out, (xb - hwb - clr, y0)],
                 [(xb + hwb + clr, y0), (-BX, y0)],
                 [(-BX, y0 - BH), c_end],
                 [(-BX, y0 + BH), e_end, e_out]]
        stubs = {nE: [(xe, ye + hhe + Q_STUB_GAP), e_end]}
        copper = {nB: [b_out, (xb, y0)], nE: [(xe, ye), e_out]}
        ux, uy = e_end[0] + BX, e_end[1] - (y0 + BH)
        L_ = math.hypot(ux, uy)
        u = (ux / L_, uy / L_)
        if kind == "NPN":
            tip = e_end
            tail = (tip[0] - u[0] * 1.1, tip[1] - u[1] * 1.1)
        else:
            tip = (-BX + u[0] * 0.15, y0 + BH + u[1] * 0.15)
            tail = (tip[0] + u[0] * 1.1, tip[1] + u[1] * 1.1)
        px, py = -u[1], u[0]
        arrow = [tip, (tail[0] + px * 0.5, tail[1] + py * 0.5), (tail[0] - px * 0.5, tail[1] - py * 0.5)]
        return dict(
            cx=P(0, y0)[0], cy=P(0, y0)[1], R=R, wide=set(), rail={nE}, arc=arc,
            exit={nB: P(*b_out), nC: P(xc, yc), nE: P(*e_out)},
            bar=[P(-BX, y0 - BH), P(-BX, y0 + BH)],
            leads=[[P(*q) for q in ld] for ld in leads],
            arrow=[P(*q) for q in arrow],
            stubs={k: [P(*q) for q in v] for k, v in stubs.items()},
            copper={k: [P(*q) for q in v] for k, v in copper.items()},
            letters={"B": P(-4.8, y0 - 1.1), "C": P(3.9, tab_bot + 1.25), "E": P(xe + 1.55, y0 + 2.4)},
        )

    def oa_geometry(self, ref):
        """The triangle round op-amp `ref` (SOT-23-5 at rotation 0): where the
        wires meet it, the hairline from each pad to its lead, and the copper
        under the hairlines.  exit: "1" + input, "3" - input, "4" output,
        "5" V+ (straight up from its pad through the top edge), "2" V- (the
        via under the bottom edge; pad 2's copper reaches it on the back)."""
        if ref in self.oageom:
            return self.oageom[ref]
        fp = self.fps[ref]
        cx, cy = tomm(fp.GetPosition().x), tomm(fp.GetPosition().y)
        if abs(fp.GetOrientationDegrees()) > 0.01:
            raise SystemExit(f"{ref}: op-amps are drawn at rotation 0 only")
        H, W, d = L.OA_H, L.OA_W, L.OA_IN
        xl, xr = cx - W / 2, cx + W / 2
        px, py = {}, {}
        for num in ("1", "2", "3", "4", "5"):
            p = self.pads[(ref, num)]
            px[num], py[num] = p["x"], p["y"]
        hw, hh = 0.66, 0.30                 # the pad's half size
        g = Q_STUB_GAP
        top_at = lambda x: cy - H / 2 + (x - xl) * (H / 2) / W      # the top edge's y at x
        vplus_x = px["5"]
        exit = {"1": (xl, cy - d), "3": (xl, cy + d), "4": (xr, cy),
                "5": (vplus_x, top_at(vplus_x)), "2": (cx, cy + L.OA_VM_DY)}
        via_in = (px["2"] - hw - g - 1.3, py["2"])
        stubs = {
            "1": [(px["1"], py["1"] - hh - g), (px["1"], cy - d), (xl, cy - d)],
            "3": [(px["3"], py["3"] + hh + g), (px["3"], cy + d), (xl, cy + d)],
            "4": [(px["4"] + hw + g, py["4"]), (px["4"] + 1.7, py["4"]), (px["4"] + 1.7, cy), (xr, cy)],
            "5": [(px["5"], py["5"] - hh - g), exit["5"]],
            "2": [(px["2"] - hw - g, py["2"]), via_in],
        }
        copper = {
            "1": [(px["1"], py["1"]), (px["1"], cy - d), (xl, cy - d)],
            "3": [(px["3"], py["3"]), (px["3"], cy + d), (xl, cy + d)],
            "4": [(px["4"], py["4"]), (px["4"] + 1.7, py["4"]), (px["4"] + 1.7, cy), (xr, cy)],
            "5": [(px["5"], py["5"]), exit["5"]],
            "2": [(px["2"], py["2"]), via_in],
        }
        geom = dict(cx=cx, cy=cy, exit=exit, via_in=via_in, stubs=stubs, copper=copper,
                    tri=[(xl, cy - H / 2), (xr, cy), (xl, cy + H / 2)],
                    plus=(xl + 1.5, cy - d + 1.4), minus=(xl + 1.5, cy + d - 1.4))
        self.oageom[ref] = geom
        return geom

    def silk_opamps(self):
        """The triangle round each op-amp, + and - inside at the inputs, a
        hairline from each pad to its lead, the V- flag under it."""
        for ref in L.OPAMPS:
            fp = self.fps[ref]
            for item in list(fp.GraphicalItems()):
                if item.GetLayer() == pcbnew.F_SilkS:
                    fp.Remove(item)
            g = self.oa_geometry(ref)
            t = g["tri"]
            for a, b in ((t[0], t[1]), (t[1], t[2]), (t[2], t[0])):
                self._line(a, b, width=Q_W_LEAD)
            for num, path in g["stubs"].items():
                for a, b in zip(path, path[1:]):
                    self._line(a, b, width=Q_W_STUB)
            # the dashed hairline: V- on its way to the back, out through the bottom
            self._dashed(g["via_in"], g["exit"]["2"], dash=0.5, gap=0.35, width=Q_W_STUB)
            self._text(*g["plus"], "+", 1.1, 0.2)
            self._text(*g["minus"], "-", 1.1, 0.2)
            self.flag_symbol(*g["exit"]["2"], "-15 V")

    def flag_symbol(self, x, y, text, dx=1.6, dy=0.05, justify="left"):
        """A power flag the way the sheet draws one: a bar across the point and
        the rail's name beside it."""
        self._line((x - 1.1, y), (x + 1.1, y), width=0.3)
        self._text(x + dx, y + dy, text, 0.8, 0.15, justify=justify)

    def silk_transistors(self):
        """The textbook symbol round each SOT-23: a circle, the base bar, the
        two legs at 45 degrees turning vertical to leave the circle, the arrow
        on the emitter, B C E lettered inside, and a hairline from each pad to
        its lead so the package is visibly the symbol's transistor.  The
        footprint's own outline is dropped; the wires outside stop at the
        circle (clip) and the copper inside follows the hairlines (wires)."""
        for ref in L.TRANSISTORS:
            fp = self.fps[ref]
            for item in list(fp.GraphicalItems()):
                if item.GetLayer() == pcbnew.F_SilkS:
                    fp.Remove(item)
            g = self.q_geometry(ref)
            if g["arc"]:
                self._arc_through(*g["arc"], width=Q_W_CIRCLE)
            else:
                self._circle(g["cx"], g["cy"], g["R"], width=Q_W_CIRCLE)
            self._line(g["bar"][0], g["bar"][1], width=Q_W_BAR)
            for lead in g["leads"]:
                for a, b in zip(lead, lead[1:]):
                    self._line(a, b, width=Q_W_LEAD)
            self._poly(g["arrow"])
            for path in g["stubs"].values():
                for a, b in zip(path, path[1:]):
                    self._line(a, b, width=Q_W_STUB)
            for name, (lx, ly) in g["letters"].items():
                self._text(lx, ly, name, 0.8, 0.15, justify="center")
            # caption: the reference, where the layout says (the type is in the band)
            fp.Value().SetVisible(False)
            fp.Reference().SetVisible(False)
            cap = L.Q_CAPTION[ref]
            tx, ty, just = cap[:3]
            size = cap[3] if len(cap) > 3 else 0.9
            ang = cap[4] if len(cap) > 4 else 0
            self._text(tx, ty, ref, size, 0.15, justify=just, angle=ang)
            if ref in L.HIDE_VALUE:
                pass
            elif ang:
                self._text(tx + 1.4 * size, ty, fp.Value().GetText(), size, 0.15, justify=just, angle=ang)
            else:
                self._text(tx, ty + 1.5 * size, fp.Value().GetText(), size, 0.15, justify=just)

    def silk_switch_marks(self):
        """A 1 and a 3 at the two ends of each slide switch, where the legends
        and the handbook say "1 = ..." and "3 = ..."."""
        for ref, marks in L.SW_MARKS.items():
            fp = self.fps[ref]
            cx, cy = tomm(fp.GetPosition().x), tomm(fp.GetPosition().y)
            a = math.radians(fp.GetOrientationDegrees())
            for num, (lx, ly) in marks.items():
                x = cx + lx * math.cos(a) + ly * math.sin(a)
                y = cy - lx * math.sin(a) + ly * math.cos(a)
                self._text(x, y, num, 0.8, 0.15, justify="center")

    def silk_fields(self):
        """Reference and value beside each part, where layout.FIELD_AT says."""
        for ref, fp in self.fps.items():
            if ref in L.TRANSISTORS or ref[:2] == "MH":
                continue
            cx, cy = tomm(fp.GetPosition().x), tomm(fp.GetPosition().y)
            at = L.FIELD_AT.get(ref)
            if at is None and ref in L.OPAMPS:
                at = ((1.8, -5.7), (1.8, -4.3))
            r = fp.Reference()
            r.SetTextSize(pcbnew.VECTOR2I(mm(0.8), mm(0.8))); r.SetTextThickness(mm(0.15))
            r.SetTextAngleDegrees(0); r.SetLayer(pcbnew.F_SilkS)
            v = fp.Value()
            v.SetTextSize(pcbnew.VECTOR2I(mm(0.8), mm(0.8))); v.SetTextThickness(mm(0.15))
            v.SetTextAngleDegrees(0); v.SetLayer(pcbnew.F_SilkS)
            if ref.startswith("TP"):
                # probe pins: the name only, beside the pin
                r.SetVisible(False)
                v.SetVisible(True)
                v.SetTextSize(pcbnew.VECTOR2I(mm(0.9), mm(0.9))); v.SetTextThickness(mm(0.15))
                where = L.TP_LABEL.get(ref, (1.6, 0.0, "left"))
                if where is None:                      # a loop on a labelled rail needs no name
                    v.SetVisible(False)
                    continue
                dx, dy, j = where
                v.SetPosition(pt(cx + dx, cy + dy))
                v.SetHorizJustify({"left": pcbnew.GR_TEXT_H_ALIGN_LEFT, "right": pcbnew.GR_TEXT_H_ALIGN_RIGHT,
                                   "center": pcbnew.GR_TEXT_H_ALIGN_CENTER}[j])
                continue
            if ref in L.HIDE_REF or (at and at[0] is None):
                r.SetVisible(False)
            elif at and at[0]:
                r.SetPosition(pt(cx + at[0][0], cy + at[0][1]))
                r.SetHorizJustify(pcbnew.GR_TEXT_H_ALIGN_LEFT if at[0][0] > 0.5 else
                                  pcbnew.GR_TEXT_H_ALIGN_RIGHT if at[0][0] < -0.5 else pcbnew.GR_TEXT_H_ALIGN_CENTER)
            if ref in L.HIDE_VALUE:
                v.SetVisible(False)
            elif at and at[1]:
                v.SetPosition(pt(cx + at[1][0], cy + at[1][1]))
                v.SetHorizJustify(pcbnew.GR_TEXT_H_ALIGN_LEFT if at[1][0] > 0.5 else
                                  pcbnew.GR_TEXT_H_ALIGN_RIGHT if at[1][0] < -0.5 else pcbnew.GR_TEXT_H_ALIGN_CENTER)

    def silk_arcs(self):
        """A clockwise arc over each knob and trimmer (layout.CW_ARCS): from
        a0 round to 12 o'clock, an arrowhead pointing the way the shaft turns
        clockwise, and beside it what that does.  The arc must not run into a
        drawn wire: checked here, since DRC does not mind ink over ink."""
        for ref, ((dx, dy), r, a0, label) in L.CW_ARCS.items():
            fp = self.fps[ref]
            cx, cy = tomm(fp.GetPosition().x) + dx, tomm(fp.GetPosition().y) + dy
            pts = [(cx + r * math.cos(math.radians(a)), cy + r * math.sin(math.radians(a)))
                   for a in range(a0, 271, 3)] + [(cx + 1.0, cy - r)]
            for (net, a, b, layer) in self.segments:
                if layer == pcbnew.B_Cu:
                    continue
                d = min(self._seg_dist(p, a, b) for p in pts)
                if d < 0.5:
                    raise SystemExit(f"{ref}'s clockwise arc runs into the {net} wire "
                                     f"{a} - {b} ({d:.2f} mm)")
            self._arc3(cx, cy, r, a0, 270)
            ty = cy - r
            self._poly([(cx + 1.0, ty), (cx - 0.1, ty - 0.45), (cx - 0.1, ty + 0.45)])
            self._text(cx + 1.6, ty, label, 0.8, 0.15, justify="left")

    def silk_boxes(self):
        """A dashed box round each stage, named as the book names it."""
        for (x0, y0, x1, y1, titles) in L.BOXES:
            for (a, b) in (((x0, y0), (x1, y0)), ((x1, y0), (x1, y1)), ((x1, y1), (x0, y1)), ((x0, y1), (x0, y0))):
                for (p, q) in self.clip(a, b):
                    self._dashed(p, q)
            for t in titles:
                title, tx, ty = t[:3]
                self._text(tx, ty, title, t[3] if len(t) > 3 else 0.95, 0.18, justify="left")

    def silk_texts(self):
        for (x, y, txt, size, thick, just, ang) in L.TEXTS:
            if size <= 0:
                continue
            self._text(x, y, txt, size, thick, justify=just, angle=ang)
        for ((x, y), size, lines) in L.LEGENDS:
            for i, line in enumerate(lines):
                self._text(x, y + i * size * 1.6, line, size, 0.15, justify="left")

    def silk_back(self):
        """The back: the title, how to use the board and a QR code to the
        project, mirrored so they read from the back; nothing is printed over
        the through-hole pads."""
        tx, ty = L.BACK_TITLE_AT
        self._text(tx, ty, parts.BOARD_NAME.upper(), 3.0, 0.5, layer=pcbnew.B_SilkS)
        self._text(tx, ty + 4.5, "Jason Gallicchio and Claude, rev " + parts.REV + ", " + parts.BOARD_DATE,
                   1.1, 0.15, layer=pcbnew.B_SilkS)
        for i, line in enumerate(L.BACK_TEXT):
            if isinstance(line, str):
                line = (0, line)
            y = L.BACK_Y + i * L.BACK_PITCH
            for k in range(0, len(line), 2):
                if line[k + 1]:
                    # mirrored: an indent moves the start toward smaller board x
                    self._text(L.BACK_X - line[k], y, line[k + 1], L.BACK_SIZE, 0.15,
                               justify="left", layer=pcbnew.B_SilkS)
        qx, qy = L.QR_AT
        n, rects = self.add_qr("https://" + parts.PROJECT_URL, qx, qy, L.QR_MODULE)
        half = n * L.QR_MODULE / 2
        self._text(qx, qy + half + 2.4, "https://" + parts.PROJECT_URL, 1.1, 0.15, layer=pcbnew.B_SilkS)
        self._text(qx, qy + half + 4.6, "circuit, scripts, schematic, this board", 1.0, 0.15, layer=pcbnew.B_SilkS)
        self.qr = (n, rects)

    def add_qr(self, url, cx, cy, module):
        """One QR code on the back as merged runs of filled rectangles, mirrored
        in board coordinates so it reads right from the back (the Lorenz
        board's add_qr).  Then every module is sampled back out of what was
        drawn and compared with the matrix."""
        import qrcode_gen
        m = qrcode_gen.encode(url, "M")
        n = len(m)
        x0, y0 = cx - n * module / 2.0, cy - n * module / 2.0
        rects = []
        for r in range(n):
            c = 0
            while c < n:
                if not m[r][c]:
                    c += 1
                    continue
                a = c
                while c < n and m[r][c]:
                    c += 1
                sh = pcbnew.PCB_SHAPE(self.board)
                sh.SetShape(pcbnew.SHAPE_T_RECT)
                sh.SetStart(pt(x0 + (n - c) * module, y0 + r * module))
                sh.SetEnd(pt(x0 + (n - a) * module, y0 + (r + 1) * module))
                sh.SetFilled(True); sh.SetWidth(0); sh.SetLayer(pcbnew.B_SilkS)
                self.board.Add(sh)
                rects.append((x0 + (n - c) * module, y0 + r * module, x0 + (n - a) * module, y0 + (r + 1) * module))
        ok = 0
        for r in range(n):
            for c in range(n):
                x = x0 + (n - 1 - c) * module + module / 2.0
                y = y0 + r * module + module / 2.0
                hit = any(rx0 <= x <= rx1 and ry0 <= y <= ry1 for (rx0, ry0, rx1, ry1) in rects)
                if hit == bool(m[r][c]):
                    ok += 1
        if ok != n * n:
            self.problems.append(f"QR: {n * n - ok} module(s) drawn wrong")
        # nothing drilled may sit under it
        for key, p in self.pads.items():
            if p["through"] and x0 - 1 < p["x"] < x0 + n * module + 1 and y0 - 1 < p["y"] < y0 + n * module + 1:
                self.problems.append(f"QR: through-hole pad {key} is under the code")
        for (net, vx, vy) in self.vias:
            if x0 - 1 < vx < x0 + n * module + 1 and y0 - 1 < vy < y0 + n * module + 1:
                self.problems.append(f"QR: via at ({vx}, {vy}) is under the code")
        return n, len(rects)

    # ------------------------------------------------------- the whole ---
    def build(self):
        self.place()
        self.wires()
        self.pours()
        self.plane()
        self.silk_wires()
        self.silk_grounds()
        self.silk_opamps()
        self.silk_transistors()
        self.silk_switch_marks()
        self.silk_fields()
        self.silk_arcs()
        self.silk_boxes()
        self.silk_texts()
        self.silk_back()
        self.fiducials()
        stabilise_uuids(self.board)
        pcbnew.SaveBoard(self.out_path, self.board)
        write_stackup(self.out_path)
        self.export_geometry()
        return self

    def fiducials(self):
        """Bare copper dots the assembler's camera finds the board by."""
        for (x, y) in L.FIDUCIALS:
            for layer, r in ((pcbnew.F_Cu, 0.5), (pcbnew.F_Mask, 1.0)):
                c = pcbnew.PCB_SHAPE(self.board)
                c.SetShape(pcbnew.SHAPE_T_CIRCLE)
                c.SetLayer(layer)
                c.SetStart(pt(x, y))
                c.SetEnd(pt(x + r, y))
                c.SetFilled(True)
                c.SetWidth(0)
                self.board.Add(c)

    def export_geometry(self):
        """Pad geometry for the cost estimate and the documents."""
        import json
        pads = [dict(ref=k[0], pad=k[1], net=p["net"], x=p["x"], y=p["y"],
                     w=p["x1"] - p["x0"], h=p["y1"] - p["y0"], through=p["through"]) for k, p in self.pads.items()]
        path = os.path.join(os.path.dirname(self.out_path), "..", "out", "pcb_geom.json")
        os.makedirs(os.path.dirname(path), exist_ok=True)
        json.dump({"board_w": L.BOARD_W, "board_h": L.BOARD_H, "pads": pads,
                   "tracks": len(self.segments), "vias": len(self.vias), "hops": len(self.hops),
                   "heat": self.heat_geometry()},
                  open(path, "w"), indent=1)

    def heat_geometry(self):
        """The copper the push-pull's heat spreads through, for sim/thermal.py:
        each pour as filled (outlines, each with its holes), the tab's pad, and
        the ground plane as filled on the back."""
        def polys(zone, layer):
            ps = zone.GetFilledPolysList(layer)
            out = []
            for i in range(ps.OutlineCount()):
                rings = [ps.Outline(i)] + [ps.Hole(i, h) for h in range(ps.HoleCount(i))]
                out.append([[(round(tomm(c.CPoint(k).x), 3), round(tomm(c.CPoint(k).y), 3))
                             for k in range(c.PointCount())] for c in rings])
            return out
        heat = {"plane": polys(self.plane_zone, pcbnew.B_Cu)}
        for ref, z in self.pour_zone.items():
            p = self.pads[(ref, "2")]
            heat[ref] = {"pour": polys(z, pcbnew.F_Cu), "tab": [p["x0"], p["y0"], p["x1"], p["y1"]],
                         "value": self.comps[ref]["value"]}
        return heat


def stabilise_uuids(board):
    """Give every board item a UUID derived from what it is, so rebuilds diff
    only where the design changed (the Lorenz board's trick)."""
    import uuid as _uuid

    def kiid(key):
        return pcbnew.KIID(str(_uuid.uuid5(_uuid.NAMESPACE_URL, "laoe-motorpid-pcb://" + key)))

    def mm2(pos):
        return f"{tomm(pos.x):.4f},{tomm(pos.y):.4f}"

    n = 0
    for fp in board.GetFootprints():
        ref = fp.GetReference()
        fp.SetUuid(kiid(f"fp/{ref}"))
        for pad in fp.Pads():
            n += 1
            pad.SetUuid(kiid(f"fp/{ref}/pad/{pad.GetNumber()}/{mm2(pad.GetPosition())}/{n}"))
        for i, it in enumerate(fp.GraphicalItems()):
            it.SetUuid(kiid(f"fp/{ref}/gfx/{i}/{it.GetClass()}"))
        for f in fp.GetFields():
            f.SetUuid(kiid(f"fp/{ref}/field/{f.GetName()}"))
    for i, t in enumerate(board.GetTracks()):
        if isinstance(t, pcbnew.PCB_VIA):
            t.SetUuid(kiid(f"via/{mm2(t.GetPosition())}/{t.GetNetname()}/{i}"))
        else:
            t.SetUuid(kiid(f"trk/{t.GetLayerName()}/{mm2(t.GetStart())}/{mm2(t.GetEnd())}/{t.GetNetname()}/{i}"))
    for i, z in enumerate(board.Zones()):
        z.SetUuid(kiid(f"zone/{z.GetLayerName()}/{z.GetNetname()}/{i}"))
    for i, d in enumerate(board.GetDrawings()):
        txt = d.GetText() if hasattr(d, "GetText") else ""
        d.SetUuid(kiid(f"gfx/{d.GetLayerName()}/{d.GetClass()}/{mm2(d.GetPosition())}/{txt[:40]}/{i}"))


if __name__ == "__main__":
    netlist = sys.argv[1] if len(sys.argv) > 1 else os.path.join(HW, "..", "out", "motorpid.net")
    out = sys.argv[2] if len(sys.argv) > 2 else os.path.join(HW, "motorpid.kicad_pcb")
    b = Board(netlist, out).build()
    ntr = sum(1 for t in b.board.GetTracks() if not isinstance(t, pcbnew.PCB_VIA))
    print(f"  wrote {os.path.relpath(out)}: {len(b.fps)} footprints, {ntr} tracks, {len(b.vias)} vias, "
          f"{len(b.hops)} hops")
    if b.problems:
        print(f"  !! {len(b.problems)} wiring problem(s):")
        for p in b.problems:
            print(f"     {p}")
        raise SystemExit(1)
