gallicchio/motor-pid/(commit log)

2026-10-25 Lab 10L PID motor loop: parts table, footprints, generated schematic (ERC clean), circuit checks
    Claude-Session: https://claude.ai/code/session_017Q2PYKR2UewvTfQgKmRJsG
    [motorpid.kicad_sch]
2026-10-25 Simulate the loop from the exported netlist (ngspice, fader model); 22 nF D capacitor, 0.35 A fuse
    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
    [motorpid.kicad_sch]
2026-10-25 Move TARGET IN BNC off the knob's wire column (its shield grounded the knob's bottom end); add shorted-part and knob-end netlist checks
    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
    [motorpid.kicad_sch]
2026-10-25 Drop the output current limiter (the PTC is the protection; the 1 ohm emitter resistors stay as current sense); knob pin 3 on the + end so clockwise is positive; make.py for this project
    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
    [motorpid.kicad_sch]
2026-10-25 D/I switches: pole 3 into the sum, pole 1 shorts; D capacitor switch ahead of its capacitors (common on the ERROR side), so each slide switch's three wires leave its one-sided pins without crossing
    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
    [motorpid.kicad_sch]
2026-10-25 Board layout: 170 x 120 mm, the silkscreen is the schematic (op-amp triangles, DPAK symbols with pours, -15 V and POSITION on the back as flags and a dashed line), DRC 0
    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
    [motorpid.kicad_pcb]
2026-10-25 Fab package, documents, simulation update and chat log for rev A: build passes end to end (ERC 0, 243 circuit checks, DRC 0, fab checks, 23 document claims)
    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
    [motorpid-B_Cu.gbr, motorpid-B_Mask.gbr, motorpid-B_Paste.gbr, motorpid-B_Silkscreen.gbr, motorpid-Edge_Cuts.gbr, motorpid-F_Cu.gbr, motorpid-F_Mask.gbr, motorpid-F_Paste.gbr]
2026-10-25 Chat log: prompts 3-5 and Response 2 (the slide-switch pole explanation and the open questions)
    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
2026-10-25 Clockwise arcs over the knob and the three trimmers (Bourns CW = terminal 3; rheostats 1-2, wiper ties under the bodies); handbook's I GAIN direction fixed; Jason's answers recorded: fuse kept, size 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
    [motorpid-B_Cu.gbr, motorpid-B_Mask.gbr, motorpid-B_Silkscreen.gbr, motorpid-F_Cu.gbr, motorpid-F_Mask.gbr, motorpid-F_Paste.gbr, motorpid-F_Silkscreen.gbr, motorpid-PTH-drl_map.gbr]
2026-10-25 Chat log: Prompt 8 (keep the TARGET SOURCE switch)
    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
2026-10-25 Probe loops on BASES, U6 OUT and U7 OUT; LOOP explained on the schematic, front, back and handbook (open = DRIVE from TARGET); ground moved clear of RV4's I; back silkscreen rewritten one item per li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
    [motorpid-B_Cu.gbr, motorpid-B_Mask.gbr, motorpid-B_Silkscreen.gbr, motorpid-F_Cu.gbr, motorpid-F_Mask.gbr, motorpid-F_Paste.gbr, motorpid-F_Silkscreen.gbr, motorpid-PTH-drl_map.gbr]
2026-10-27 Fader measured and identified: Bourns PSM01-082A-103B2 (taper B2, A+ toward 1), plant refit to Jason's bench numbers (14 ohm, 2-3 V breakaway, 0.16 A running); stick-slip triangle sim; D rule now 234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
    [motorpid.kicad_pcb, motorpid.kicad_sch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]
2026-10-27 Stall cooling compared: sim/thermal.py board model; D2PAK on 2 oz copper (~110 C junction) vs the lab's MJE3055T/2955T on heatsinks (50-90 C); recommendation recorded, Jason to choose
    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
    [motorpid.kicad_sch]
2026-10-27 Push-pull on D2PAKs and 2 oz copper (Jason's choice): MJB44H11/MJB45H11 in pours that are their heatsink, 120/122 C junctions in the worst stall, checked on the board as built
    - parts: MJB44H11T4G C233689 / MJB45H11T4G C154570, TO-263-2; JLCPCB draws
    them turned 180 (CPL +180, datum 2.45 mm toward the leads, predicted)
    - layout: Q1/Q2 symbols drawn round the leads with the tab capping the
    circle; pours fill the MOTOR DRIVER box round each tab (836 / 670 mm2);
    R21/R22 in two columns; D3/D4 with their rail ends in the pours; snubber
    under DRIVE; BASES crosses Q2's emitter wire on the back (one hop: the
    mirrored PNP makes the crossing topological)
    - back runs moved off the plane under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
    [motorpid-B_Cu.gbr, motorpid-B_Silkscreen.gbr, motorpid-F_Cu.gbr, motorpid-F_Mask.gbr, motorpid-F_Paste.gbr, motorpid-F_Silkscreen.gbr, motorpid-PTH-drl_map.gbr, motorpid-PTH.drl]
2026-10-27 Design review round 1: the brief (spirit of the lab down to the copper), the reviews' README, working copies ignored; the 10-board PCB step computed
    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
2026-10-27 Design review round 1: the author's review (order after two fixes: switch ends unnumbered; DRIVE probed ahead of the fuse), simulations, crops and patch_round1.diff (not applied); chat log Response 10
    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
2026-10-27 Review round 1 applied (Jason): the patch, the fuse between the push-pull and DRIVE, the integrator's capacitor a 1 uF polypropylene film
    - patch_round1.diff as it stood: switch-end numbers, three vias each end of Q2's -15 V run,
    TARGET IN at +/-3 V, standoffs, handbook table and gains recipe, R4's run off the URL,
    sheet notes; its "DRIVE ahead of the fuse" warnings rewritten for the moved fuse
    - F1 right after R21/R22: the feedback, the DRIVE loop, DRIVE OUT and the motor terminal
    behind it; clamps and snubber stay at the transistors; MOTOR merged into DRIVE (17 loops);
    check_circuit asserts what is ahead of the fuse and that no loop or connector is
    - C8: Panasonic ECWF2W105JA 1 uF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
    [motorpid-B_Cu.gbr, motorpid-B_Mask.gbr, motorpid-B_Silkscreen.gbr, motorpid-F_Cu.gbr, motorpid-F_Mask.gbr, motorpid-F_Paste.gbr, motorpid-F_Silkscreen.gbr, motorpid-PTH-drl_map.gbr]
2026-10-28 Review round 1 closed: Gemini-4-Argon's and KimiK3's findings applied (RV1's JLCPCB rotation, the fuse's stall story and its 60 V grade, rail clamps D5/D6, the LM321's real swing, step metrics that n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
    - RV1 (C351173): +270 and (3.5, -2.5); JLCPCB's drawing overlaid by the new CPL lands on our pins
    - F1: LUTE 1812L035/60GR (C18198330), same hold/trip/R; every document now says a short opens it
    in about a second and a full-drive stall (0.61 A, between hold and trip) may take minutes or never
    - D5, D6 (SS34) clamp each rail to ground: one rail left open cannot reverse-bias its electrolytic
    - sim: LM321 o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
    [motorpid-B_Cu.gbr, motorpid-B_Silkscreen.gbr, motorpid-F_Cu.gbr, motorpid-F_Mask.gbr, motorpid-F_Paste.gbr, motorpid-F_Silkscreen.gbr, motorpid-PTH-drl_map.gbr, motorpid-PTH.drl]
2026-10-30 Rev A pre-order checks from the newer lessons; BOARD_DATE 2026-10-29: the screw terminals turned (KF301 wire face 3.6 mm from the pins, JLCPCB's drawing +180), PLACEMENT_CHECKS prints every row (J3, 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
    [motorpid-B_Cu.gbr, motorpid-B_Mask.gbr, motorpid-B_Paste.gbr, motorpid-B_Silkscreen.gbr, motorpid-Edge_Cuts.gbr, motorpid-F_Cu.gbr, motorpid-F_Mask.gbr, motorpid-F_Paste.gbr]
2026-10-30 JLCPCB's preview read back: the 3362P's body 1.30 mm toward pins 1 and 3 (BOCHEN's drawing; outline, courtyard, model; RV2 with R14 up 1.1 mm, RV4 up 0.5), the MSK12C02 placed by its body (datum 0.55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
    [motorpid-B_Cu.gbr, motorpid-B_Mask.gbr, motorpid-B_Silkscreen.gbr, motorpid-F_Cu.gbr, motorpid-F_Mask.gbr, motorpid-F_Paste.gbr, motorpid-F_Silkscreen.gbr, motorpid-PTH-drl_map.gbr]
2026-11-10 README opens with the board on the bench: a 4 s GIF of the fader following a function generator, linking to the whole 13 s video (re-encoded 1280x720, 2.5 MB; the 27 MB original stays in the ignored 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
